zapta/daq/README.md

# Data Acquisition

| :warning: WARNING|
|:---|
| This design is an unverified work in progress (as of May 2023).|

* [Backplane](./backplane/README.md)
* [Proto board](./proto_board/README.md)
* [Controller board](./controller/README.md)
* [Power supply board](./power_supply/README.md)
