zapta/daq/controller/docs/packet_formats.odt

Controller Log Packet Format

June 2023

## Background

The controller logs the data it acquires on the SD card in a file that is made of a sequence of packets whose envelope conforms to the Serial Packet protocol. This document outlines the format of the payload data within those log packets.

Design decision #1: Time resolution of log events is 1ms.

Design decision #2: The data points are grouped by channels and the timestamp of data points of each channels are monotonic within the packet and across packets.

## Overall packet structure

The log packets are encoded as Serial Packets protocol packets of type LOG (packet type 3) which contain the following parts.

Packet Data:

- Packet Header
- Value Sequence 1
- …
- Value Sequence n

Each value sequence contains 1 or more values of a single channel, with fixed time interval between them. A packet can contain multiple value sequences of the same channel but they must be monotonic time-wise such as all values in a value sequence have later time that all values in all previous value sequences of same channel. There is not requirements for time monotonically for values of different channels.

Packet Header:

- UINT8: Packet format version. As of June 2023, the only valid version is 1.
- UINT32: Device session ID. A random 32 bits value is that generated each time the device reboots.
- UINT32 : Packet base time in milliseconds. This is a device time in milliseconds that is the base timestamp of this packet. These values wrap around after 50 days of device operations, and it’s responsibility of the reader to handle this wraparound gracefully. Typically is typically the time of the earliest event in the packet (time-wise, not by order within the packet), it’s not guaranteed.

Value Sequence

Each value sequence has the following format.

- STRING: Channel id. A short string that identify the channel. See below for the channel id string for each channel type.
- UINT16: First value offset in milliseconds. The time interval, in milliseconds, from the base time of the packet to the time of the first value in this sequence.
- UINT16: Number of values in this sequence. N >= 1.
- UINT16: (optional) Values interval. This is the time in milliseconds between two consecutive values in this sequence. This field should be included only iff number of values > 1.
- [Any]…: The values in this sequence. The format of the values depends on the channel and is specified below.

## Marker Channel Data

- Channel id “mrk”
- Item count: marker channel sequence contains exactly 1 value and thus doesn’t have the interval value.
- Sequence values: String values. Each string is represented by a UINT8 value representing the number of characters (not including null termination) followed by UINT8 with the individual ASCII character in their order in the string. As of July 2023, the marker strings are subject to these constrains:
  - Length 1 to 30 ASCII characters.
  - Valid characters are alphanumeric (lower and upper case) as well as ‘-’, ‘_’, ‘.’, or ‘:’. Other characters can be supported if needed.

## Load Cell Channels

- Channel ids: “lc1” to “lc9”
- Sequence values: big endian int24 values representing the raw ADC reading.

## Temperature Channel Data

- Channel ids: “tm1” to “tm9”
- Sequence values: big endian int24 values representing the raw ADC reading.

## Power Channel Data

- Channel ids: “pw1” to “pw9”
- Sequence values:
  - Big endian int16. Raw ADC reading of RMS voltage.
  - Big endian int16. Raw ADC reading of RMS current.
