zapta/daq/adc/docs/ADS1261-60 Design Calculator.xlsx

Sheet: Table of Contents
Worksheets | Description
Common-Mode Range | Calculates if a given set of input voltages are within the PGA's input range limitations
Code Conversions | Converts ADC codes to their corresponding voltages
Digital Filter | Calculates the digital filter's frequency response
CRC | Calculates the CRC byte
About | Information about this tool
Help | Documentation and supporting links

Sheet: Common-Mode Range
 |  |  |  |  |  |  |  |  |  |  |  |  | Table of Contents
 | 1) Configure ADC parameters
 | PGA Gain |  |  |  |  |  |  |  |  |  |  |  |  | Legend
 | PGA Gain | 2 | V/V |  |  | PGA INPUT |  |  | PGA OUTPUT |  |  |  | Input = | #
 | Supply Voltage(s) |  |  |  |  |  |  |  |  |  |  |  | Result = | #
4.75 V ≤ | AVDD | 5 | V | ≤ 5.25 V |  |  |  |  |  |  |  |  | Invalid Parameter = | #
-2.6 V ≤ | AVSS | 0 | V | ≤ 0 V
 | Reference Voltage(s)
0.9 V ≤ | VREFP | 2.5 | V | ≤ 5 V
-0.05 V ≤ | VREFN | 0 | V | ≤ 1.6 V
 | 2) Define input voltages
 | Input Voltage
 | Input Mode | Differential/CM Voltages
-1.25 V ≤ | VIN_DIFF | 1 | V | ≤ 1.25 V
1.3 V ≤ | VIN_CM | 2.5 | V | ≤ 3.7 V
 | 3) Check for errors
 | Error messages |  |  |  |  | PGA Input |  |  |  | PGA Output
 | V(AVDD-AVSS) | ← Supply voltage(s) is out-of-range! |  |  | 0.8667 V ≤ | VINP | 3 | ≤ 3.25 V | 0.3 V ≤ | VOUTP | 3.5 | ≤ 4.7 V
 | V(REFP-REFN) | ← Reference voltage(s) is out-of-range! |  |  |  | VINN | 2 |  |  | VOUTN | 1.5
 | VIN_DIFF | ← Input exceeds the maximum differential voltage (±1.25 V)! |  |  | -1.25 V ≤ | VIN_DIFF | 1 | ≤ 1.25 V | -2.5 V ≤ | VOUT_DIFF | 2 | ≤ 2.5 V
 | VINP | ← Positive input voltage is out-of-range! |  |  | 1.3 V ≤ | VIN_CM | 2.5 | ≤ 3.7 V |  | VOUT_CM | 2.5
 | VINN | ← Negative input voltage is out-of-range!

Sheet: Code Conversions
 |  |  |  |  |  |  | Table of Contents
 |  |  |  |  |  |  |  | Legend
ADC Parameters |  |  |  | ADC Input Range & Least Significant Bit (LSB) Size |  |  | Input = | #
PGA Gain | 1 | [V/V] | → | Differential Input Range | +/-2.50 | [V] | Result = | #
Reference Voltage | 2.50 | [V] |  | LSB size | 298.023 | [nV]
ADC Output Code (2's Compliment) |  |  |  | Input Voltage RTI (1)
7F0000 |  | [Hex] | → | 2.480468750 |  | [V]
Input a hex value between 800000 and 7FFFFF
Differential Input Voltage RTI (1) |  |  |  | Ideal Output Code (2)
1.000000000 |  | [V] | → | 333333 |  | [Hex]
 |  |  |  | Output Code Clipped!
Notes:
(1) "RTI" means "referred to input" (i.e. the voltage applied to the input pins, prior to the PGA gain)
(2) Ideal output code (i.e. ignoring the effects of noise, INL, calibration, etc.)

Sheet: Digital Filter
 |  |  |  |  |  |  |  |  | Table of Contents
 |  |  |  |  |  | NOTE: The effect of averaging from chopping or ac-excitation modes is not shown in the filter response.
MODE0 Settings |  |  |  |  |  |  |  |  | Legend
DR[4:0] - nominal data rate (SPS) |  |  | 20 |  |  |  |  | Input = | #
FILTER[2:0] - filter type |  |  | FIR |  |  |  |  | Result = | #
 |  |  |  |  |  |  |  | Frequency Resolution
MODE1 Settings |  |  |  |  |  |  |  | Range | Step size
CHOP[1:0] - chop mode |  |  | Normal mode (default) |  |  |  |  | 0-100 Hz | 0.1 Hz
CONVRT - conversion mode |  |  | Continuous mode (default) |  |  |  |  | 100-1000 Hz | 1 Hz
DELAY[3:0] - conversion start delay |  |  | 50 μs (default) |  |  |  |  | 1000-50,000 Hz | 10 Hz
 |  |  |  |  |  |  |  | 50k - 100 kHz | 100 Hz
 |  |  |  |  |  |  |  | 100k - 1.4 MHz | 1000 Hz
Clock |  |  |  |  |  |  |  | > 1.4 MHz | no data
Clock Frequency, fCLK (MHz) |  |  | 7.3728 MHz |  |  |  |  | Note: Due to larger step sizes, the "Digital Filter Frequency Response" plot may appear distorted or lack detail at higher frequencies.
Notes:
- The actual data rate and /DRDY period will scale with the clock frequency.
- The internal oscillator automatically increases to 10.24 MHz @ 40 kSPS.
- The "Clock Frequency" field only needs to be changed if you are using an external clock source with a different frequency, or if you are evaluating the effects of the clock frequency tolerance on the digital filter response.
 |  |  |  |  |  |  | Right click on the x-axis to adjust the displayed frequency range…
Bandwidth |  |  |  |  |  | Digital Filter Block Diagram
-3 dB Cutoff Frequency (Hz) |  |  | 13.20
Effective Noise Bandwidth (Hz) |  |  | 13.94
Normal Mode Rejection
Frequency (Hz) |  |  | 60
Tolerance (± Δ Hz) |  |  | 1
Minimum Attenuation |  |  | -95.15 dB
(59 - 61 Hz)
Conversion Time & Period |  |  | (ms) |  | (SPS)
Time to 1st Conversion (1)(4) |  |  | 52.23 | = | 19.15
On-going Conversion Period (2)(4) |  |  | 50.00 | = | 20.00
Time to conversion graph data
X
0.00 | 52.23 | 102.23 | 152.23 | 202.23 | 252.23
0 | 52.23 | 102.23 | 152.23 | 202.23 | 252.23
Y
0.00 | 0 | 0 | 0 | 0 | 0
1 | 1 | 1 | 1 | 1 | 1
(1) This is the latency of the first conversion result. When multiplexing between channels, this latency limits the overall data throughput and effective data rate.
(2) Time between conversion results. This is the data rate for single channel, continuous conversions.
(3) For continous conversion mode, only the first 5 conversions are shown.
(4) Calculated results are within about +/- 30 us of actual device behavior, not accounting for clock errors.

Sheet: CRC
 |  |  |  |  |  |  |  |  |  |  |  |  |  |  |  |  |  |  |  |  |  |  |  |  |  |  |  |  |  |  |  |  |  |  |  |  | Table of Contents
 | Legend |  | Input hex data (without the prefix or postfix)
 | # | = Input | Hex Data (1 to 4 bytes) |  |  |  |  |  | 3300
 | # | = Result | NOTE: If needed, add an apostrophy (') before the number to avoid Excel's type conversion.
 |  |  | Calculated Results
 |  |  | # Bytes / CRC-n |  |  |  |  |  | 2
 |  |  | CRC Result (Hex) |  |  |  |  |  | 0x11
↓ Calculations ↓
 |  |  |  |  |  |  |  |  |  |  |  |  |  | Polynomial = |  |  |  | x8 + x2 + x1 + 1
 |  |  |  |  | Each column represents a bit shift in the CRC shift register →
 |  |  |  |  | CRC-1 |  |  |  |  |  |  |  | CRC-2 |  |  |  |  |  |  |  | CRC-3 |  |  |  |  |  |  |  | CRC-4
 |  |  | Data IN: |  | 0 | 0 | 1 | 1 | 0 | 0 | 1 | 1 | 0 | 0 | 0 | 0 | 0 | 0 | 0 | 0 | - | - | - | - | - | - | - | - | - | - | - | - | - | - | - | -
 |  |  | MSB | 1 | 1 | 1 | 1 | 1 | 1 | 0 | 1 | 0 | 1 | 1 | 0 | 1 | 0 | 1 | 1 | 0 | - | - | - | - | - | - | - | - | - | - | - | - | - | - | - | -
 |  |  | Initial Data | 1 | 1 | 1 | 1 | 1 | 0 | 1 | 0 | 1 | 1 | 0 | 1 | 0 | 1 | 1 | 0 | 0 | - | - | - | - | - | - | - | - | - | - | - | - | - | - | - | -
 |  |  |  | 1 | 1 | 1 | 1 | 0 | 1 | 0 | 1 | 1 | 0 | 1 | 0 | 1 | 1 | 0 | 0 | 0 | - | - | - | - | - | - | - | - | - | - | - | - | - | - | - | -
 |  |  |  | 1 | 1 | 1 | 0 | 1 | 0 | 1 | 1 | 0 | 1 | 0 | 1 | 1 | 0 | 0 | 0 | 1 | - | - | - | - | - | - | - | - | - | - | - | - | - | - | - | -
 |  |  |  | 1 | 1 | 0 | 1 | 0 | 1 | 1 | 0 | 1 | 0 | 1 | 1 | 0 | 0 | 0 | 1 | 0 | - | - | - | - | - | - | - | - | - | - | - | - | - | - | - | -
 |  |  |  | 1 | 0 | 1 | 0 | 1 | 1 | 0 | 1 | 0 | 1 | 1 | 0 | 0 | 0 | 1 | 0 | 0 | - | - | - | - | - | - | - | - | - | - | - | - | - | - | - | -
 |  |  |  | 1 | 0 | 0 | 1 | 0 | 1 | 0 | 0 | 1 | 0 | 1 | 0 | 1 | 1 | 1 | 1 | 0 | - | - | - | - | - | - | - | - | - | - | - | - | - | - | - | -
 |  |  | LSB | 1 | 1 | 1 | 0 | 0 | 1 | 1 | 1 | 0 | 0 | 1 | 1 | 0 | 1 | 0 | 1 | 1 | - | - | - | - | - | - | - | - | - | - | - | - | - | - | - | -
 |  |  | Result: |  | - |  |  |  |  |  |  |  | 0x11 |  |  |  |  |  |  |  | - |  |  |  |  |  |  |  | -
 |  |  |  |  | Each column represents a bit shift in the CRC shift register. The last column in each byte is the result of the CRC-n calculation.

Sheet: About
Version Number | 1.0.2 | Table of Contents
Created by | Chris Hall
Version History
Version | Change List Description
1.0.0 | Initial Release
1.0.1 | Fixed error in data rate calculation when chop/ac excitation mode enabled
1.0.2 | Fixed error in input signal limits in the Common-Mode Range calculator.

Sheet: Help
For any futher assistance on this tool, please post your question in the following forum - E2E Precision Data Converters Forum (http://e2e.ti.com/support/data_converters/precision_data_converters/) |  |  |  | Table of Contents
Getting Started with this tool ?
 | 1. Reference the product datasheet, found at the URLs below, for information about the particular device.
 |  | ADS1261: | http://www.ti.com/lit/gpn/ads1261
 |  | ADS1260 | http://www.ti.com/lit/gpn/ads1260
 | 2. Go to the Table of Contents for tool descriptions and links to specific worksheets.
 |  | Link: | Table of Contents
 | 3.Use the "Legend" on each worksheet for guidance. The required inputs and calculated results typically follow the convention below:
 |  | # | = Input
 |  | # | = Result
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
