zapta/daq/controller/docs/sdcard_spi_ioc.png

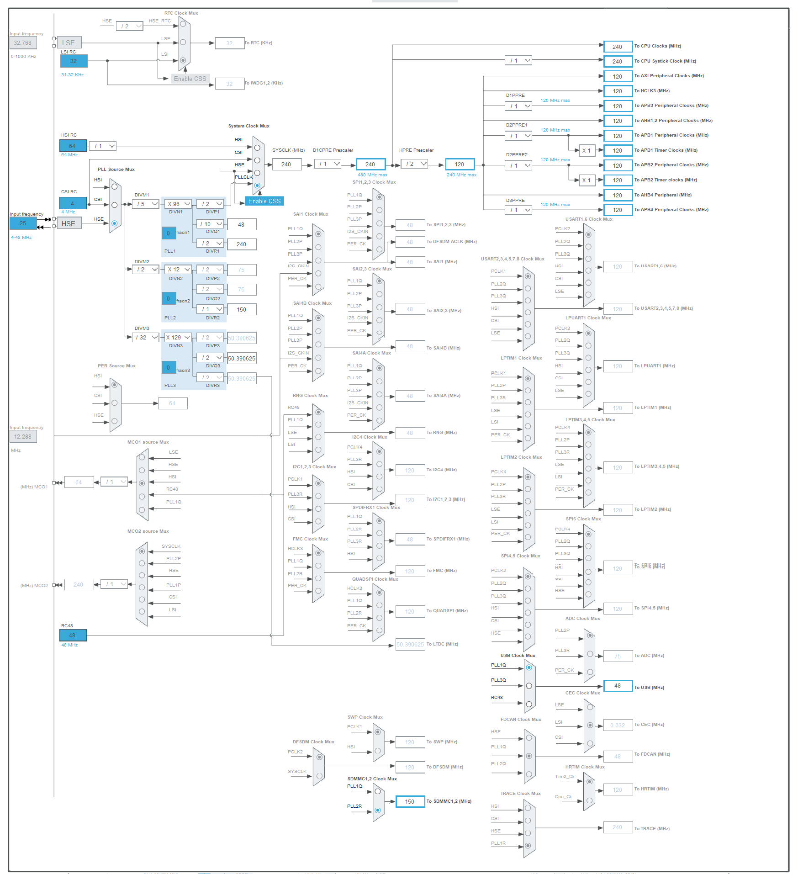
controller/docs/sdcard_spi_ioc.png
