zapta/daq/hookup_board/kicad/hookup_board.png

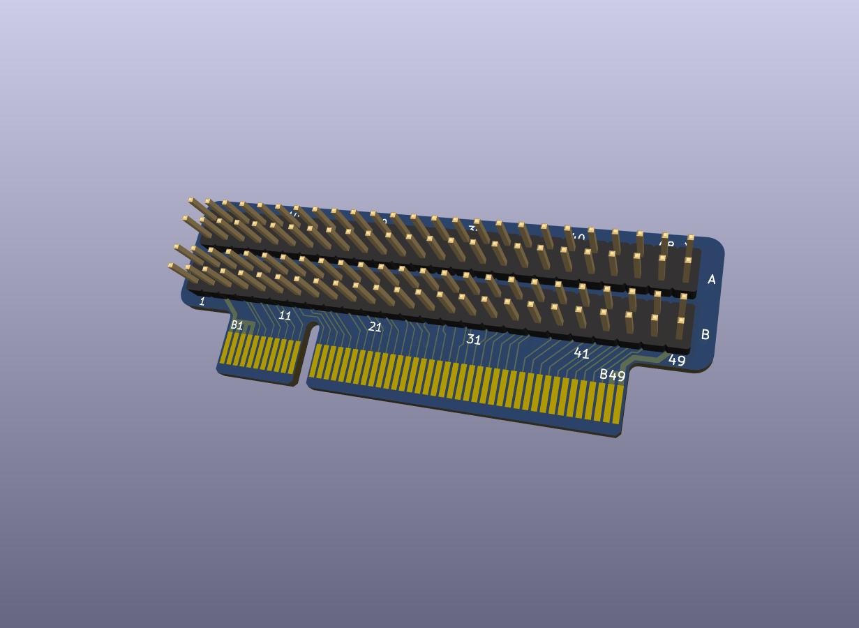
hookup_board/kicad/hookup_board.png
