zapta/daq/proto_board/kicad/JLCPCB/version_0_2/bom.csv

Designator | Footprint | Quantity | Value | LCSC Part #
J1 | PCIE_98_CARD | 1 | pcie_98
J2, J3 | PinHeader_2x25_P2.00mm_Vertical_SMD | 2 | Conn_02x25_Odd_Even
