zapta/daq/power_supply/kicad/3d_models/DC_DC_MODEL.step

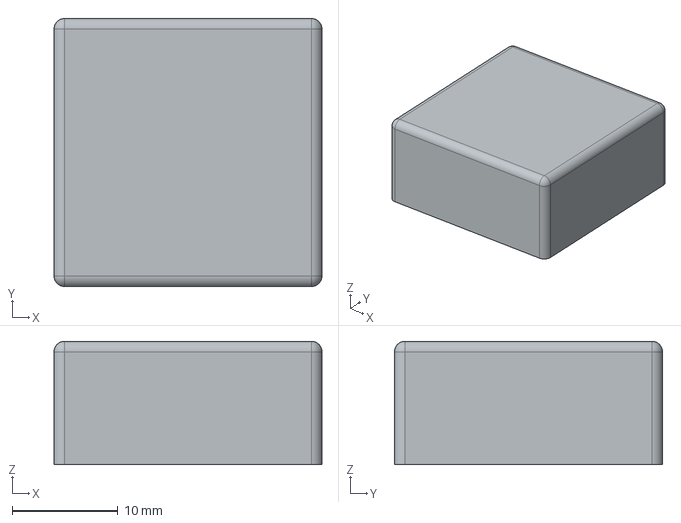
[picture p15: CAD file, 2023-05-20]
power_supply/kicad/3d_models/DC_DC_MODEL.step
25.4 x 25.4 x 11.7 mm
