zapta/daq/common/kicad/3d_models/biode_bridge_MBS10.step

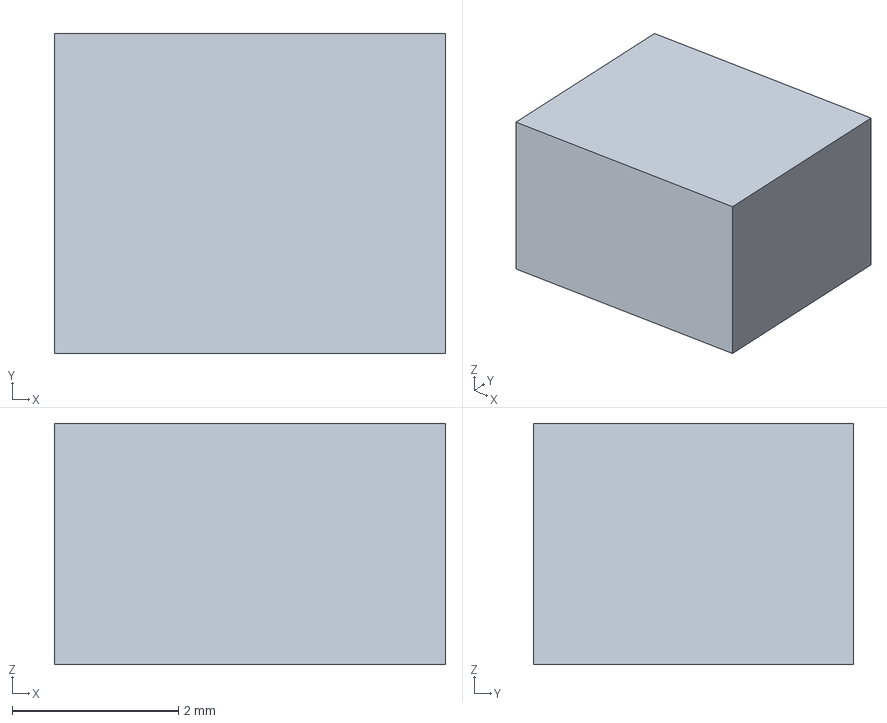
[picture p16: CAD file, 2023-11-16]
common/kicad/3d_models/biode_bridge_MBS10.step
4.70 x 3.85 x 2.90 mm
