zapta/daq/common/kicad/3d_models/B0505MT-1WR4.step

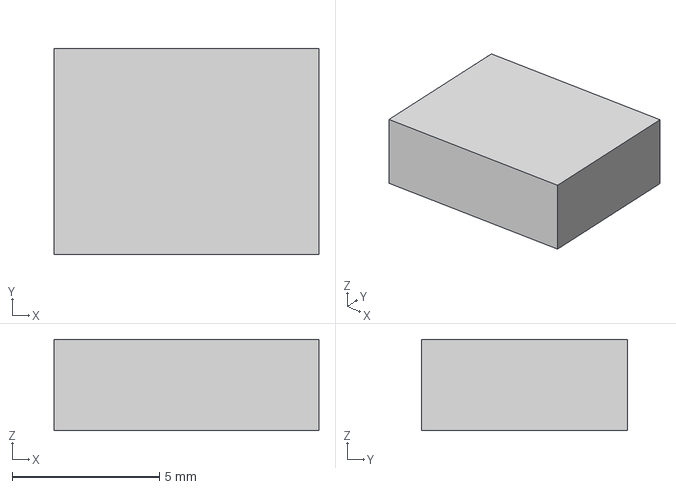
[picture p17: CAD file, 2023-07-28]
common/kicad/3d_models/B0505MT-1WR4.step
9.00 x 7.00 x 3.10 mm
