zapta/daq/common/kicad/3d_models/esd_diode_x4.step

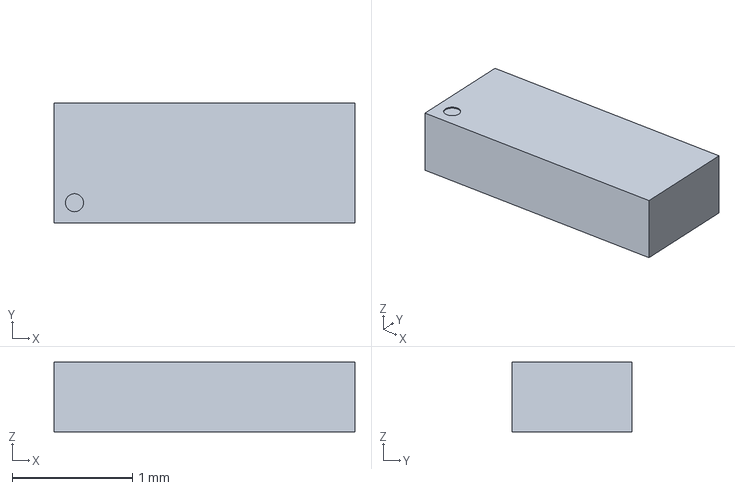
[picture p18: CAD file, 2023-05-19]
common/kicad/3d_models/esd_diode_x4.step
2.50 x 1.00 x 0.58 mm
