zapta/daq/backplane/kicad/3d_models/screw_terminal.step

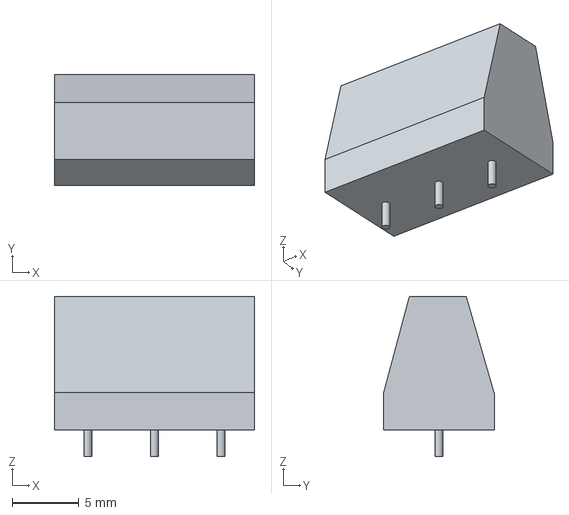
[picture p19: CAD file, 2023-07-19]
backplane/kicad/3d_models/screw_terminal.step
15.0 x 8.30 x 12.0 mm
