zapta/daq/common/kicad/3d_models/D050505T-1WR4.step

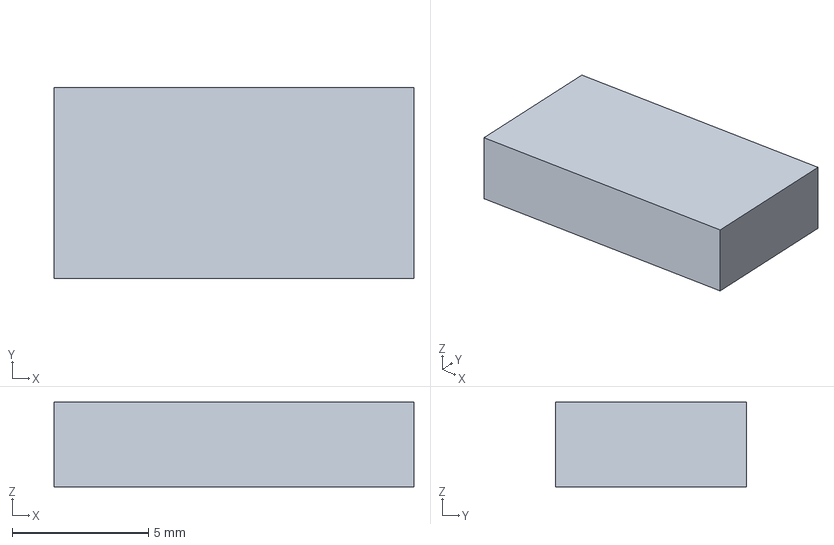
[picture p20: CAD file, 2023-11-16]
common/kicad/3d_models/D050505T-1WR4.step
13.2 x 7.00 x 3.10 mm
