zapta/daq/controller/TODO.txt

* Add EEPROM board for test id allocation.

* Verify with logic analyzer that the data link is not saturated.

* Support commands such as start/stop recording from the duet controller link.

------

* Use  MUST_USE_VALUE where applicable.
