zapta/daq/heater/kicad/heater.pdf

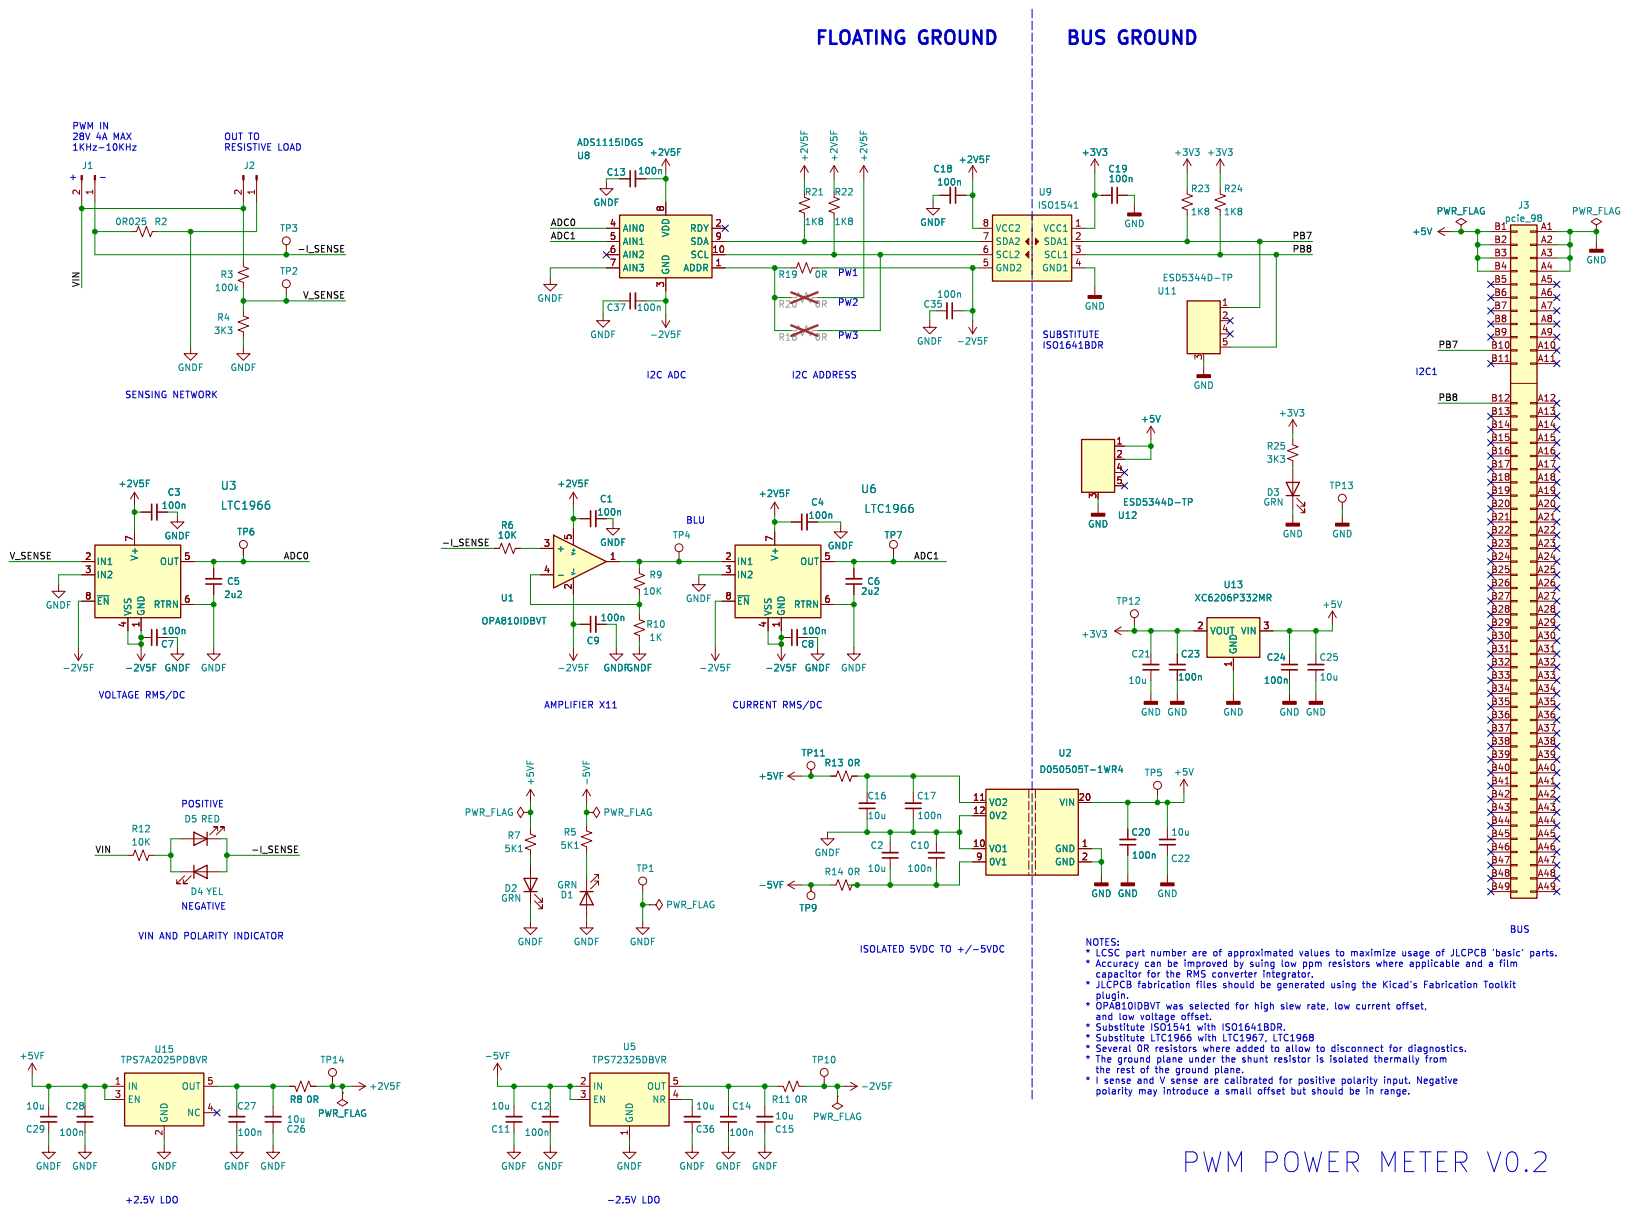
[picture p21: page 1]

2 EN 3 NC 4 OUT 5 U15 TPS7A2025PDBVR GNDF C28
