zapta/daq/controller/kicad/controller.pdf

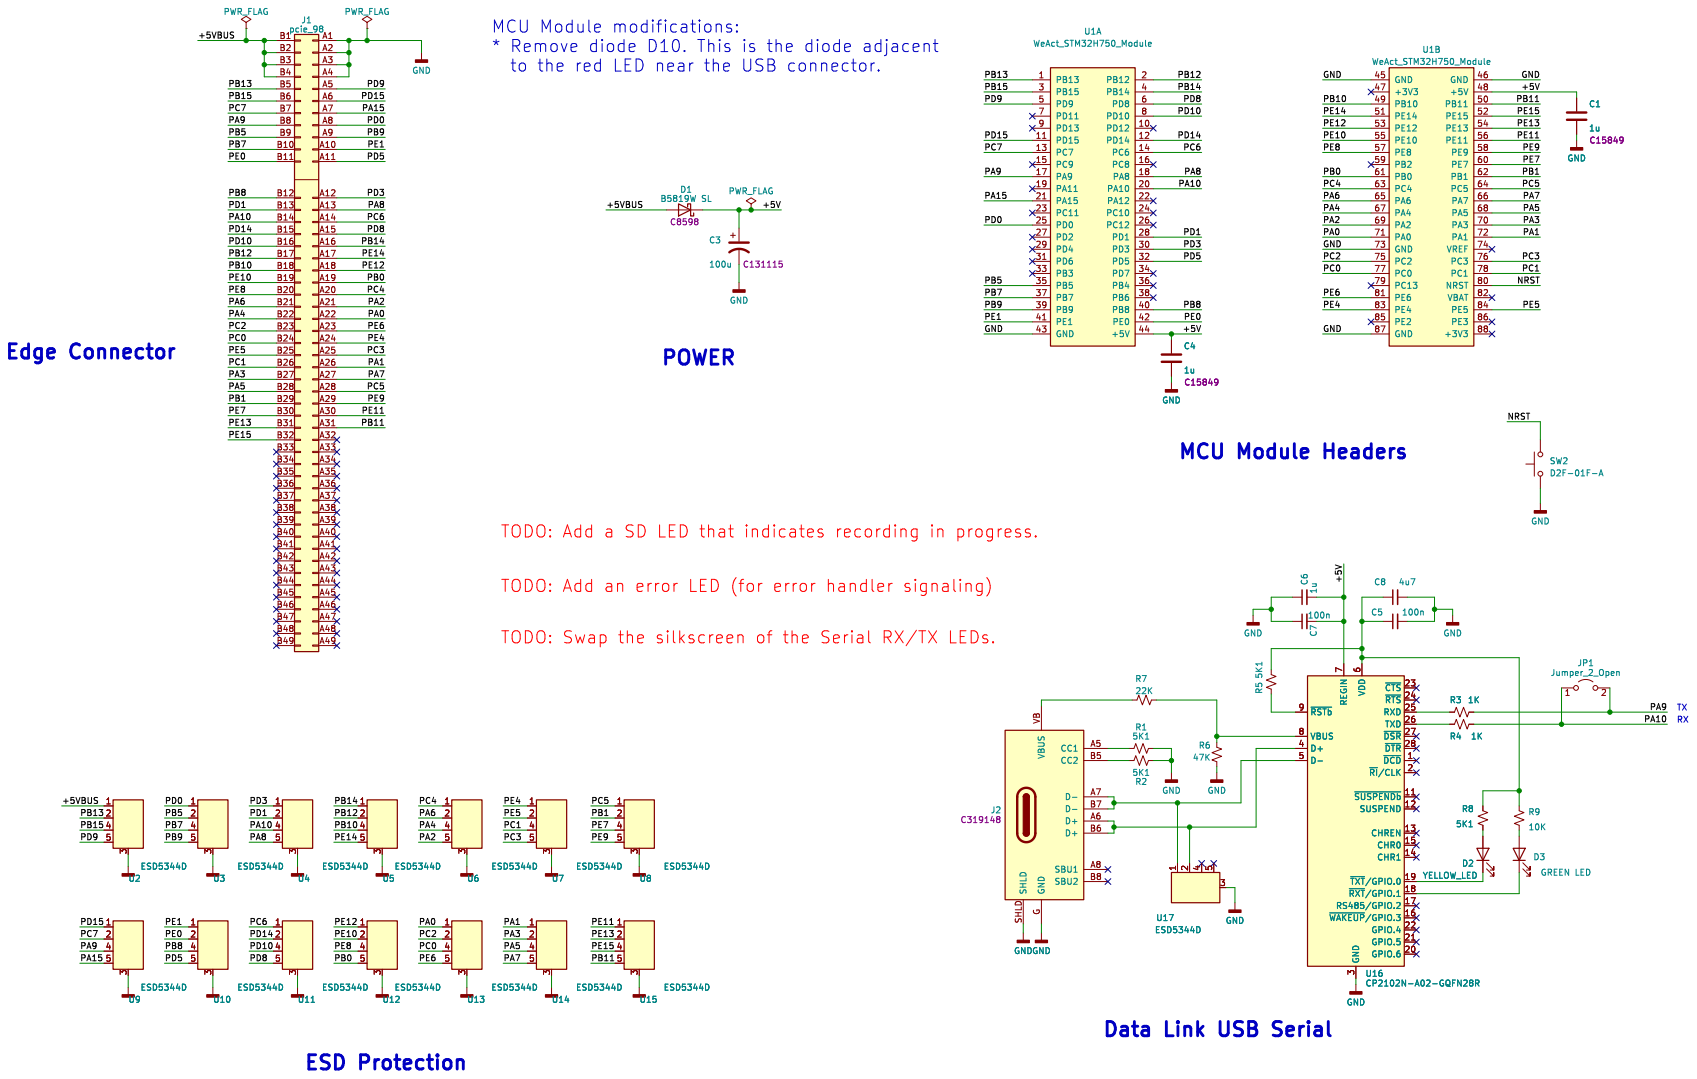
[picture p22: page 1]

MCU Module modifications: * Remove diode D10. This is the diode adjacent

to the red LED near the USB connector.

GND
TX MCU Module Headers

TODO: Add an error LED (for error handler signaling)

Data Link USB Serial
