zapta/daq/adc/kicad/adc.pdf

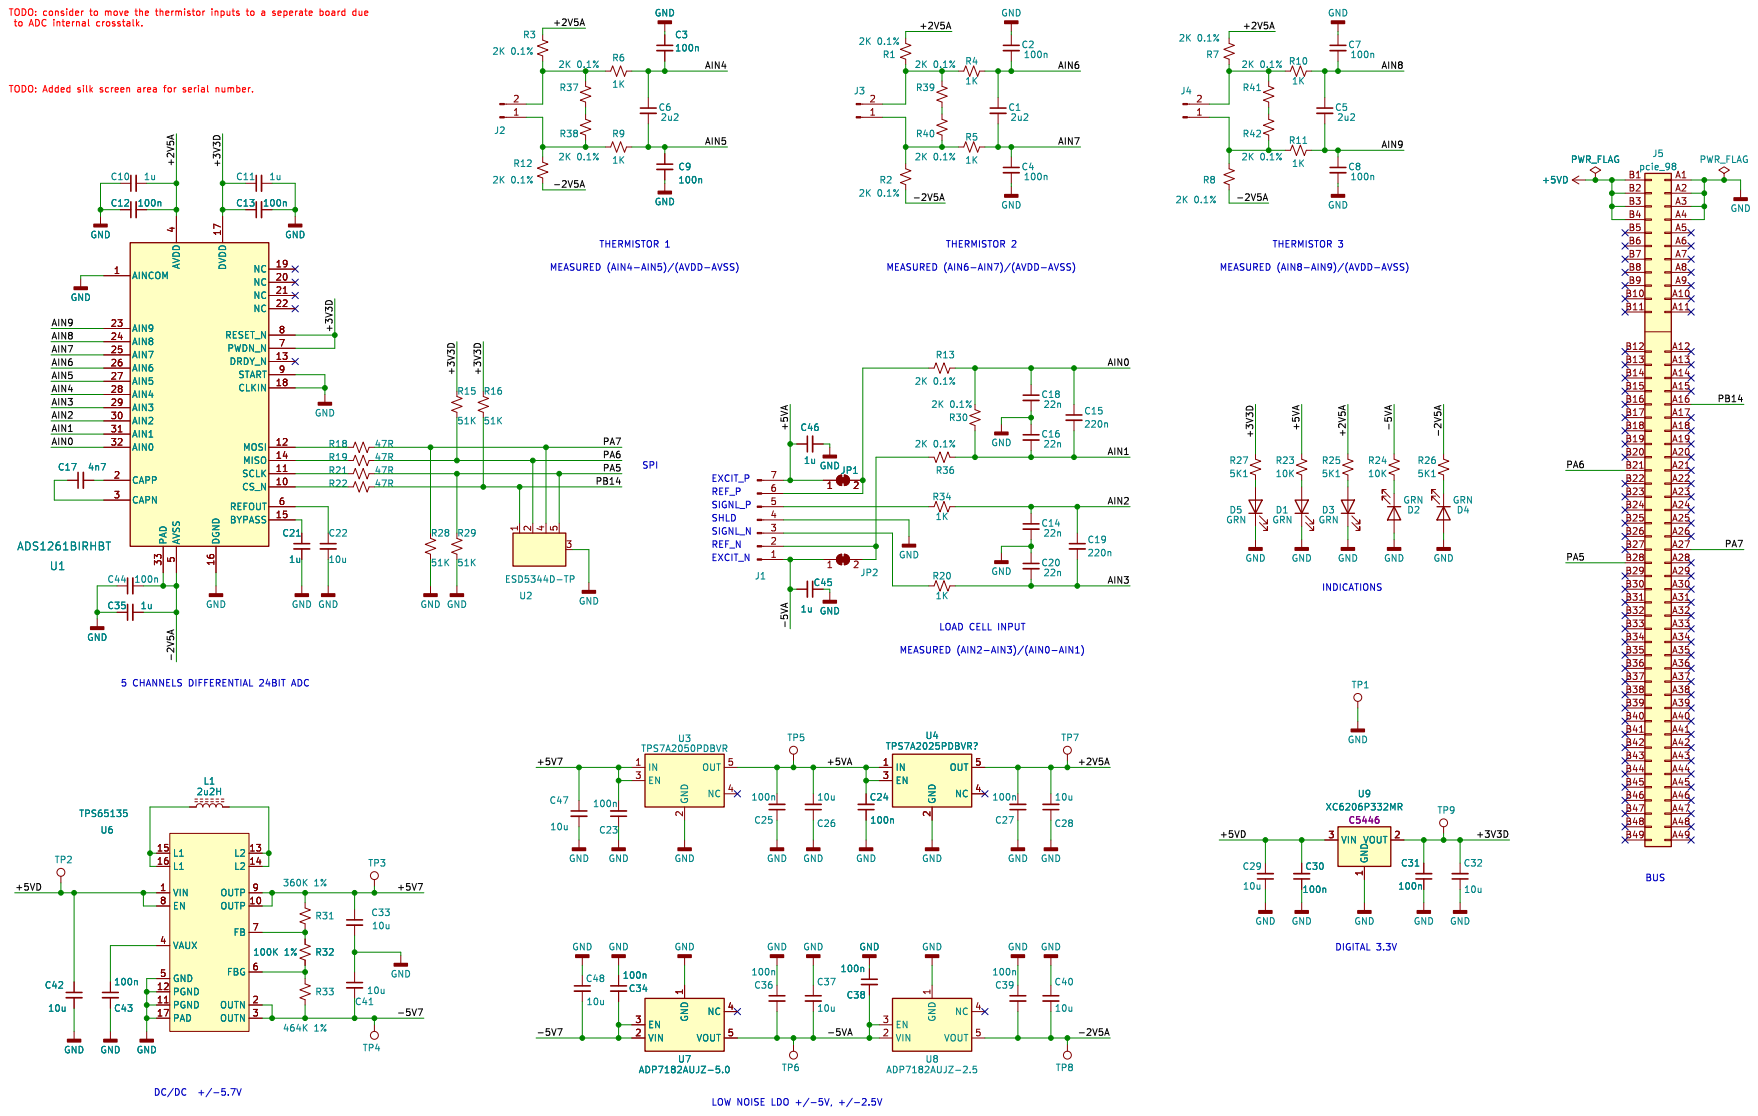
[picture p23: page 1]

-2V5A MEASURED (AIN8-AIN9)/(AVDD-AVSS) LOAD CELL INPUT SIGNL_N

4 REFOUT 6 PWDN_N 7 RESET_N 8 START 9 MOSI 12 MISO 14 BYPASS 15 CAPP 2 CAPN 3 PAD 33 AVSS

2 EN 3 NC 4 OUT 5 U3 TPS7A2050PDBVR GND GND GND

1 VIN 2 EN 3 NC 4 VOUT 5 U8 ADP7182AUJZ-2.5 C47

1 VIN 2 EN 3 NC 4 VOUT 5 U7 ADP7182AUJZ-5.0 C48

1 VIN 2 EN 3 NC 4 VOUT 5 C34
