zapta/daq/backplane/kicad/backplane.pdf

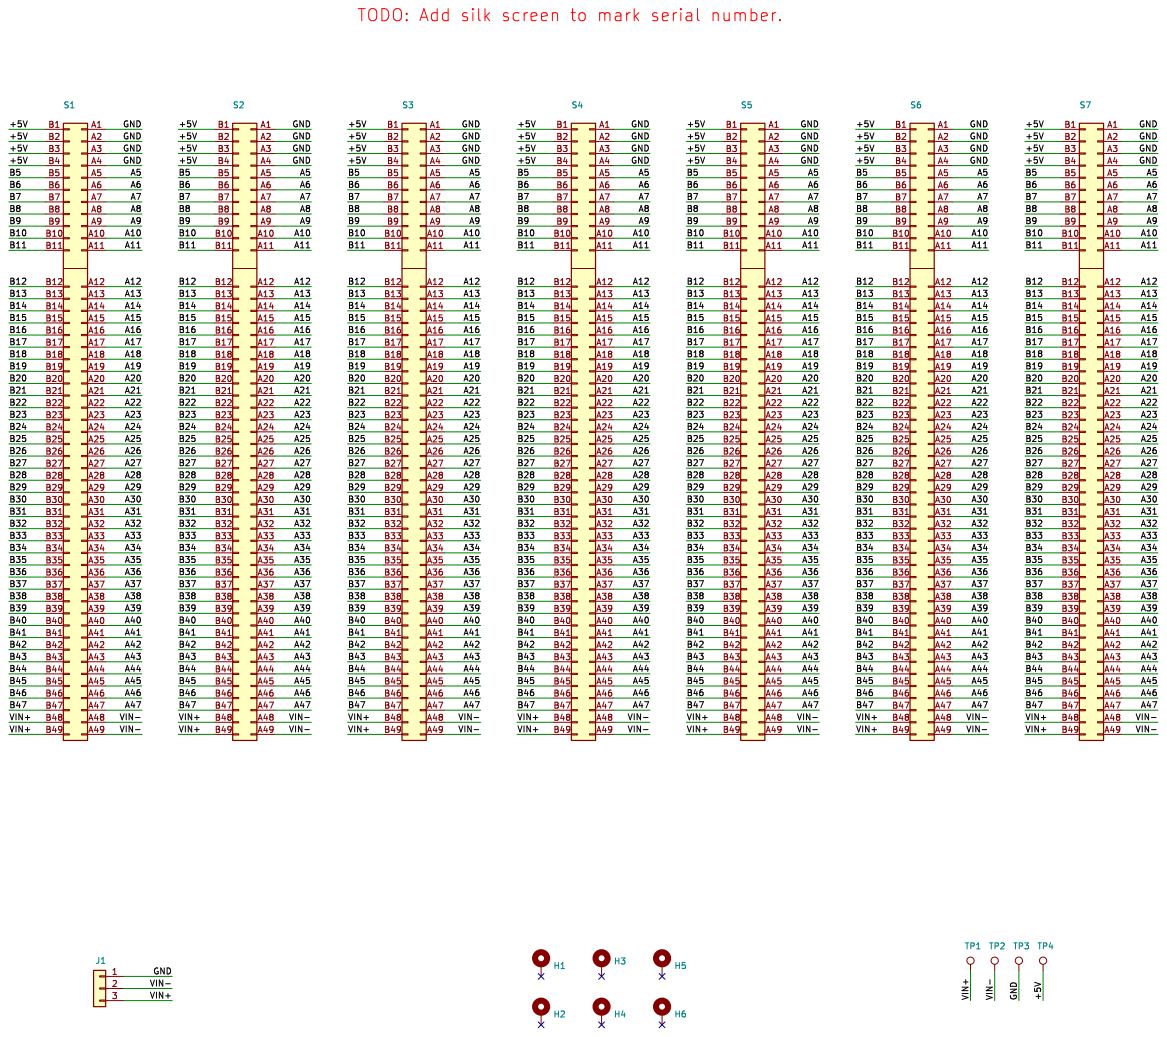
[picture p24: page 1]

+5V TODO: Add silk screen to mark serial number.
