zapta/daq/power_supply/kicad/power_supply.pdf

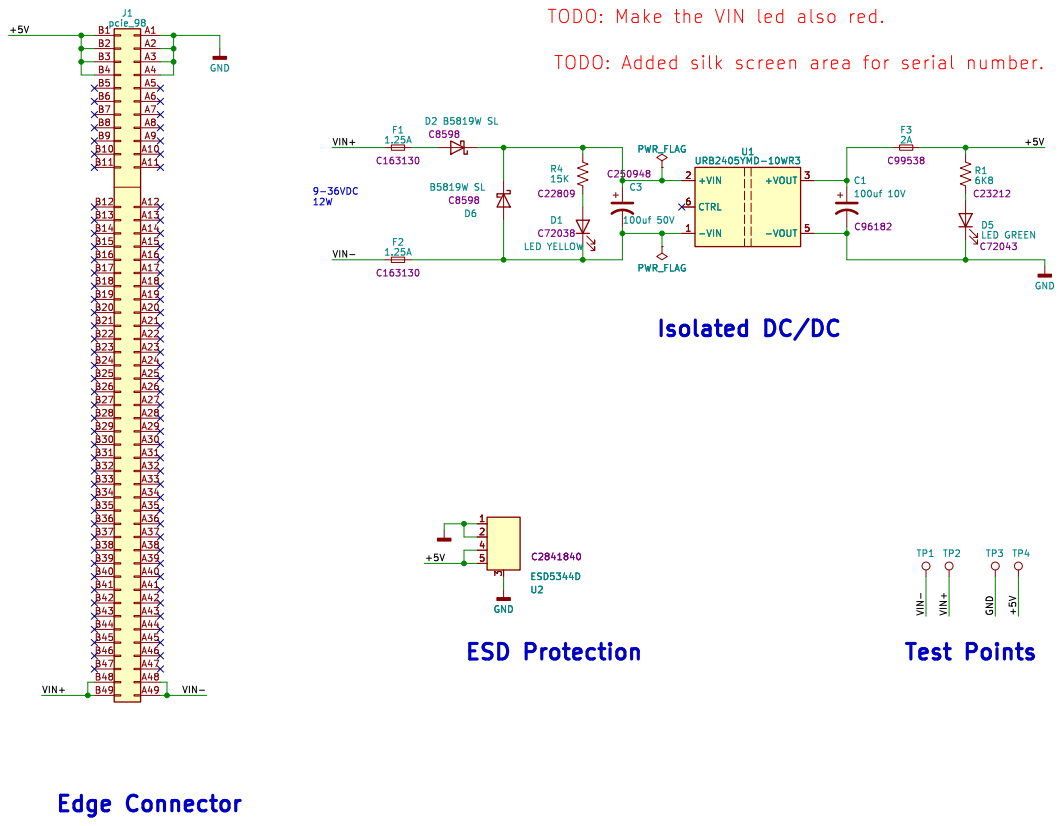
[picture p25: page 1]

TODO: Make the VIN led also red.

TODO: Added silk screen area for serial number.
