zapta/daq/hookup_board/kicad/hookup_board.pdf

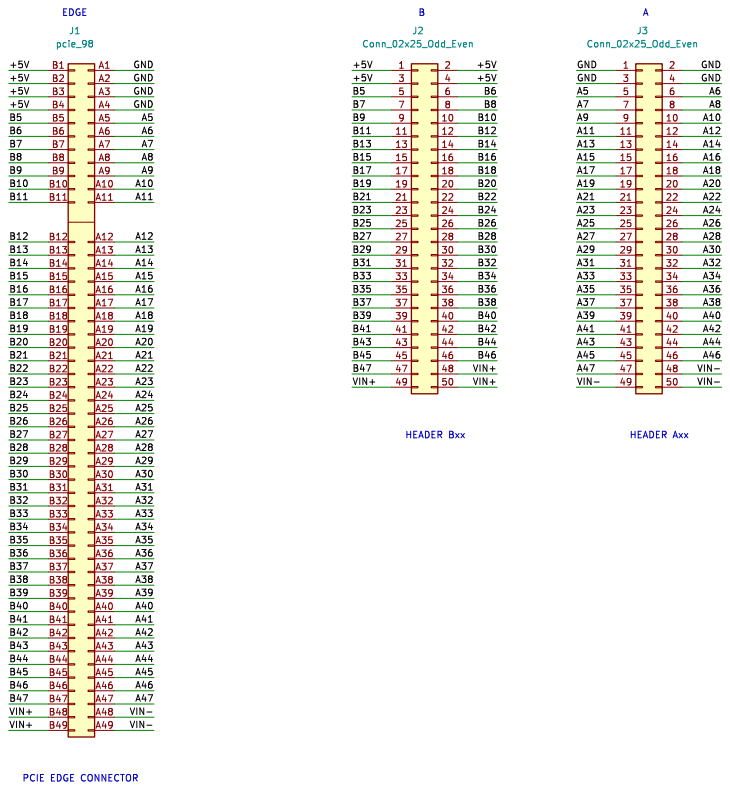
[picture p26: page 1]
