zapta/daq/proto_board/kicad/proto_board.pdf

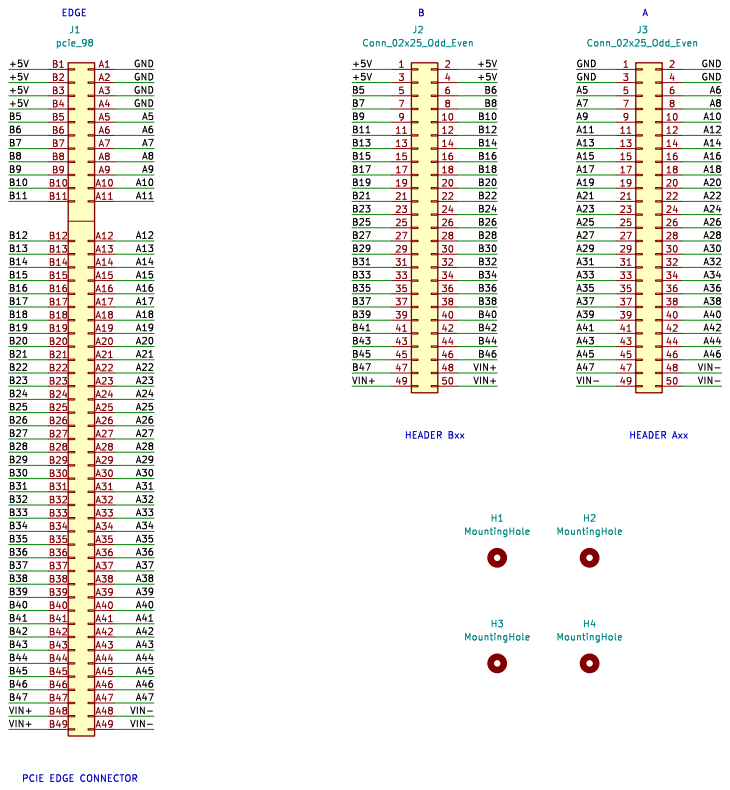
[picture p27: page 1]
