zapta/daq/hookup_board/kicad/hookup_board_pcb.pdf

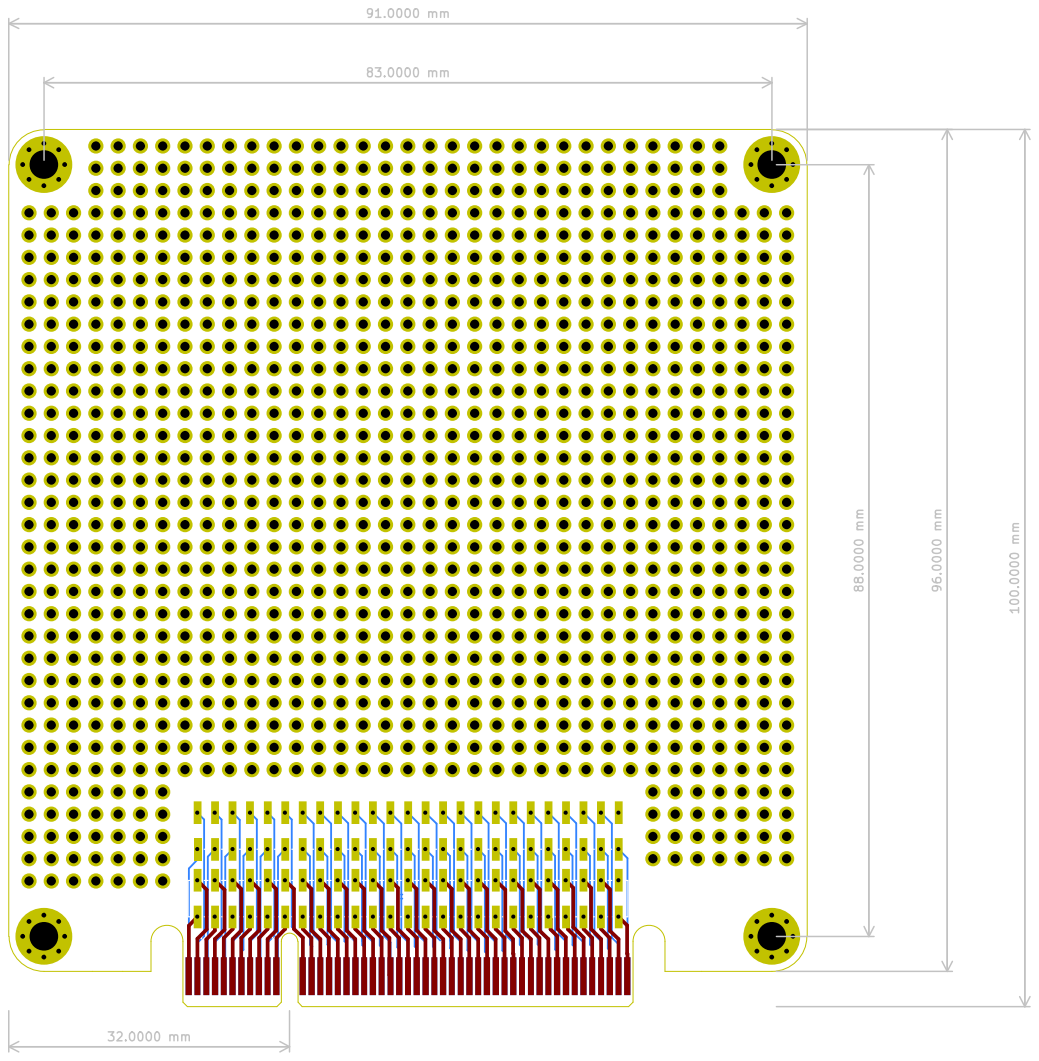
[picture p28: page 1]
