zapta/daq/heater/kicad/heater.kicad_pcb

## KiCad design heater/kicad/heater.kicad_pcb (2023-12-14)

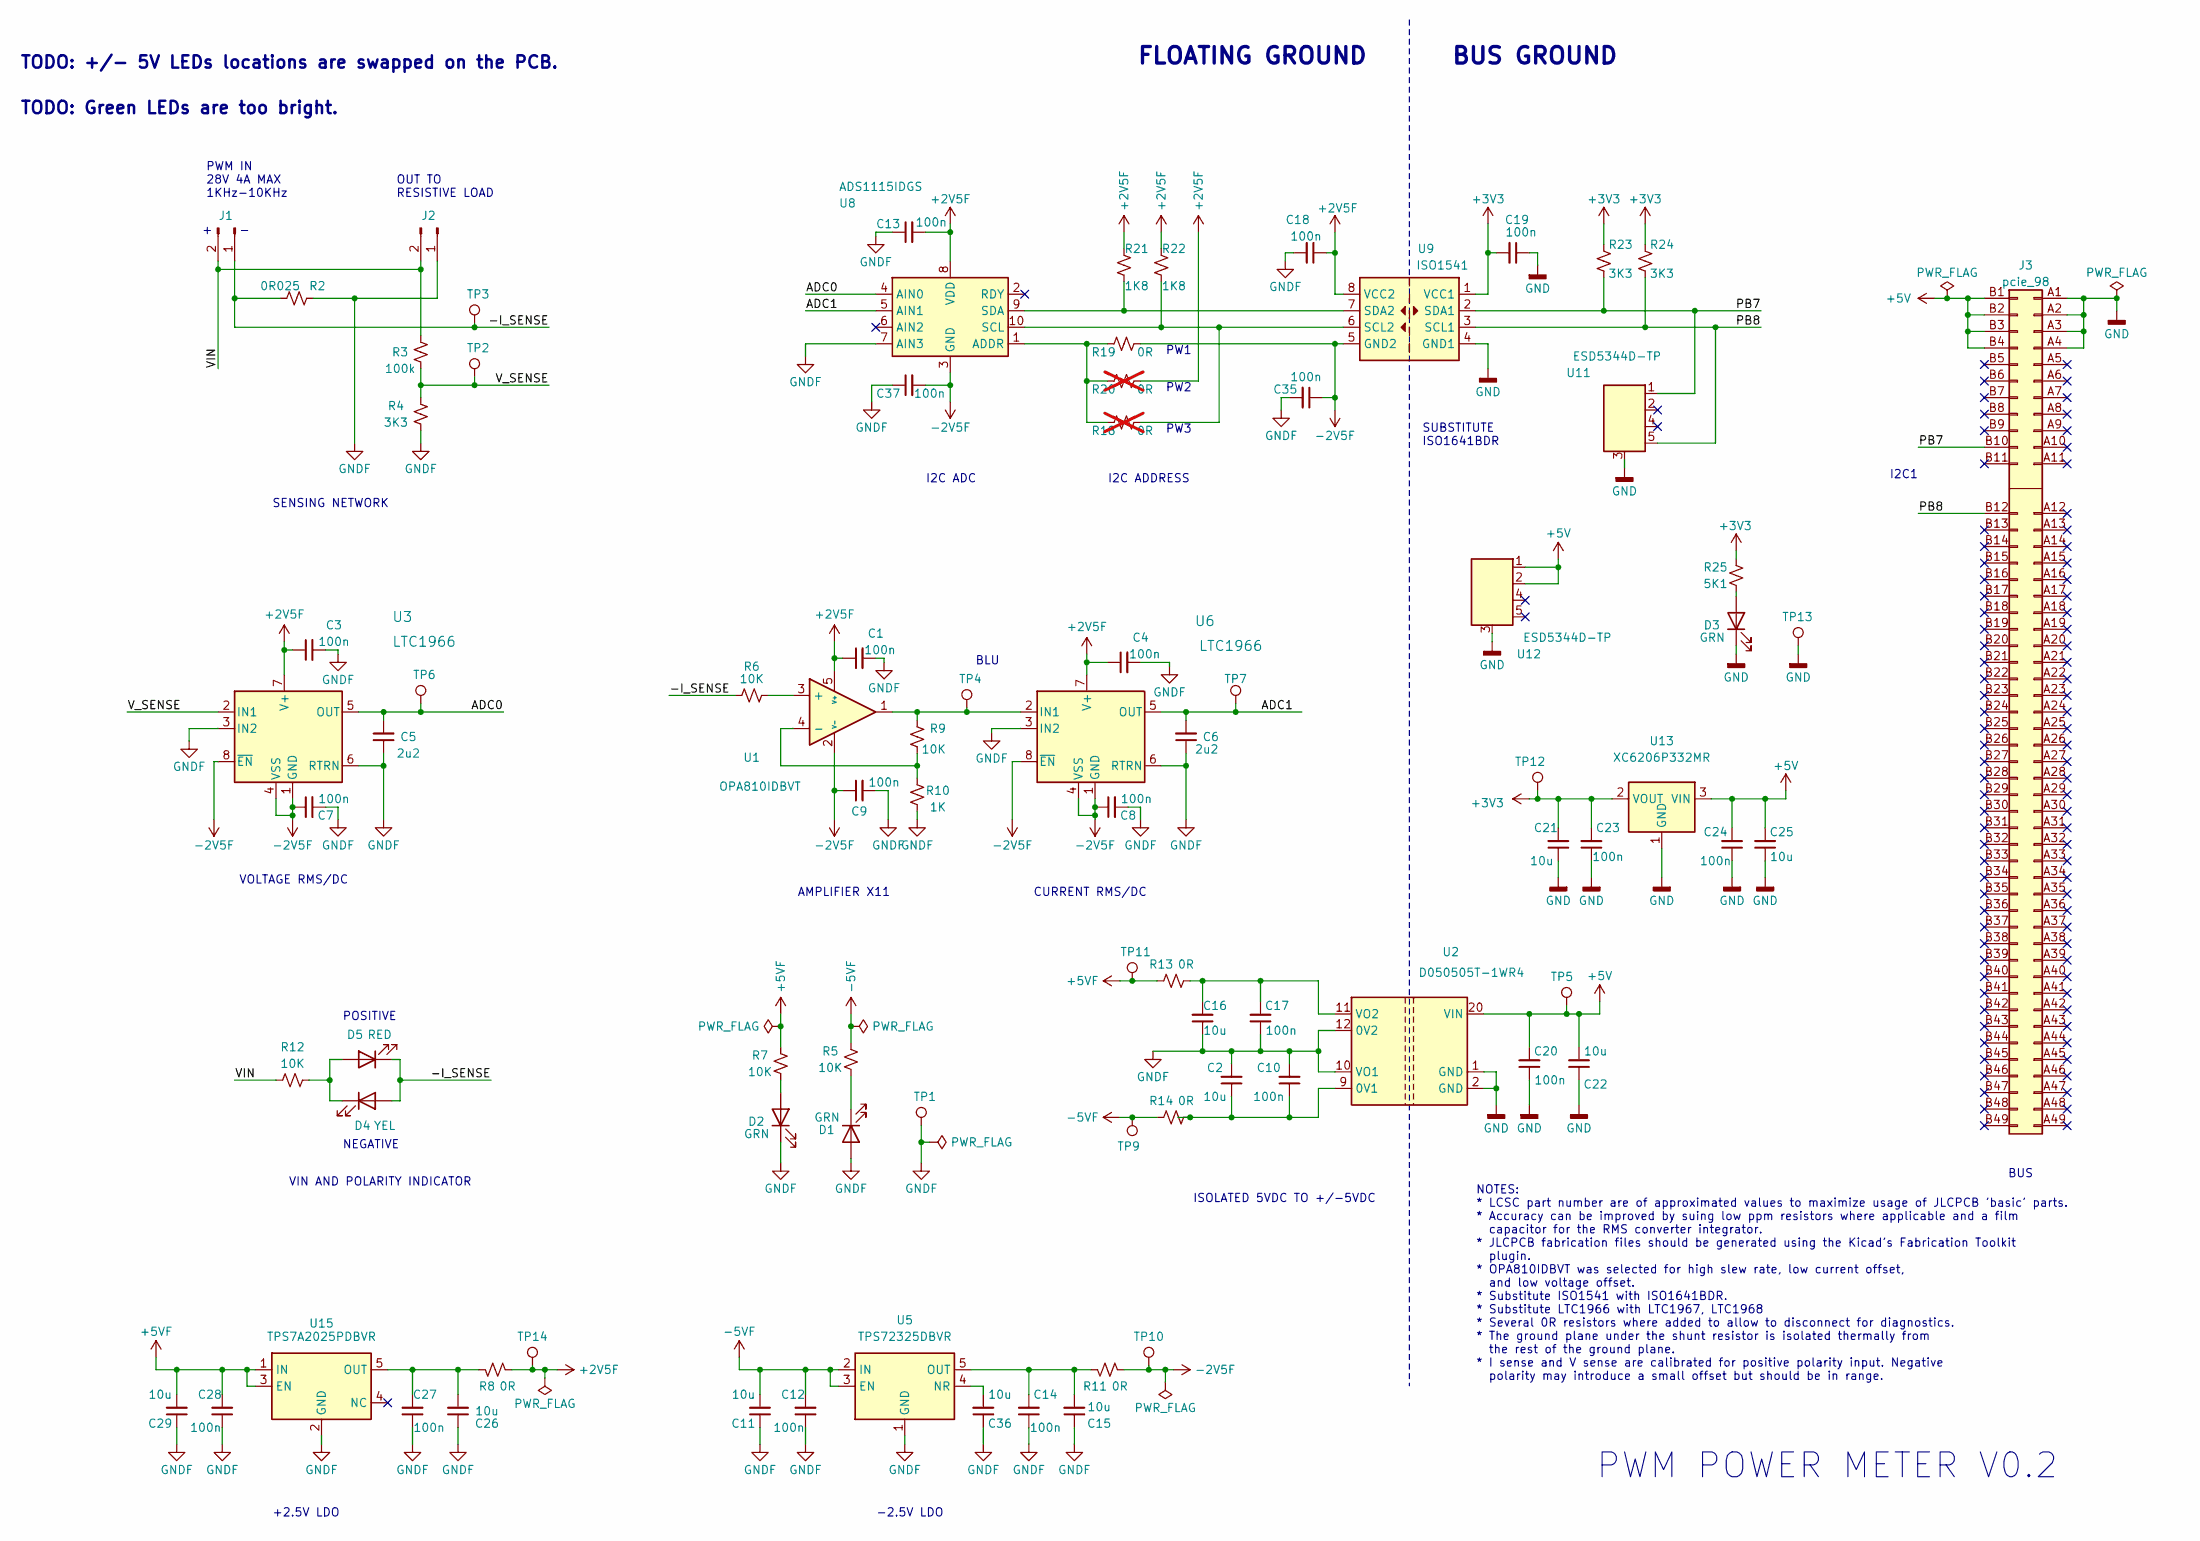
[picture p29: schematic heater.kicad_sch, PWM Power Measurement Card.]

Parts:
C1, C3, C4, C7, C8, C9, C10, C12, C13, C14, C17, C18, C19, C20, C23, C24, C27, C28, C35, C37: 100n; C_0402_1005Metric; LCSC C1525
C2, C11, C15, C16, C21, C22, C25, C26, C29, C36: 10u; C_0603_1608Metric; LCSC C19702
C5, C6: 2u2; C_0805_2012Metric; LCSC C377773
D1, D2, D3: GRN; LED_0603_1608Metric; LCSC C72043
D4: YEL; LED_0603_1608Metric; LCSC C72038
D5: RED; LED_0603_1608Metric; LCSC C2286
J1, J2: Conn_01x02_Pin; JST_VH_2_CHINESE; LCSC C2845758
J3: pcie_98; PCIE_98_CARD; LCSC DNP
R2: 0R025; R_2512_6332Metric; LCSC C252687
R3: 100k; R_0402_1005Metric; LCSC C25741
R4: 3K3; R_0402_1005Metric; LCSC C25890
R5, R7: 10K; R_0402_1005Metric
R6, R9, R12: 10K; R_0402_1005Metric; LCSC C25744
R8, R11, R13, R14, R19: 0R; R_0402_1005Metric; LCSC C17168
R10: 1K; R_0402_1005Metric; LCSC C11702
R18, R20: 0R; R_0402_1005Metric; LCSC C17168; not fitted
R21, R22: 1K8; R_0402_1005Metric; LCSC C4109
R23, R24: 3K3; R_0402_1005Metric
R25: 5K1; R_0402_1005Metric
TP1, TP2, TP3, TP4, TP5, TP6, TP7, TP9, TP10, TP11, TP12, TP13, TP14: TestPoint; Test_Pad; LCSC DNP
U1: OPA810IDBVT; TSOT-23-5; LCSC C4154868
U2: D050505T-1WR4; LCSC C2692185
U3, U6: LTC1966; MSOP-8_3x3mm_P0.65mm; LCSC C462623
U5: TPS72325DBVR; SOT-23-5; LCSC C69932
U8: ADS1115IDGS; VSSOP-10_3x3mm_P0.5mm; LCSC C37593
U9: ISO1541; SOIC-8_3.9x4.9mm_P1.27mm; JLCRotOffset 270
U11, U12: ESD5344D-TP; Diodes_UDFN-10_1.0x2.5mm_P0.5mm; LCSC C2841840
U13: XC6206P332MR; SOT-23-3; LCSC C5446
U15: TPS7A2025PDBVR; SOT-23-5; LCSC C2869949

Connections:
+2V5F: C1.1, C3.1, C4.1, C13.2, C18.1, R8.1, R20.2, R21.2, R22.2, TP14.1, U1.5 (V+), U3.7 (V+), U6.7 (V+), U8.8 (VDD), U9.8 (VCC2)
+3V3: C19.2, C21.2, C23.2, R23.2, R24.2, R25.1, TP12.1, U9.1 (VCC1), U13.2 (VOUT)
+5V: C20.2, C22.2, C24.2, C25.2, J3.B1 (Pin_b1), J3.B2 (Pin_b2), J3.B3 (Pin_b3), J3.B4 (Pin_b4), TP5.1, U2.20 (VIN), U12.1 (D1), U12.2 (D2), U13.3 (VIN)
+5VF: C28.2, C29.2, R7.1, R13.2, TP11.1, U15.1 (IN), U15.3 (EN)
-2V5F: C7.1, C8.1, C9.1, C35.1, C37.2, R11.1, R19.2, TP10.1, U1.2 (V-), U3.1 (GND), U3.4 (VSS), U3.8 (~EN), U6.1 (GND), U6.4 (VSS), U6.8 (~EN), U8.3 (GND), U9.5 (GND2)
-5VF: C11.2, C12.2, R5.1, R14.2, TP9.1, U5.2 (IN), U5.3 (EN)
/-I_SENSE: D4.2 (A), D5.1 (K), J1.1, R2.1, R6.1, TP3.1
/ADC0: C5.2, TP6.1, U3.5 (OUT), U8.4 (AIN0)
/ADC1: C6.2, TP7.1, U6.5 (OUT), U8.5 (AIN1)
/PB7: J3.B10 (Pin_b10), R23.1, U9.2 (SDA1), U11.1 (D1)
/PB8: J3.B12 (Pin_b12), R24.1, U9.3 (SCL1), U11.5 (D4)
/VIN: J1.2, J2.2, R3.2, R12.1
/V_SENSE: R3.1, R4.1, TP2.1, U3.2 (IN1)
GND: C19.1, C20.1, C21.1, C22.1, C23.1, C24.1, C25.1, D3.1 (K), J3.A1 (Pin_a1), J3.A2 (Pin_a2), J3.A3 (Pin_a3), J3.A4 (Pin_a4), TP13.1, U2.1 (GND), U2.2 (GND), U9.4 (GND1), U11.3 (GND), U12.3 (GND), U13.1 (GND)
GNDF: C1.2, C2.2, C3.2, C4.2, C5.1, C6.1, C7.2, C8.2, C9.2, C10.2, C11.1, C12.1, C13.1, C14.1, C15.1, C16.1, C17.1, C18.2, C26.1, C27.1, C28.1, C29.1, C35.2, C36.1, C37.1, D1.2 (A), D2.1 (K), J2.1, R2.2, R4.2, R10.1, TP1.1, U2.10 (VO1), U2.12 (0V2), U3.3 (IN2), U3.6 (RTRN), U5.1 (GND), U6.3 (IN2), U6.6 (RTRN), U8.7 (AIN3), U15.2 (GND)
unnamed: D1.1 (K), R5.2
unnamed: D2.2 (A), R7.2
unnamed: D3.2 (A), R25.2
unnamed: D4.1 (K), D5.2 (A), R12.2
unnamed: R6.2, U1.3 (+)
unnamed: R9.2, R10.2, U1.4 (-)
unnamed: C2.1, C10.1, R14.1, U2.9 (0V1)
unnamed: C16.2, C17.2, R13.1, U2.11 (VO2)
unnamed: C36.2, U5.4 (NR)
unnamed: C14.2, C15.2, R11.2, U5.5 (OUT)
unnamed: R9.1, TP4.1, U1.1, U6.2 (IN1)
unnamed: R18.1, R19.1, R20.1, U8.1 (ADDR)
unnamed: R18.2, R22.1, U8.10 (SCL), U9.6 (SCL2)
unnamed: R21.1, U8.9 (SDA), U9.7 (SDA2)
unnamed: C26.2, C27.2, R8.2, U15.5 (OUT)

Notes on the sheet:
PW2
FLOATING GROUND
SENSING NETWORK
OUT TO RESISTIVE LOAD
BUS
TODO: Green LEDs are too bright.
I2C ADDRESS
PWM IN 28V 4A MAX 1KHz-10KHz
NEGATIVE
PW1
-2.5V LDO
AMPLIFIER X11
BLU
POSITIVE
I2C1
+2.5V LDO
PW3
PWM POWER METER V0.2
VIN AND POLARITY INDICATOR
NOTES: * LCSC part number are of approximated values to maximize usage of JLCPCB 'basic' parts. * Accuracy can be improved by suing low ppm resistors where applicable and a film capacitor for the RMS converter integrator. * JLCPCB fabrication files should be generated using the Kicad's Fabrication 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
I2C ADC
SUBSTITUTE ISO1641BDR
VOLTAGE RMS/DC
TODO: +/- 5V LEDs locations are swapped on the PCB.
ISOLATED 5VDC TO +/-5VDC
BUS GROUND
CURRENT RMS/DC

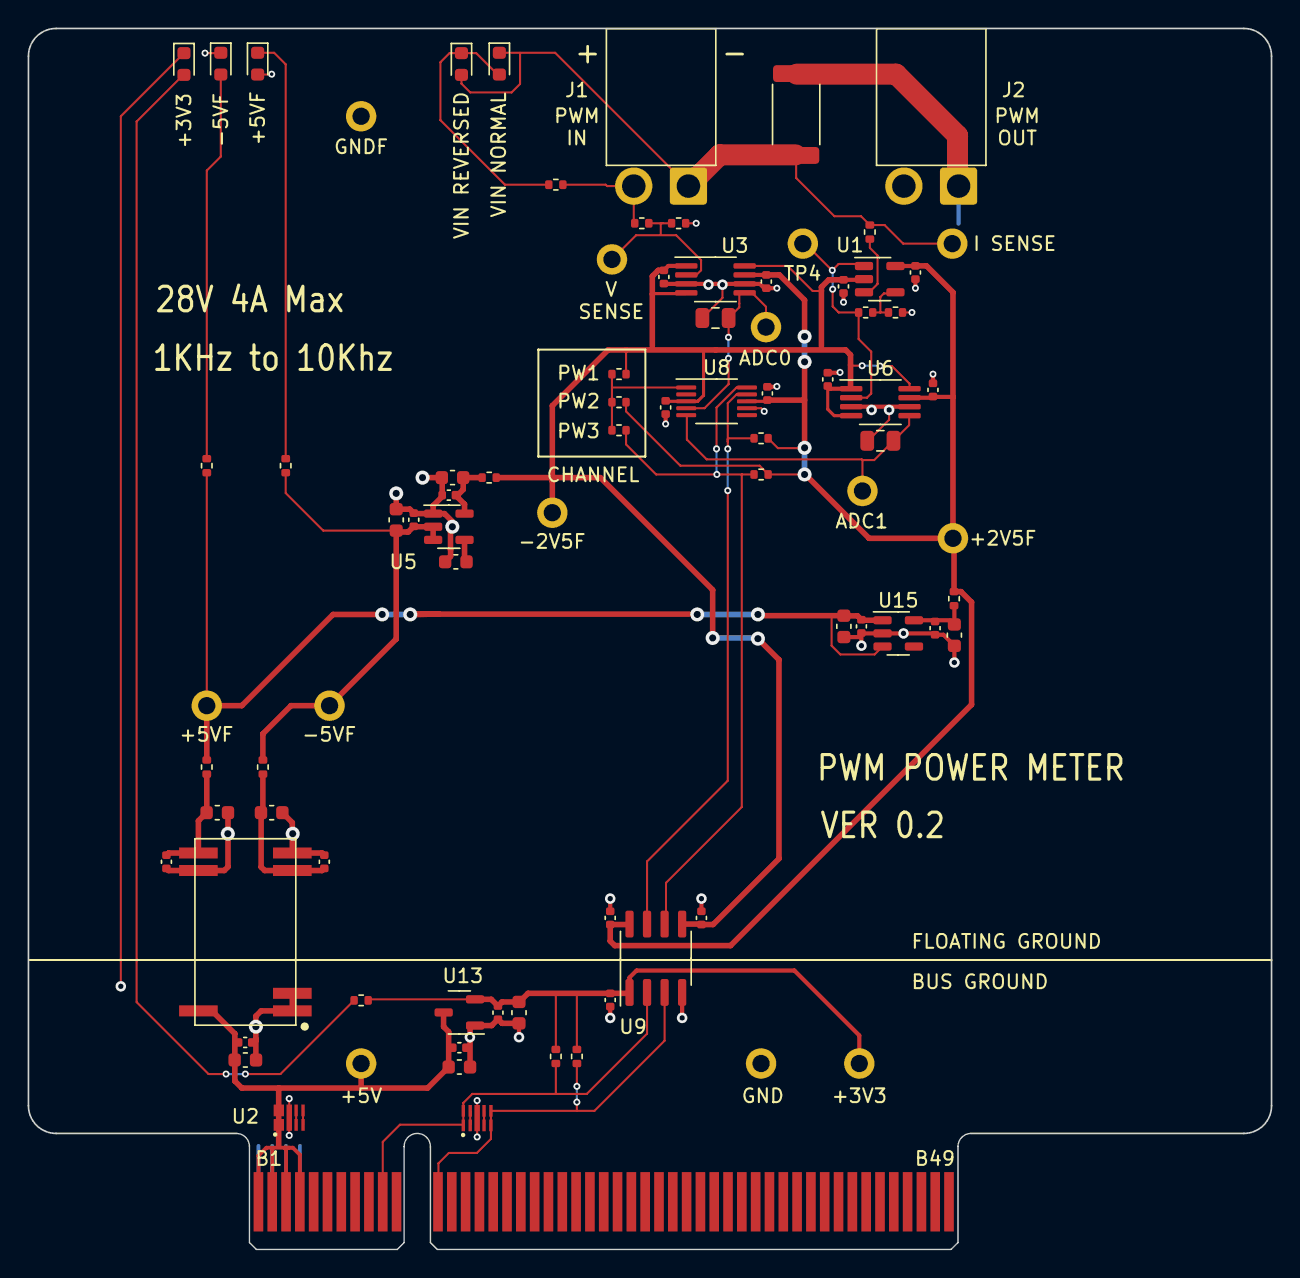
[picture p30: board heater.kicad_pcb from above]

Board: 2 copper layers, 90.0 x 88.4 mm, 85 parts (0 on the bottom side), 30 nets.
