zapta/daq/heater/kicad/io.kicad_pcb

## KiCad design heater/kicad/io.kicad_pcb (2023-07-28)

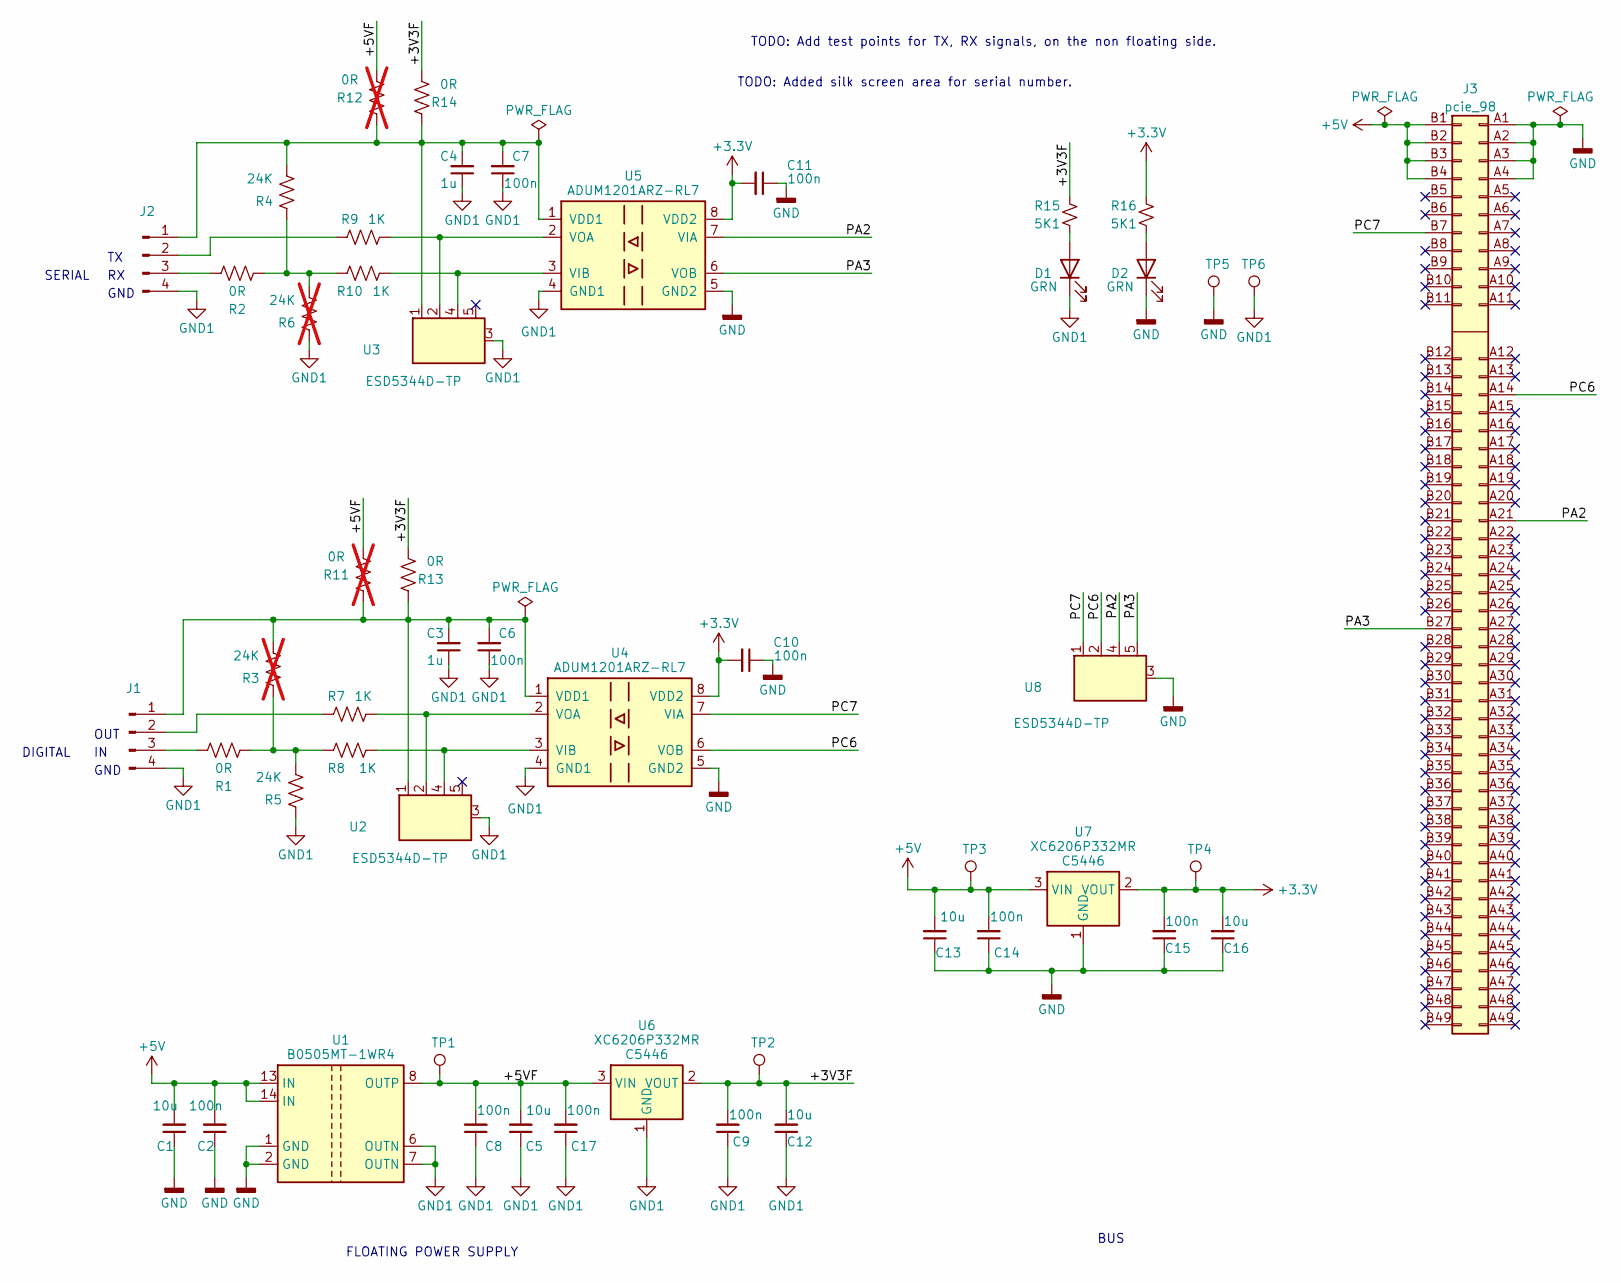
[picture p31: schematic io.kicad_sch, IO BOARD]

Parts:
C1, C5, C12, C13, C16: 10u; C_0603_1608Metric_Pad1.08x0.95mm_HandSolder; LCSC C96446
C2, C6, C7, C8, C9, C10, C11, C14, C15, C17: 100n; C_0603_1608Metric_Pad1.08x0.95mm_HandSolder; LCSC C14663
C3, C4: 1u; C_0603_1608Metric_Pad1.08x0.95mm_HandSolder; LCSC C15849
D1, D2: GRN; LED_0603_1608Metric; LCSC C72043
J1, J2: Conn_01x04_Pin; connector_4pins_horizontal; LCSC C31753
J3: pcie_98; PCIE_98_CARD; LCSC DNP
R1, R2, R13, R14: 0R; R_0603_1608Metric_Pad0.98x0.95mm_HandSolder; LCSC C21189
R3, R6: 24K; R_0603_1608Metric_Pad0.98x0.95mm_HandSolder; LCSC C23352; not fitted
R4, R5: 24K; R_0603_1608Metric_Pad0.98x0.95mm_HandSolder; LCSC C23352
R7, R8, R9, R10: 1K; R_0603_1608Metric_Pad0.98x0.95mm_HandSolder; LCSC C21190
R11, R12: 0R; R_0603_1608Metric_Pad0.98x0.95mm_HandSolder; LCSC C21189; not fitted
R15, R16: 5K1; R_0603_1608Metric_Pad0.98x0.95mm_HandSolder; LCSC C23186
TP1, TP2, TP3, TP4, TP5, TP6: TestPoint; Test_Pad; LCSC DNP
U1: B0505MT-1WR4; Converter_DCDC; LCSC C919693
U2, U3, U8: ESD5344D-TP; Diodes_UDFN-10_1.0x2.5mm_P0.5mm; LCSC C2841840
U4, U5: ADUM1201ARZ-RL7; SOIC-8_3.9x4.9mm_P1.27mm; LCSC C9669
U6, U7: XC6206P332MR; SOT-23-3; LCSC C5446

Connections:
+3.3V: C10.2, C11.2, C15.2, C16.2, R16.1, TP4.1, U4.8 (VDD2), U5.8 (VDD2), U7.2 (VOUT)
+5V: C1.2, C2.2, C13.2, C14.2, J3.B1 (Pin_b1), J3.B2 (Pin_b2), J3.B3 (Pin_b3), J3.B4 (Pin_b4), TP3.1, U1.13 (IN), U1.14 (IN), U7.3 (VIN)
/+3V3F: C9.2, C12.2, R13.2, R14.2, R15.1, TP2.1, U6.2 (VOUT)
/+5VF: C5.2, C8.2, C17.2, R11.2, R12.2, TP1.1, U1.8 (OUTP), U6.3 (VIN)
/PA2: J3.A21 (Pin_a21), U5.7 (VIA), U8.4 (D3)
/PA3: J3.B27 (Pin_b27), U5.6 (VOB), U8.5 (D4)
/PC6: J3.A14 (Pin_a14), U4.6 (VOB), U8.2 (D2)
/PC7: J3.B7 (Pin_b7), U4.7 (VIA), U8.1 (D1)
GND: C1.1, C2.1, C10.1, C11.1, C13.1, C14.1, C15.1, C16.1, D2.1 (K), J3.A1 (Pin_a1), J3.A2 (Pin_a2), J3.A3 (Pin_a3), J3.A4 (Pin_a4), TP5.1, U1.1 (GND), U1.2 (GND), U4.5 (GND2), U5.5 (GND2), U7.1 (GND), U8.3 (GND)
GND1: C3.1, C4.1, C5.1, C6.1, C7.1, C8.1, C9.1, C12.1, C17.1, D1.1 (K), J1.4, J2.4, R5.1, R6.1, TP6.1, U1.6 (OUTN), U1.7 (OUTN), U2.3 (GND), U3.3 (GND), U4.4 (GND1), U5.4 (GND1), U6.1 (GND)
unnamed: D1.2 (A), R15.2
unnamed: D2.2 (A), R16.2
unnamed: C3.2, C6.2, J1.1, R3.2, R11.1, R13.1, U2.1 (D1), U4.1 (VDD1)
unnamed: J1.2, R7.1
unnamed: J1.3, R1.2
unnamed: C4.2, C7.2, J2.1, R4.2, R12.1, R14.1, U3.1 (D1), U5.1 (VDD1)
unnamed: J2.2, R9.1
unnamed: J2.3, R2.2
unnamed: R1.1, R3.1, R5.2, R8.1
unnamed: R2.1, R4.1, R6.2, R10.1
unnamed: R7.2, U2.2 (D2), U4.2 (VOA)
unnamed: R8.2, U2.4 (D3), U4.3 (VIB)
unnamed: R9.2, U3.2 (D2), U5.2 (VOA)
unnamed: R10.2, U3.4 (D3), U5.3 (VIB)

Notes on the sheet:
OUT
BUS
FLOATING POWER SUPPLY
TODO: Added silk screen area for serial number.
DIGITAL
TODO: Add test points for TX, RX signals, on the non floating side.
GND
SERIAL

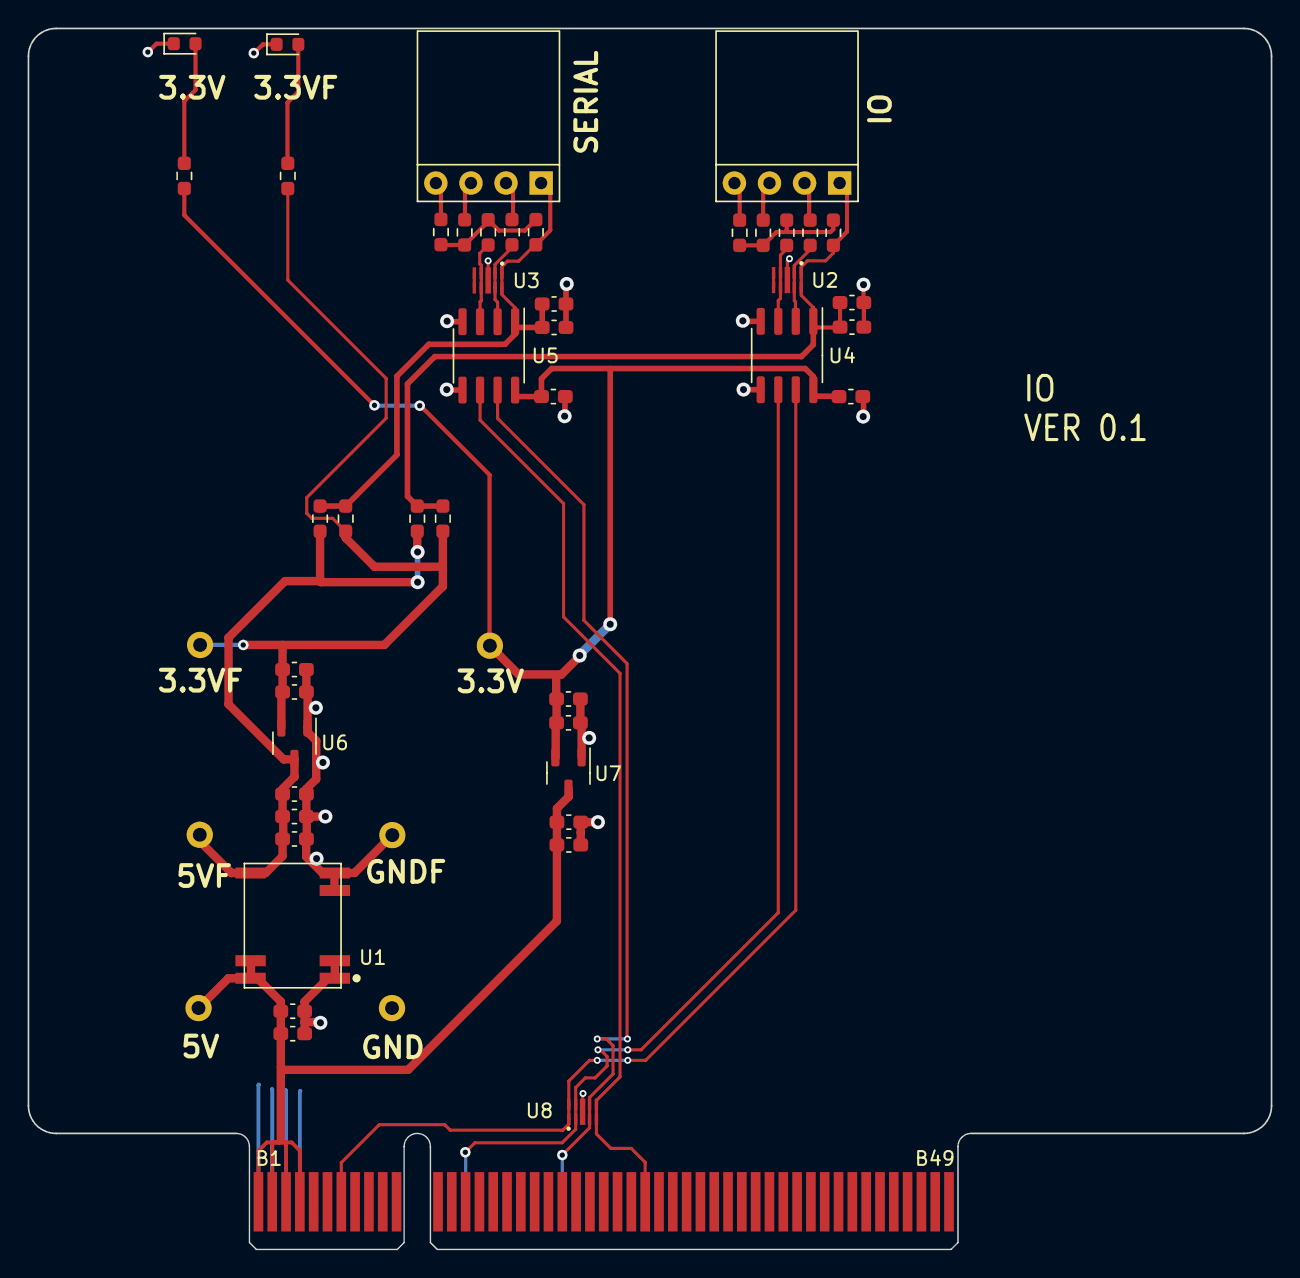
[picture p32: board io.kicad_pcb from above]

Board: 2 copper layers, 90.0 x 88.4 mm, 52 parts (0 on the bottom side), 24 nets.
