zapta/daq/adc/kicad/adc.kicad_pcb

## KiCad design adc/kicad/adc.kicad_pcb (2023-07-28)

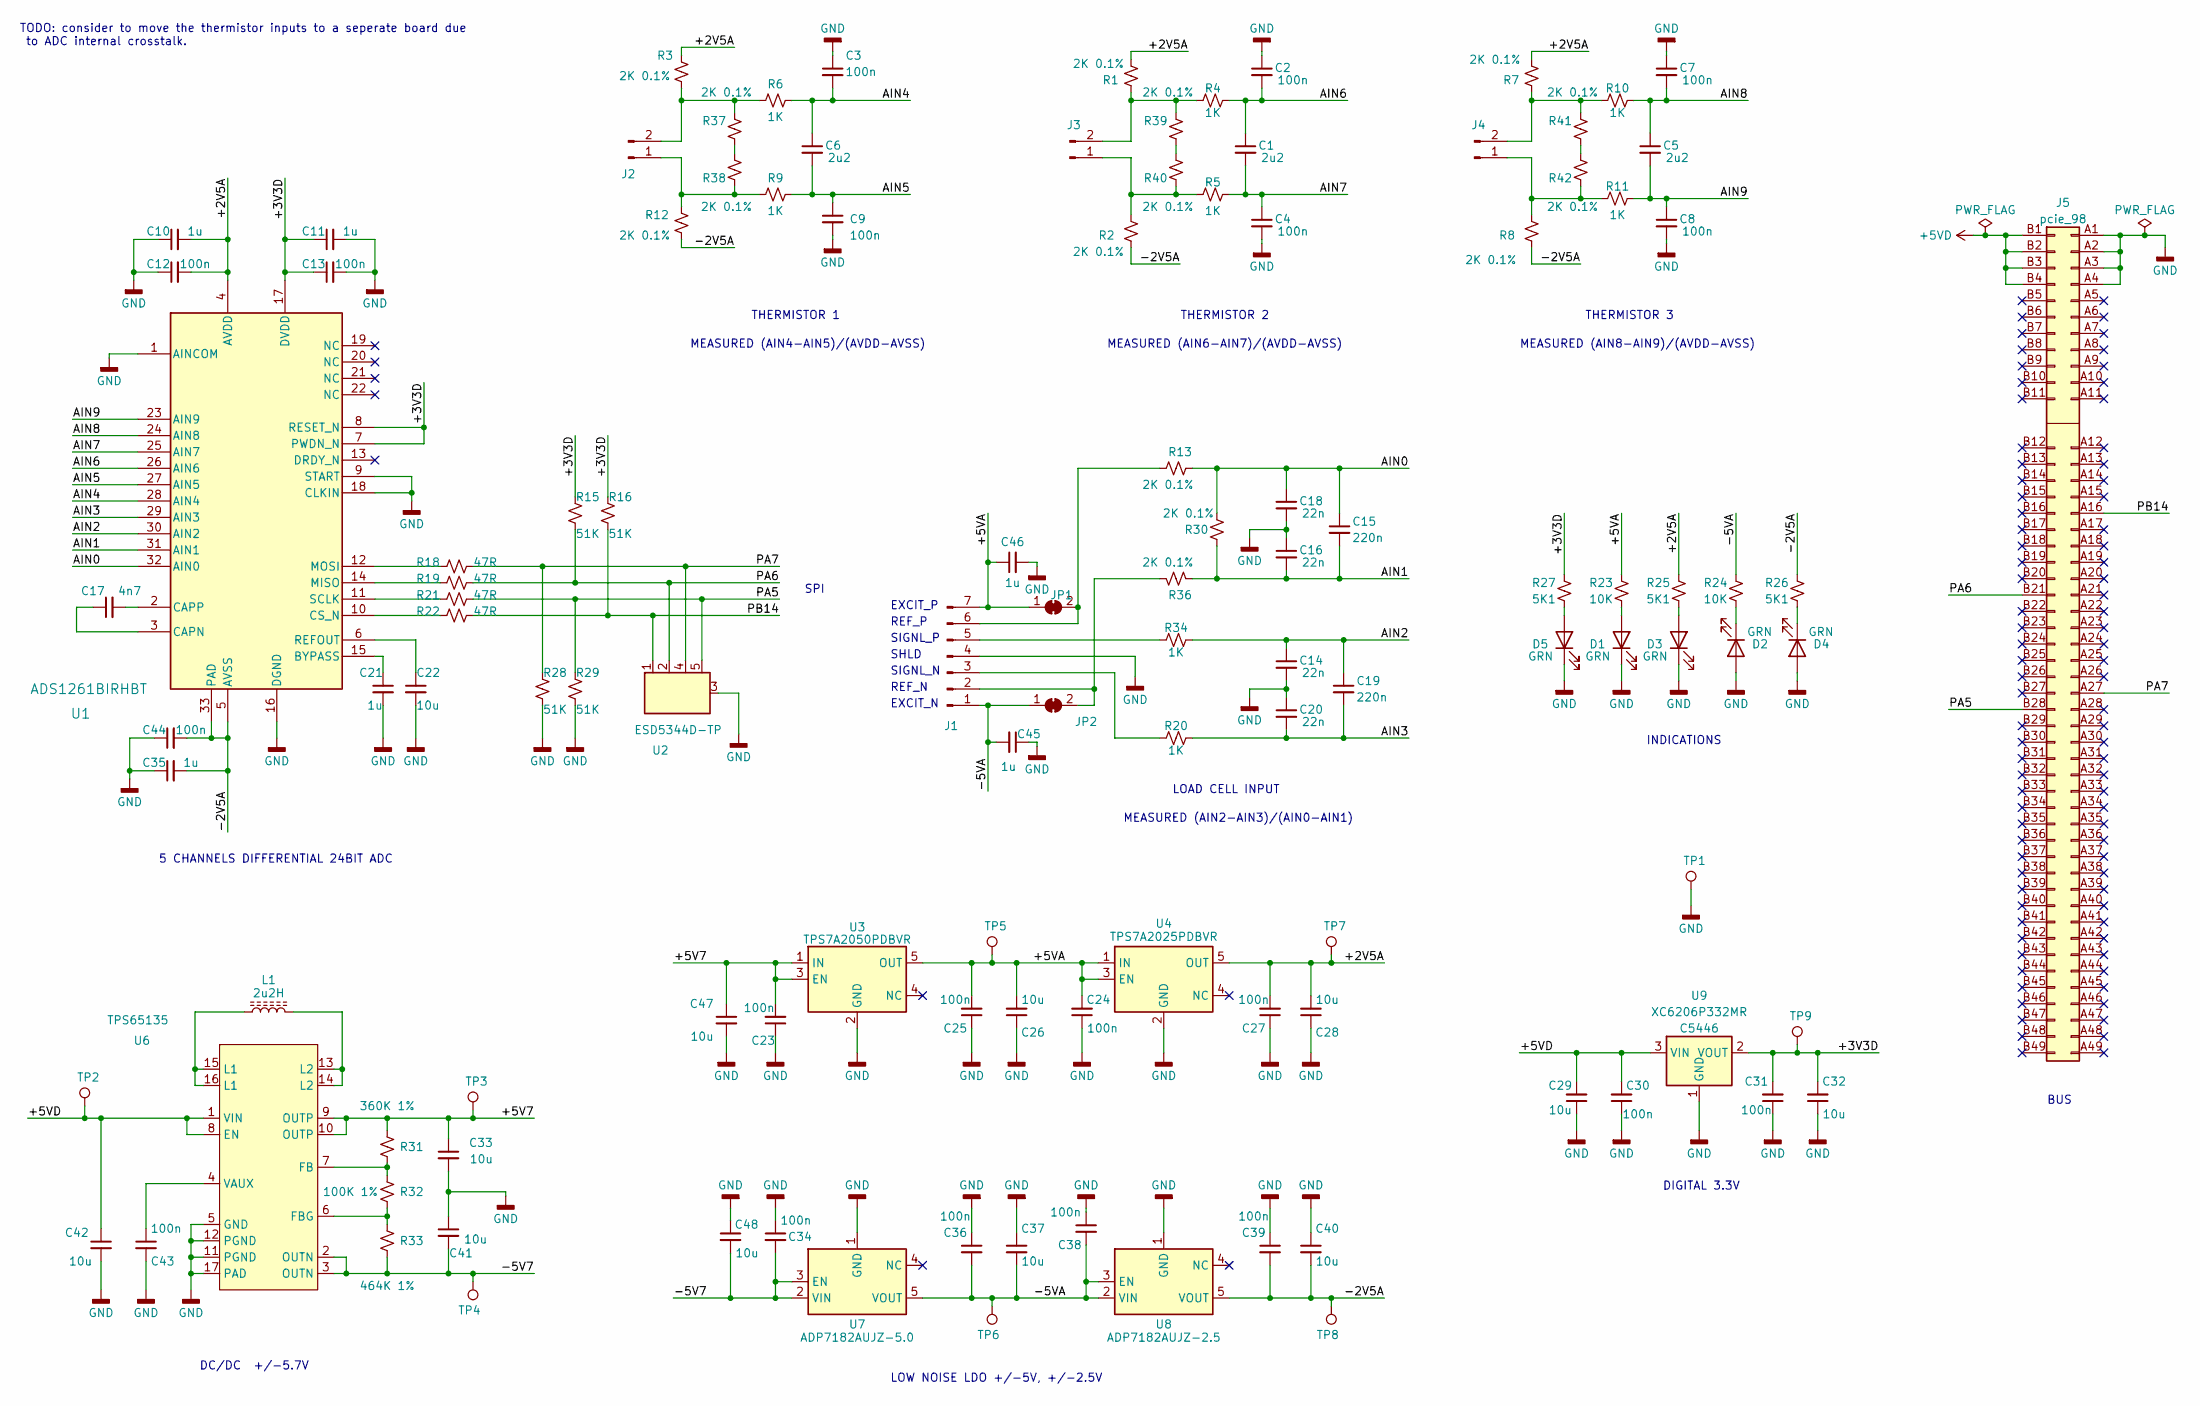
[picture p33: schematic adc.kicad_sch, ADS1261B ADC BOARD]

Parts:
C1, C5, C6: 2u2; C_0402_1005Metric; LCSC C12530
C2, C3, C4, C7, C8, C9, C12, C13, C23, C24, C25, C27, C30, C31, C34, C36, C38, C39, C43, C44: 100n; C_0402_1005Metric; LCSC C1525
C10, C11, C21, C35, C45, C46: 1u; C_0402_1005Metric; LCSC C52923
C14, C16, C18, C20: 22n; C_0402_1005Metric; LCSC C1532
C15, C19: 220n; C_0402_1005Metric; LCSC C16772
C17: 4n7; C_0402_1005Metric; LCSC C1538
C22, C26, C28, C29, C32, C33, C37, C40, C41, C42, C47, C48: 10u; C_0603_1608Metric; LCSC C19702
D1, D2, D3, D4, D5: GRN; LED_0603_1608Metric; LCSC C72043
J1: Conn_01x07_Pin; connector_7pins_horizontal; LCSC C70896
J2, J3, J4: Conn_01x02_Pin; connector_2pins_horizontal; LCSC C30436
J5: pcie_98; PCIE_98_CARD; LCSC DNP
JP1, JP2: SolderJumper_2_Bridged; SolderJumper-2_P1.3mm_Bridged_Pad1.0x1.5mm; LCSC DNP
L1: 2u2H; Inductor_C329578; LCSC C329578
R1, R2, R3, R7, R8, R12, R13, R30, R36, R37, R38, R39, R40, R41, R42: 2K 0.1%; R_0402_1005Metric; LCSC C852711
R4, R5, R6, R9, R10, R11, R20, R34: 1K; R_0402_1005Metric; LCSC C11702
R15, R16, R28, R29: 51K; R_0402_1005Metric; LCSC C25794
R18, R19, R21, R22: 47R; R_0402_1005Metric; LCSC C25118
R23, R24: 10K; R_0402_1005Metric; LCSC C25744
R25, R26, R27: 5K1; R_0402_1005Metric; LCSC C25905
R31: 360K 1%; R_0402_1005Metric; LCSC C308007
R32: 100K 1%; R_0402_1005Metric; LCSC C25741
R33: 464K 1%; R_0402_1005Metric; LCSC C477740
TP1, TP2, TP3, TP4, TP5, TP6, TP7, TP8, TP9: TestPoint; Test_Pad
U1: ADS1261BIRHBT; RHB0032E; LCSC C2669964
U2: ESD5344D-TP; Diodes_UDFN-10_1.0x2.5mm_P0.5mm; LCSC C2841840
U3: TPS7A2050PDBVR; SOT-23-5; LCSC C2864504
U4: TPS7A2025PDBVR; SOT-23-5; LCSC C2869949
U6: TPS65135; WQFN-16-1EP_3x3mm_P0.5mm_EP1.68x1.68mm_ThermalVias; LCSC C57950
U7: ADP7182AUJZ-5.0; TSOT-23-5; LCSC C514357
U8: ADP7182AUJZ-2.5; TSOT-23-5; LCSC C462196
U9: XC6206P332MR; SOT-23-3; LCSC C5446

Connections:
+5VD: C29.2, C30.2, C42.1, J5.B1 (Pin_b1), J5.B2 (Pin_b2), J5.B3 (Pin_b3), J5.B4 (Pin_b4), TP2.1, U6.1 (VIN), U6.8 (EN), U9.3 (VIN)
/+2V5A: C10.2, C12.2, C27.2, C28.2, R1.2, R3.2, R7.2, R25.1, TP7.1, U1.4 (AVDD), U4.5 (OUT)
/+3V3D: C11.1, C13.1, C31.2, C32.2, R15.2, R16.2, R27.1, TP9.1, U1.7 (PWDN_N), U1.8 (RESET_N), U1.17 (DVDD), U9.2 (VOUT)
/+5V7: C23.2, C33.1, C47.1, R31.1, TP3.1, U3.1 (IN), U3.3 (EN), U6.9 (OUTP), U6.10 (OUTP)
/+5VA: C24.2, C25.2, C26.2, C46.1, J1.7, JP1.1 (A), R23.1, TP5.1, U3.5 (OUT), U4.1 (IN), U4.3 (EN)
/-2V5A: C35.2, C39.2, C40.2, C44.2, R2.1, R8.1, R12.1, R26.1, TP8.1, U1.5 (AVSS), U1.33 (PAD), U8.5 (VOUT)
/-5V7: C34.2, C41.2, C48.2, R33.2, TP4.1, U6.2 (OUTN), U6.3 (OUTN), U7.2 (VIN), U7.3 (EN)
/-5VA: C36.2, C37.2, C38.2, C45.2, J1.1, JP2.1 (A), R24.1, TP6.1, U7.5 (VOUT), U8.2 (VIN), U8.3 (EN)
/AIN0: C15.1, C18.1, R13.1, R30.2, U1.32 (AIN0)
/AIN1: C15.2, C16.2, R30.1, R36.1, U1.31 (AIN1)
/AIN2: C14.1, C19.1, R34.2, U1.30 (AIN2)
/AIN3: C19.2, C20.2, R20.2, U1.29 (AIN3)
/AIN4: C3.2, C6.1, R6.2, U1.28 (AIN4)
/AIN5: C6.2, C9.1, R9.2, U1.27 (AIN5)
/AIN6: C1.1, C2.2, R4.2, U1.26 (AIN6)
/AIN7: C1.2, C4.1, R5.2, U1.25 (AIN7)
/AIN8: C5.1, C7.2, R10.2, U1.24 (AIN8)
/AIN9: C5.2, C8.1, R11.2, U1.23 (AIN9)
/PA5: J5.B28 (Pin_b28), R21.1, R29.2, U2.5 (D4)
/PA6: J5.B21 (Pin_b21), R15.1, R19.1, U2.2 (D2)
/PA7: J5.A27 (Pin_a27), R18.1, R28.2, U2.4 (D3)
/PB14: J5.A16 (Pin_a16), R16.1, R22.1, U2.1 (D1)
GND: C2.1, C3.1, C4.2, C7.1, C8.2, C9.2, C10.1, C11.2, C12.1, C13.2, C14.2, C16.1, C18.2, C20.1, C21.2, C22.2, C23.1, C24.1, C25.1, C26.1, C27.1, C28.1, C29.1, C30.1, C31.1, C32.1, C33.2, C34.1, C35.1, C36.1, C37.1, C38.1, C39.1, C40.1, C41.1, C42.2, C43.2, C44.1, C45.1, C46.2, C47.2, C48.1, D1.1 (K), D2.2 (A), D3.1 (K), D4.2 (A), D5.1 (K), J1.4, J5.A1 (Pin_a1), J5.A2 (Pin_a2), J5.A3 (Pin_a3), J5.A4 (Pin_a4), R28.1, R29.1, TP1.1, U1.1 (AINCOM), U1.9 (START), U1.16 (DGND), U1.18 (CLKIN), U2.3 (GND), U3.2 (GND), U4.2 (GND), U6.5 (GND), U6.11 (PGND), U6.12 (PGND), U6.17 (PAD), U7.1 (GND), U8.1 (GND), U9.1 (GND)
unnamed: D1.2 (A), R23.2
unnamed: D2.1 (K), R24.2
unnamed: D3.2 (A), R25.2
unnamed: D4.1 (K), R26.2
unnamed: D5.2 (A), R27.2
unnamed: J1.2, JP2.2 (B), R36.2
unnamed: J1.3, R20.1
unnamed: J1.5, R34.1
unnamed: J1.6, JP1.2 (B), R13.2
unnamed: J2.1, R9.1, R12.2, R38.1
unnamed: J2.2, R3.1, R6.1, R37.2
unnamed: J3.1, R2.2, R5.1, R40.1
unnamed: J3.2, R1.1, R4.1, R39.2
unnamed: J4.1, R8.2, R11.1, R42.1
unnamed: J4.2, R7.1, R10.1, R41.2
unnamed: L1.1, U6.15 (L1), U6.16 (L1)
unnamed: L1.2, U6.13 (L2), U6.14 (L2)
unnamed: R37.1, R38.2
unnamed: R39.1, R40.2
unnamed: R41.1, R42.2
unnamed: C21.1, U1.15 (BYPASS)
unnamed: C17.1, U1.3 (CAPN)
unnamed: C17.2, U1.2 (CAPP)
unnamed: R22.2, U1.10 (CS_N)
unnamed: R19.2, U1.14 (MISO)
unnamed: R18.2, U1.12 (MOSI)
unnamed: C22.1, U1.6 (REFOUT)
unnamed: R21.2, U1.11 (SCLK)
unnamed: R31.2, R32.1, U6.7 (FB)
unnamed: R32.2, R33.1, U6.6 (FBG)
unnamed: C43.1, U6.4 (VAUX)

Notes on the sheet:
TODO: consider to move the thermistor inputs to a seperate board due to ADC internal crosstalk.
SIGNL_N
REF_N
BUS
THERMISTOR 3
SHLD
EXCIT_N
MEASURED (AIN4-AIN5)/(AVDD-AVSS)
SPI
MEASURED (AIN2-AIN3)/(AIN0-AIN1)
INDICATIONS
THERMISTOR 1
MEASURED (AIN6-AIN7)/(AVDD-AVSS)
THERMISTOR 2
MEASURED (AIN8-AIN9)/(AVDD-AVSS)
5 CHANNELS DIFFERENTIAL 24BIT ADC
SIGNL_P
DIGITAL 3.3V
LOAD CELL INPUT
REF_P
EXCIT_P
DC/DC +/-5.7V
LOW NOISE LDO +/-5V, +/-2.5V

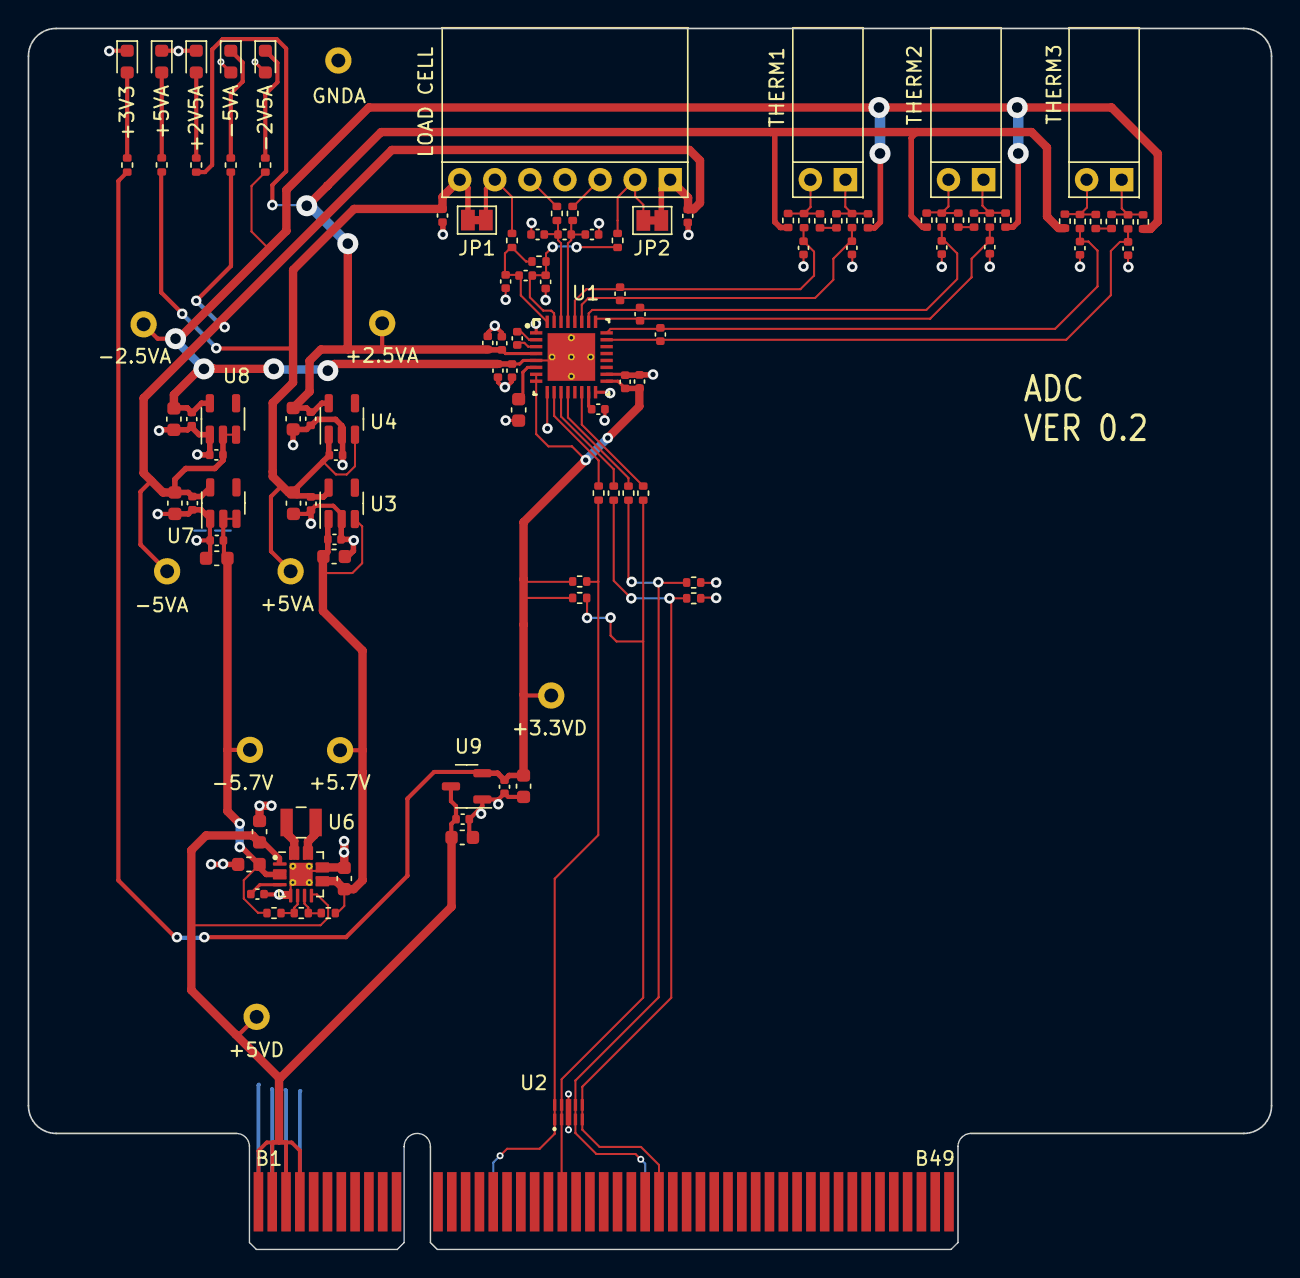
[picture p34: board adc.kicad_pcb from above]

Board: 2 copper layers, 90.0 x 88.4 mm, 117 parts (0 on the bottom side), 54 nets.
