zapta/daq/controller/kicad/controller.kicad_pcb

## KiCad design controller/kicad/controller.kicad_pcb (2023-07-26)

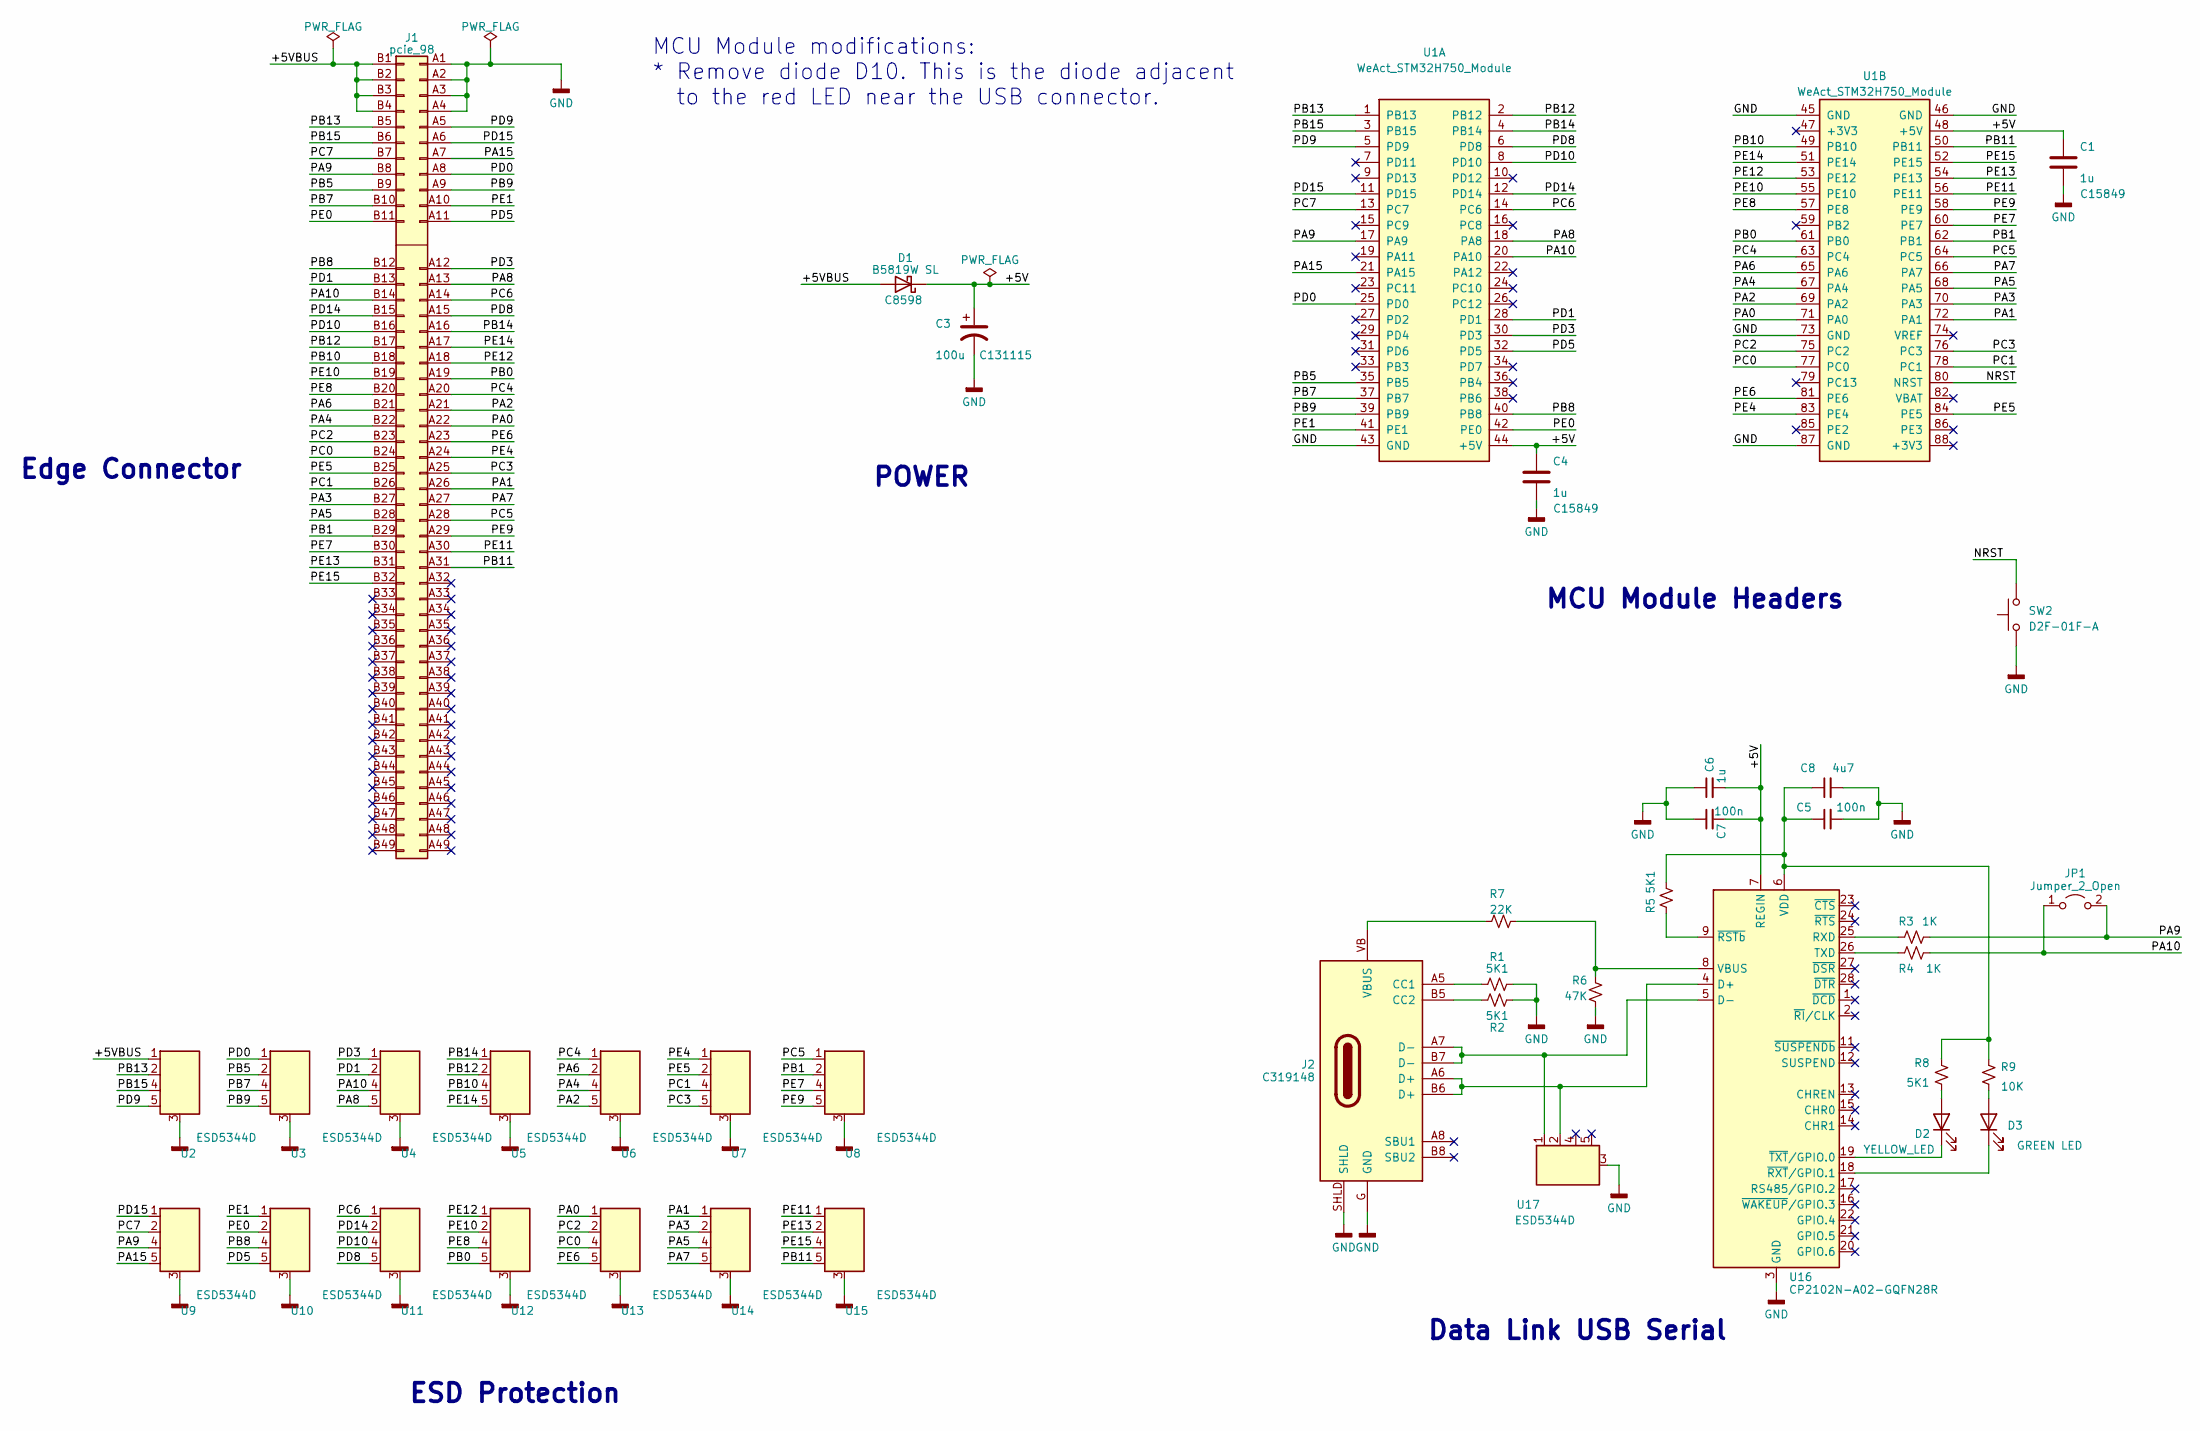
[picture p35: schematic controller.kicad_sch]

Parts:
C1, C4, C6: 1u; C_0603_1608Metric; LCSC C15849
C3: 100u; CP_Elec_5x5.4_JLCPCB; LCSC C131115
C5, C7: 100n; C_0603_1608Metric; LCSC C14663
C8: 4u7; C_0603_1608Metric; LCSC C19666
D1: B5819W SL; D_SOD-123; LCSC C8598
D2: YELLOW_LED; LED_0603_1608Metric; LCSC C72038
D3: GREEN LED; LED_0603_1608Metric; LCSC C72043
J1: pcie_98; PCIE_98_CARD; LCSC DNP
J2: USB_C_Receptacle_USB2.0; USB_C_Receptacle_XKB_U262-16XN-4BVC11; LCSC C319148
JP1: Jumper_2_Open; PinHeader_1x02_P2.54mm_Vertical; LCSC DNP
R1, R2, R5, R8: 5K1; R_0603_1608Metric; LCSC C23186
R3, R4: 1K; R_0603_1608Metric; LCSC C21190
R6: 47K; R_0603_1608Metric; LCSC C25819
R7: 22K; R_0603_1608Metric; LCSC C31850
R9: 10K; R_0603_1608Metric; LCSC C25804
SW2: D2F-01F-A; microswitch; LCSC C726013
U1: WeAct_STM32H750_Module; weact_stm32fh750; LCSC DNP
U2, U3, U4, U5, U6, U7, U8, U9, U10, U11, U12, U13, U14, U15, U17: ESD5344D; Diodes_UDFN-10_1.0x2.5mm_P0.5mm; LCSC C2841840
U16: CP2102N-A02-GQFN28R; QFN-28-1EP_5x5mm_P0.5mm_EP3.35x3.35mm; LCSC C964632

Connections:
/+5V: C1.1, C3.1, C4.1, C6.2, C7.2, D1.1 (K), U1.44 (+5V), U1.48 (+5V), U16.7 (REGIN)
/+5VBUS: D1.2 (A), J1.B1 (Pin_b1), J1.B2 (Pin_b2), J1.B3 (Pin_b3), J1.B4 (Pin_b4), U2.1 (D1)
/NRST: SW2.2, U1.80 (NRST)
/PA0: J1.A22 (Pin_a22), U1.71 (PA0), U13.1 (D1)
/PA1: J1.A26 (Pin_a26), U1.72 (PA1), U14.1 (D1)
/PA2: J1.A21 (Pin_a21), U1.69 (PA2), U6.5 (D4)
/PA3: J1.B27 (Pin_b27), U1.70 (PA3), U14.2 (D2)
/PA4: J1.B22 (Pin_b22), U1.67 (PA4), U6.4 (D3)
/PA5: J1.B28 (Pin_b28), U1.68 (PA5), U14.4 (D3)
/PA6: J1.B21 (Pin_b21), U1.65 (PA6), U6.2 (D2)
/PA7: J1.A27 (Pin_a27), U1.66 (PA7), U14.5 (D4)
/PA8: J1.A13 (Pin_a13), U1.18 (PA8), U4.5 (D4)
/PA9: J1.B8 (Pin_b8), JP1.2 (B), R3.2, U1.17 (PA9), U9.4 (D3)
/PA10: J1.B14 (Pin_b14), JP1.1 (A), R4.2, U1.20 (PA10), U4.4 (D3)
/PA15: J1.A7 (Pin_a7), U1.21 (PA15), U9.5 (D4)
/PB0: J1.A19 (Pin_a19), U1.61 (PB0), U12.5 (D4)
/PB1: J1.B29 (Pin_b29), U1.62 (PB1), U8.2 (D2)
/PB5: J1.B9 (Pin_b9), U1.35 (PB5), U3.2 (D2)
/PB7: J1.B10 (Pin_b10), U1.37 (PB7), U3.4 (D3)
/PB8: J1.B12 (Pin_b12), U1.40 (PB8), U10.4 (D3)
/PB9: J1.A9 (Pin_a9), U1.39 (PB9), U3.5 (D4)
/PB10: J1.B18 (Pin_b18), U1.49 (PB10), U5.4 (D3)
/PB11: J1.A31 (Pin_a31), U1.50 (PB11), U15.5 (D4)
/PB12: J1.B17 (Pin_b17), U1.2 (PB12), U5.2 (D2)
/PB13: J1.B5 (Pin_b5), U1.1 (PB13), U2.2 (D2)
/PB14: J1.A16 (Pin_a16), U1.4 (PB14), U5.1 (D1)
/PB15: J1.B6 (Pin_b6), U1.3 (PB15), U2.4 (D3)
/PC0: J1.B24 (Pin_b24), U1.77 (PC0), U13.4 (D3)
/PC1: J1.B26 (Pin_b26), U1.78 (PC1), U7.4 (D3)
/PC2: J1.B23 (Pin_b23), U1.75 (PC2), U13.2 (D2)
/PC3: J1.A25 (Pin_a25), U1.76 (PC3), U7.5 (D4)
/PC4: J1.A20 (Pin_a20), U1.63 (PC4), U6.1 (D1)
/PC5: J1.A28 (Pin_a28), U1.64 (PC5), U8.1 (D1)
/PC6: J1.A14 (Pin_a14), U1.14 (PC6), U11.1 (D1)
/PC7: J1.B7 (Pin_b7), U1.13 (PC7), U9.2 (D2)
/PD0: J1.A8 (Pin_a8), U1.25 (PD0), U3.1 (D1)
/PD1: J1.B13 (Pin_b13), U1.28 (PD1), U4.2 (D2)
/PD3: J1.A12 (Pin_a12), U1.30 (PD3), U4.1 (D1)
/PD5: J1.A11, U1.32 (PD5), U10.5 (D4)
/PD8: J1.A15 (Pin_a15), U1.6 (PD8), U11.5 (D4)
/PD9: J1.A5 (Pin_a5), U1.5 (PD9), U2.5 (D4)
/PD10: J1.B16 (Pin_b16), U1.8 (PD10), U11.4 (D3)
/PD14: J1.B15 (Pin_b15), U1.12 (PD14), U11.2 (D2)
/PD15: J1.A6 (Pin_a6), U1.11 (PD15), U9.1 (D1)
/PE0: J1.B11 (Pin_b11), U1.42 (PE0), U10.2 (D2)
/PE1: J1.A10 (Pin_a10), U1.41 (PE1), U10.1 (D1)
/PE4: J1.A24 (Pin_a24), U1.83 (PE4), U7.1 (D1)
/PE5: J1.B25 (Pin_b25), U1.84 (PE5), U7.2 (D2)
/PE6: J1.A23 (Pin_a23), U1.81 (PE6), U13.5 (D4)
/PE7: J1.B30 (Pin_b30), U1.60 (PE7), U8.4 (D3)
/PE8: J1.B20 (Pin_b20), U1.57 (PE8), U12.4 (D3)
/PE9: J1.A29 (Pin_a29), U1.58 (PE9), U8.5 (D4)
/PE10: J1.B19 (Pin_b19), U1.55 (PE10), U12.2 (D2)
/PE11: J1.A30 (Pin_a30), U1.56 (PE11), U15.1 (D1)
/PE12: J1.A18 (Pin_a18), U1.53 (PE12), U12.1 (D1)
/PE13: J1.B31 (Pin_b31), U1.54 (PE13), U15.2 (D2)
/PE14: J1.A17 (Pin_a17), U1.51 (PE14), U5.5 (D4)
/PE15: J1.B32 (Pin_b32), U1.52 (PE15), U15.4 (D3)
GND: C1.2, C3.2, C4.2, C5.2, C6.1, C7.1, C8.2, J1.A1 (Pin_a1), J1.A2 (Pin_a2), J1.A3 (Pin_a3), J1.A4 (Pin_a4), J2.G (GND), J2.SHLD, R1.2, R2.2, R6.1, SW2.1, U1.43 (GND), U1.45 (GND), U1.46 (GND), U1.73 (GND), U1.87 (GND), U2.3 (GND), U3.3 (GND), U4.3 (GND), U5.3 (GND), U6.3 (GND), U7.3 (GND), U8.3 (GND), U9.3 (GND), U10.3 (GND), U11.3 (GND), U12.3 (GND), U13.3 (GND), U14.3 (GND), U15.3 (GND), U16.3 (GND), U16.29 (GND), U17.3 (GND)
unnamed: D2.2 (A), R8.1
unnamed: D2.1 (K), U16.19 (~TXT/GPIO.0)
unnamed: D3.2 (A), R9.1
unnamed: D3.1 (K), U16.18 (~RXT/GPIO.1)
unnamed: J2.A5 (CC1), R1.1
unnamed: J2.B5 (CC2), R2.1
unnamed: J2.VB (VBUS), R7.2
unnamed: J2.A6 (D+), J2.B6 (D+), U16.4 (D+), U17.2 (D2)
unnamed: J2.A7 (D-), J2.B7 (D-), U16.5 (D-), U17.1 (D1)
unnamed: R3.1, U16.25 (RXD)
unnamed: R4.1, U16.26 (TXD)
unnamed: R6.2, R7.1, U16.8 (VBUS)
unnamed: C5.1, C8.1, R5.2, R8.2, R9.2, U16.6 (VDD)
unnamed: R5.1, U16.9 (~RSTb)

Notes on the sheet:
ESD Protection
MCU Module Headers
Data Link USB Serial
Edge Connector
POWER
MCU Module modifications: * Remove diode D10. This is the diode adjacent to the red LED near the USB connector.

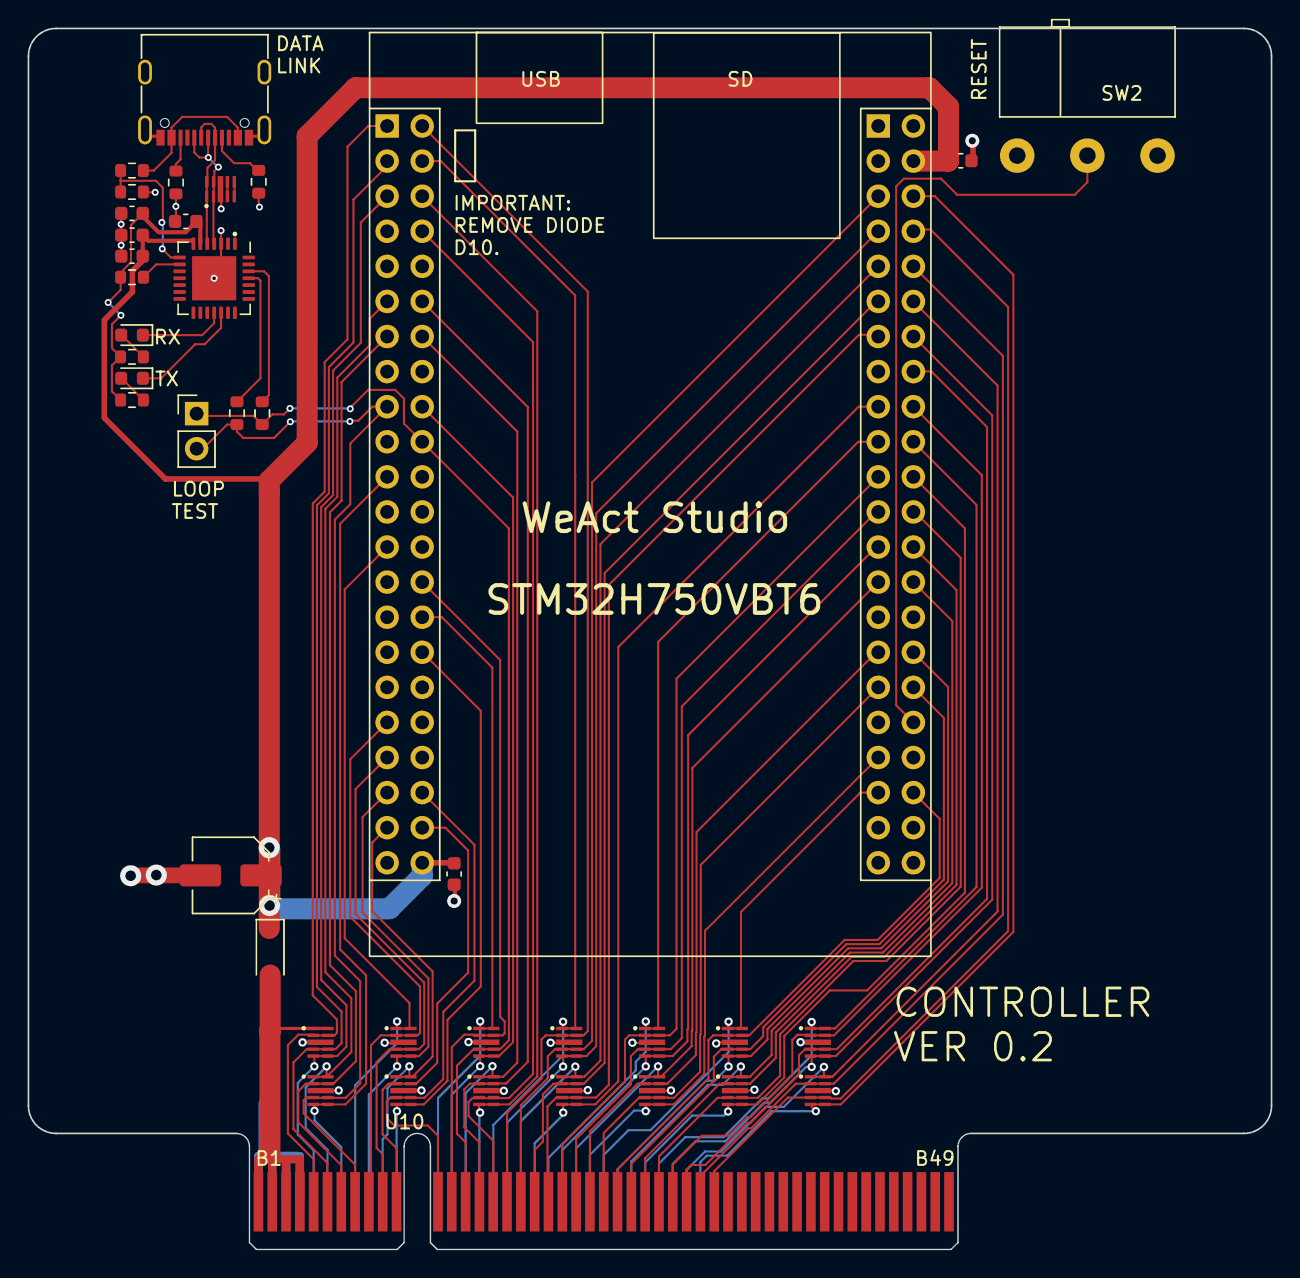
[picture p36: board controller.kicad_pcb from above]

Board: 2 copper layers, 90.0 x 88.4 mm, 40 parts (0 on the bottom side), 73 nets.
