zapta/daq/power_supply/kicad/power_supply.kicad_pcb

## KiCad design power_supply/kicad/power_supply.kicad_pcb (2023-07-20)

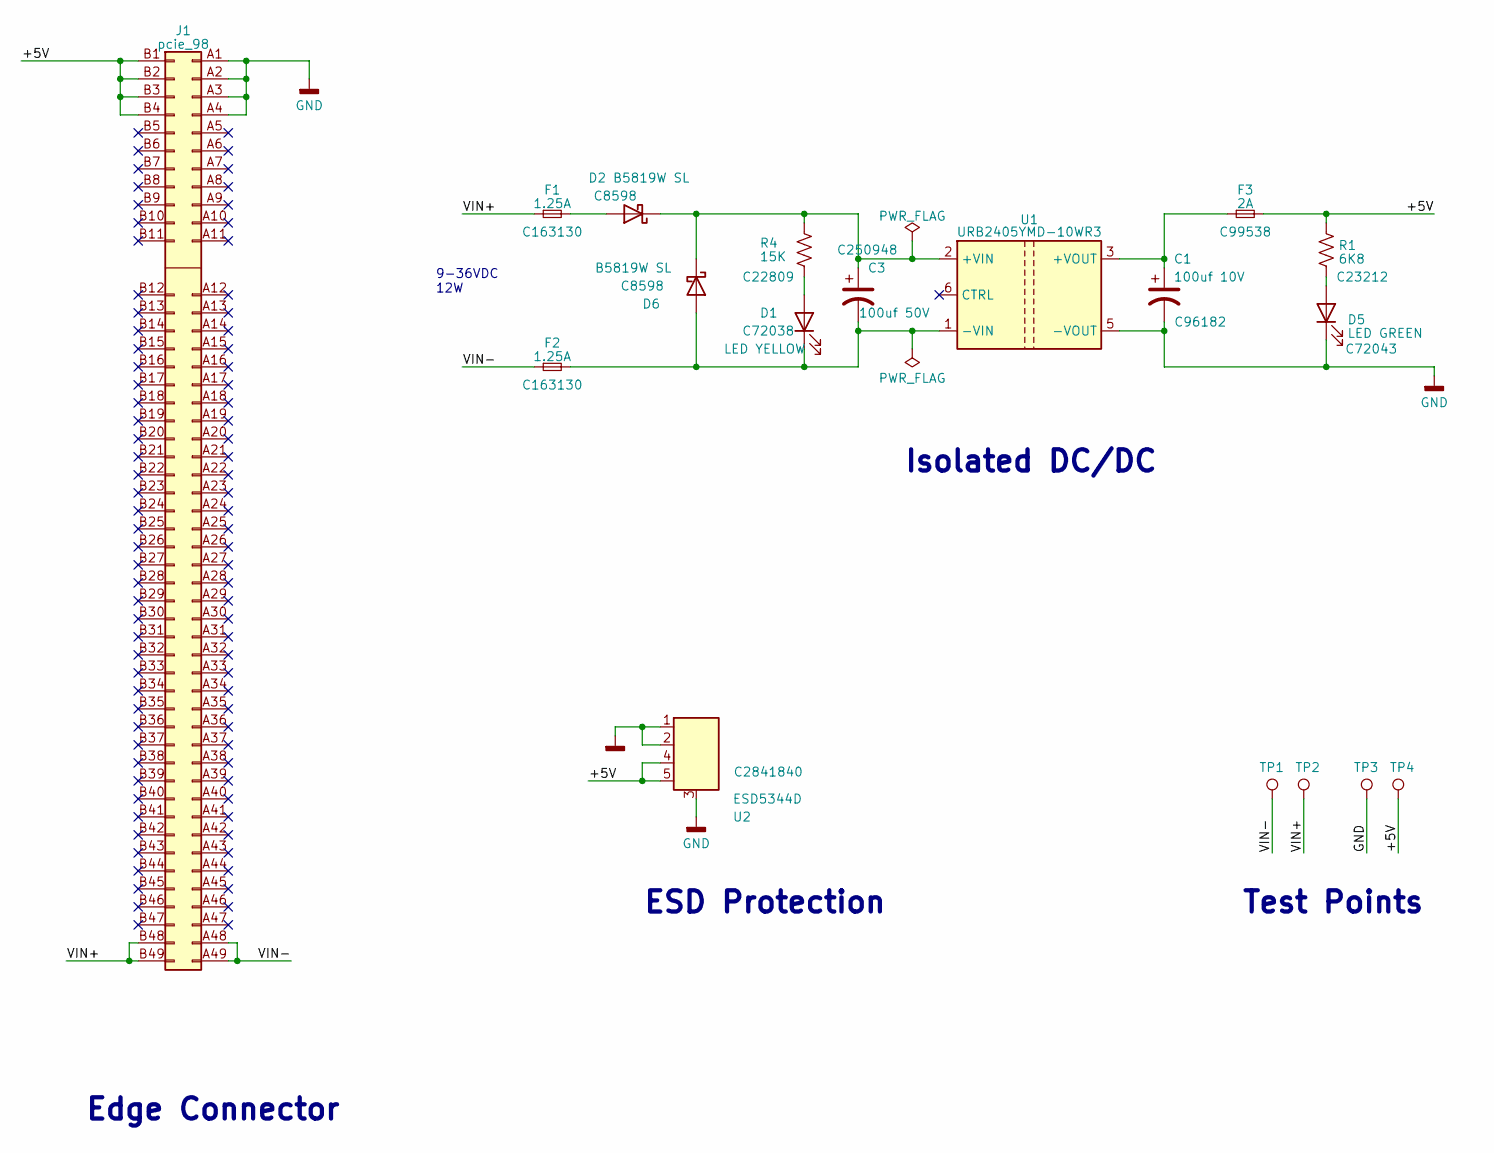
[picture p37: schematic power_supply.kicad_sch]

Parts:
C1: 100uf 10V; CP_Elec_5x5.4; LCSC C96182
C3: 100uf 50V; C_Elec_8x10.2; LCSC C250948
D1: LED YELLOW; LED_0603_1608Metric; LCSC C72038
D2, D6: B5819W SL; D_SOD-123; LCSC C8598
D5: LED GREEN; LED_0603_1608Metric; LCSC C72043
F1, F2: 1.25A; Fuse_1206_3216Metric_Pad1.42x1.75mm_HandSolder; LCSC C163130
F3: 2A; Fuse_1206_3216Metric_Pad1.42x1.75mm_HandSolder; LCSC C99538
J1: pcie_98; PCIE_98_CARD; LCSC DNP
R1: 6K8; R_0603_1608Metric; LCSC C23212
R4: 15K; R_0603_1608Metric; LCSC C22809
TP1, TP2, TP3, TP4: TestPoint; Test_Pad; LCSC DNP
U1: URB2405YMD-10WR3; DCDC; LCSC C91825
U2: ESD5344D; Diodes_UDFN-10_1.0x2.5mm_P0.5mm; LCSC C2841840

Connections:
/+5V: F3.2, J1.B1 (Pin_b1), J1.B2 (Pin_b2), J1.B3 (Pin_b3), J1.B4 (Pin_b4), R1.1, TP4.1, U2.4 (D3), U2.5 (D4)
/VIN+: F1.1, J1.B48 (Pin_b48), J1.B49 (Pin_b49), TP2.1
/VIN-: F2.1, J1.A48 (Pin_a48), J1.A49 (Pin_a49), TP1.1
GND: C1.2, D5.1 (K), J1.A1 (Pin_a1), J1.A2 (Pin_a2), J1.A3 (Pin_a3), J1.A4 (Pin_a4), TP3.1, U1.5 (-VOUT), U2.1 (D1), U2.2 (D2), U2.3 (GND)
unnamed: D1.2 (A), R4.2
unnamed: C3.2, D1.1 (K), D6.2 (A), F2.2, U1.1 (-VIN)
unnamed: D2.2 (A), F1.2
unnamed: C3.1, D2.1 (K), D6.1 (K), R4.1, U1.2 (+VIN)
unnamed: D5.2 (A), R1.2
unnamed: C1.1, F3.1, U1.3 (+VOUT)

Notes on the sheet:
ESD Protection
9-36VDC 12W
Edge Connector
Isolated DC/DC
Test Points

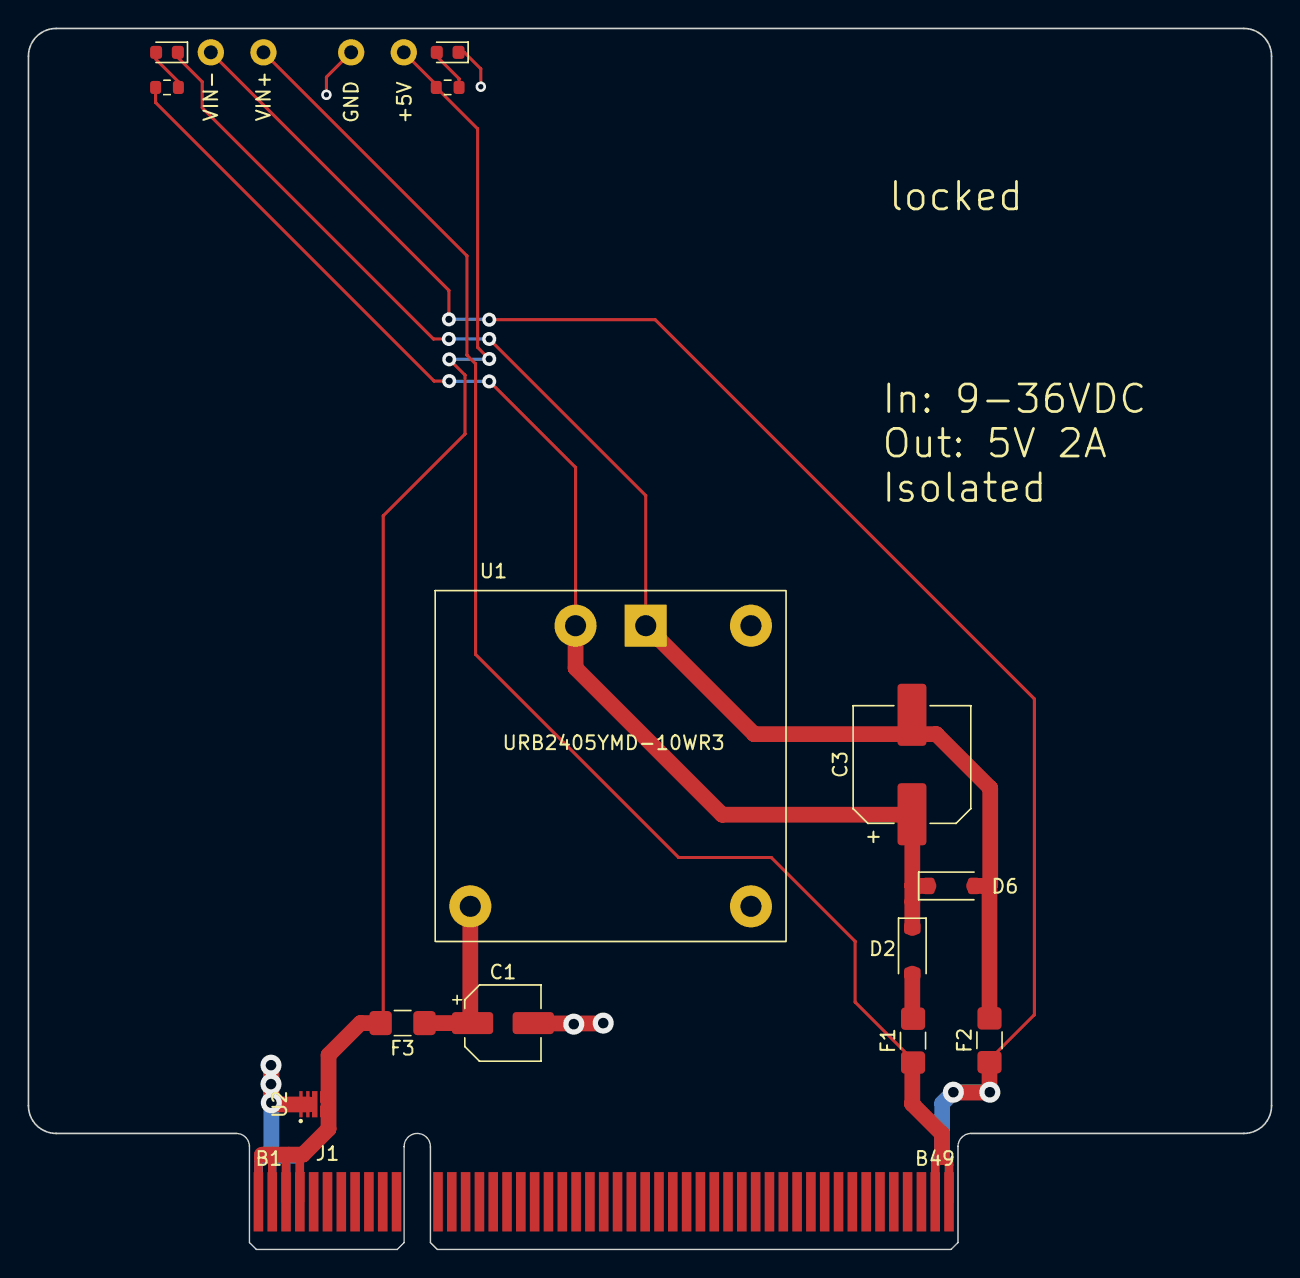
[picture p38: board power_supply.kicad_pcb from above]

Board: 2 copper layers, 90.0 x 88.4 mm, 18 parts (0 on the bottom side), 10 nets.
