zapta/daq/backplane/kicad/backplane.kicad_pcb

## KiCad design backplane/kicad/backplane.kicad_pcb (2023-07-19)

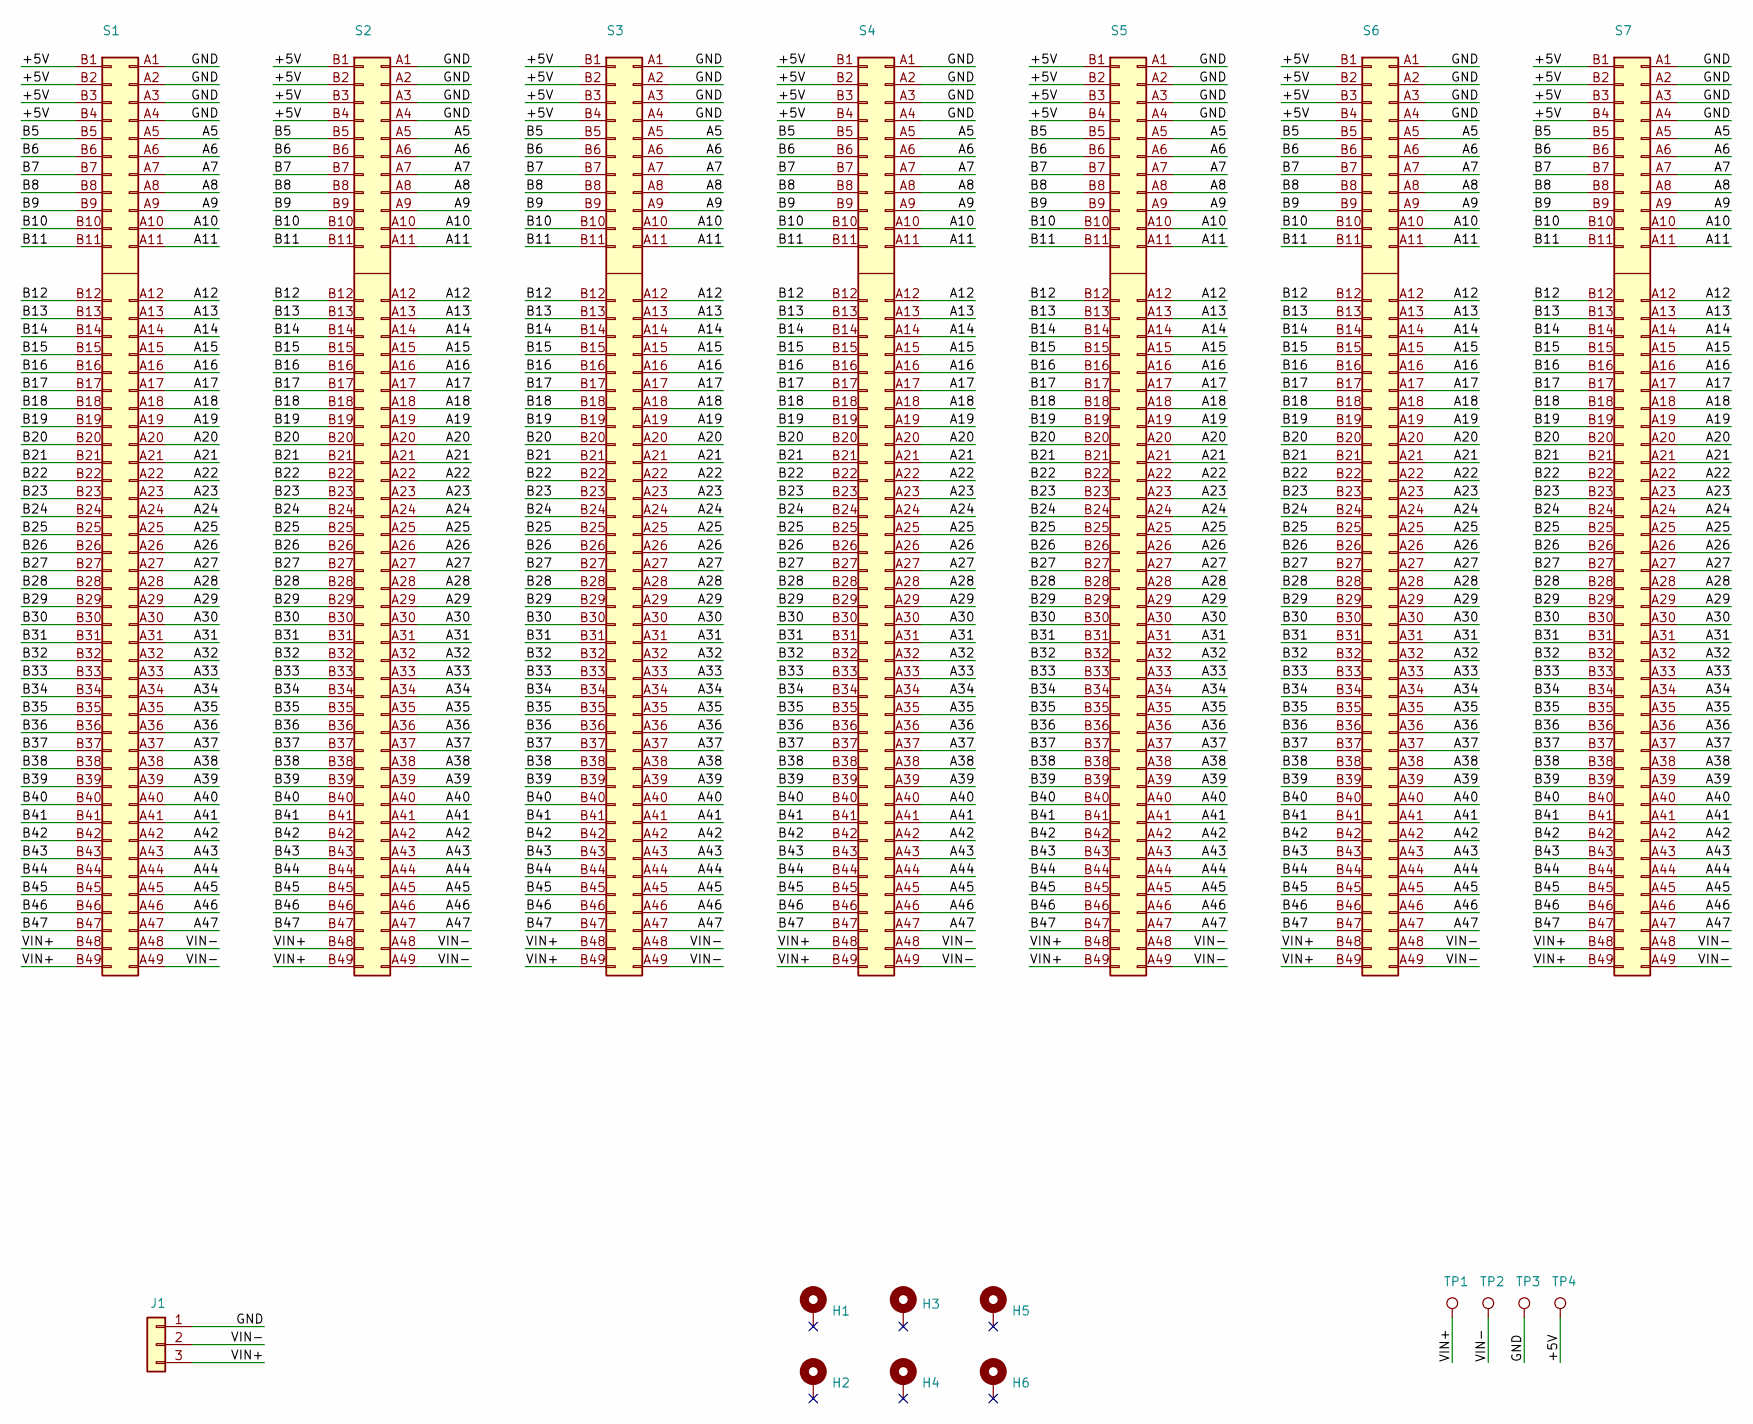
[picture p39: schematic backplane.kicad_sch, Backplane board]

Parts:
H1, H2, H3, H4, H5, H6: MountingHole; MountingHole_3.2mm_M3_Pad_Via
J1: Conn_01x02_Pin; TerminalBlock_3P_7.62mm; LCSC C557662
S1, S2, S3, S4, S5, S6, S7: pcie_98; pcie_98_socket
TP1, TP2, TP3, TP4: TestPoint; Test_Pad

Connections:
/+5V: S1.B1 (Pin_b1), S1.B2 (Pin_b2), S1.B3 (Pin_b3), S1.B4 (Pin_b4), S2.B1 (Pin_b1), S2.B2 (Pin_b2), S2.B3 (Pin_b3), S2.B4 (Pin_b4), S3.B1 (Pin_b1), S3.B2 (Pin_b2), S3.B3 (Pin_b3), S3.B4 (Pin_b4), S4.B1 (Pin_b1), S4.B2 (Pin_b2), S4.B3 (Pin_b3), S4.B4 (Pin_b4), S5.B1 (Pin_b1), S5.B2 (Pin_b2), S5.B3 (Pin_b3), S5.B4 (Pin_b4), S6.B1 (Pin_b1), S6.B2 (Pin_b2), S6.B3 (Pin_b3), S6.B4 (Pin_b4), S7.B1 (Pin_b1), S7.B2 (Pin_b2), S7.B3 (Pin_b3), S7.B4 (Pin_b4), TP4.1
/A5: S1.A5 (Pin_a5), S2.A5 (Pin_a5), S3.A5 (Pin_a5), S4.A5 (Pin_a5), S5.A5 (Pin_a5), S6.A5 (Pin_a5), S7.A5 (Pin_a5)
/A6: S1.A6 (Pin_a6), S2.A6 (Pin_a6), S3.A6 (Pin_a6), S4.A6 (Pin_a6), S5.A6 (Pin_a6), S6.A6 (Pin_a6), S7.A6 (Pin_a6)
/A7: S1.A7 (Pin_a7), S2.A7 (Pin_a7), S3.A7 (Pin_a7), S4.A7 (Pin_a7), S5.A7 (Pin_a7), S6.A7 (Pin_a7), S7.A7 (Pin_a7)
/A8: S1.A8 (Pin_a8), S2.A8 (Pin_a8), S3.A8 (Pin_a8), S4.A8 (Pin_a8), S5.A8 (Pin_a8), S6.A8 (Pin_a8), S7.A8 (Pin_a8)
/A9: S1.A9 (Pin_a9), S2.A9 (Pin_a9), S3.A9 (Pin_a9), S4.A9 (Pin_a9), S5.A9 (Pin_a9), S6.A9 (Pin_a9), S7.A9 (Pin_a9)
/A10: S1.A10 (Pin_a10), S2.A10 (Pin_a10), S3.A10 (Pin_a10), S4.A10 (Pin_a10), S5.A10 (Pin_a10), S6.A10 (Pin_a10), S7.A10 (Pin_a10)
/A11: S1.A11, S2.A11, S3.A11, S4.A11, S5.A11, S6.A11, S7.A11
/A12: S1.A12 (Pin_a12), S2.A12 (Pin_a12), S3.A12 (Pin_a12), S4.A12 (Pin_a12), S5.A12 (Pin_a12), S6.A12 (Pin_a12), S7.A12 (Pin_a12)
/A13: S1.A13 (Pin_a13), S2.A13 (Pin_a13), S3.A13 (Pin_a13), S4.A13 (Pin_a13), S5.A13 (Pin_a13), S6.A13 (Pin_a13), S7.A13 (Pin_a13)
/A14: S1.A14 (Pin_a14), S2.A14 (Pin_a14), S3.A14 (Pin_a14), S4.A14 (Pin_a14), S5.A14 (Pin_a14), S6.A14 (Pin_a14), S7.A14 (Pin_a14)
/A15: S1.A15 (Pin_a15), S2.A15 (Pin_a15), S3.A15 (Pin_a15), S4.A15 (Pin_a15), S5.A15 (Pin_a15), S6.A15 (Pin_a15), S7.A15 (Pin_a15)
/A16: S1.A16 (Pin_a16), S2.A16 (Pin_a16), S3.A16 (Pin_a16), S4.A16 (Pin_a16), S5.A16 (Pin_a16), S6.A16 (Pin_a16), S7.A16 (Pin_a16)
/A17: S1.A17 (Pin_a17), S2.A17 (Pin_a17), S3.A17 (Pin_a17), S4.A17 (Pin_a17), S5.A17 (Pin_a17), S6.A17 (Pin_a17), S7.A17 (Pin_a17)
/A18: S1.A18 (Pin_a18), S2.A18 (Pin_a18), S3.A18 (Pin_a18), S4.A18 (Pin_a18), S5.A18 (Pin_a18), S6.A18 (Pin_a18), S7.A18 (Pin_a18)
/A19: S1.A19 (Pin_a19), S2.A19 (Pin_a19), S3.A19 (Pin_a19), S4.A19 (Pin_a19), S5.A19 (Pin_a19), S6.A19 (Pin_a19), S7.A19 (Pin_a19)
/A20: S1.A20 (Pin_a20), S2.A20 (Pin_a20), S3.A20 (Pin_a20), S4.A20 (Pin_a20), S5.A20 (Pin_a20), S6.A20 (Pin_a20), S7.A20 (Pin_a20)
/A21: S1.A21 (Pin_a21), S2.A21 (Pin_a21), S3.A21 (Pin_a21), S4.A21 (Pin_a21), S5.A21 (Pin_a21), S6.A21 (Pin_a21), S7.A21 (Pin_a21)
/A22: S1.A22 (Pin_a22), S2.A22 (Pin_a22), S3.A22 (Pin_a22), S4.A22 (Pin_a22), S5.A22 (Pin_a22), S6.A22 (Pin_a22), S7.A22 (Pin_a22)
/A23: S1.A23 (Pin_a23), S2.A23 (Pin_a23), S3.A23 (Pin_a23), S4.A23 (Pin_a23), S5.A23 (Pin_a23), S6.A23 (Pin_a23), S7.A23 (Pin_a23)
/A24: S1.A24 (Pin_a24), S2.A24 (Pin_a24), S3.A24 (Pin_a24), S4.A24 (Pin_a24), S5.A24 (Pin_a24), S6.A24 (Pin_a24), S7.A24 (Pin_a24)
/A25: S1.A25 (Pin_a25), S2.A25 (Pin_a25), S3.A25 (Pin_a25), S4.A25 (Pin_a25), S5.A25 (Pin_a25), S6.A25 (Pin_a25), S7.A25 (Pin_a25)
/A26: S1.A26 (Pin_a26), S2.A26 (Pin_a26), S3.A26 (Pin_a26), S4.A26 (Pin_a26), S5.A26 (Pin_a26), S6.A26 (Pin_a26), S7.A26 (Pin_a26)
/A27: S1.A27 (Pin_a27), S2.A27 (Pin_a27), S3.A27 (Pin_a27), S4.A27 (Pin_a27), S5.A27 (Pin_a27), S6.A27 (Pin_a27), S7.A27 (Pin_a27)
/A28: S1.A28 (Pin_a28), S2.A28 (Pin_a28), S3.A28 (Pin_a28), S4.A28 (Pin_a28), S5.A28 (Pin_a28), S6.A28 (Pin_a28), S7.A28 (Pin_a28)
/A29: S1.A29 (Pin_a29), S2.A29 (Pin_a29), S3.A29 (Pin_a29), S4.A29 (Pin_a29), S5.A29 (Pin_a29), S6.A29 (Pin_a29), S7.A29 (Pin_a29)
/A30: S1.A30 (Pin_a30), S2.A30 (Pin_a30), S3.A30 (Pin_a30), S4.A30 (Pin_a30), S5.A30 (Pin_a30), S6.A30 (Pin_a30), S7.A30 (Pin_a30)
/A31: S1.A31 (Pin_a31), S2.A31 (Pin_a31), S3.A31 (Pin_a31), S4.A31 (Pin_a31), S5.A31 (Pin_a31), S6.A31 (Pin_a31), S7.A31 (Pin_a31)
/A32: S1.A32 (Pin_a32), S2.A32 (Pin_a32), S3.A32 (Pin_a32), S4.A32 (Pin_a32), S5.A32 (Pin_a32), S6.A32 (Pin_a32), S7.A32 (Pin_a32)
/A33: S1.A33 (Pin_a33), S2.A33 (Pin_a33), S3.A33 (Pin_a33), S4.A33 (Pin_a33), S5.A33 (Pin_a33), S6.A33 (Pin_a33), S7.A33 (Pin_a33)
/A34: S1.A34 (Pin_a34), S2.A34 (Pin_a34), S3.A34 (Pin_a34), S4.A34 (Pin_a34), S5.A34 (Pin_a34), S6.A34 (Pin_a34), S7.A34 (Pin_a34)
/A35: S1.A35 (Pin_a35), S2.A35 (Pin_a35), S3.A35 (Pin_a35), S4.A35 (Pin_a35), S5.A35 (Pin_a35), S6.A35 (Pin_a35), S7.A35 (Pin_a35)
/A36: S1.A36 (Pin_a36), S2.A36 (Pin_a36), S3.A36 (Pin_a36), S4.A36 (Pin_a36), S5.A36 (Pin_a36), S6.A36 (Pin_a36), S7.A36 (Pin_a36)
/A37: S1.A37 (Pin_a37), S2.A37 (Pin_a37), S3.A37 (Pin_a37), S4.A37 (Pin_a37), S5.A37 (Pin_a37), S6.A37 (Pin_a37), S7.A37 (Pin_a37)
/A38: S1.A38 (Pin_a38), S2.A38 (Pin_a38), S3.A38 (Pin_a38), S4.A38 (Pin_a38), S5.A38 (Pin_a38), S6.A38 (Pin_a38), S7.A38 (Pin_a38)
/A39: S1.A39 (Pin_a39), S2.A39 (Pin_a39), S3.A39 (Pin_a39), S4.A39 (Pin_a39), S5.A39 (Pin_a39), S6.A39 (Pin_a39), S7.A39 (Pin_a39)
/A40: S1.A40 (Pin_a40), S2.A40 (Pin_a40), S3.A40 (Pin_a40), S4.A40 (Pin_a40), S5.A40 (Pin_a40), S6.A40 (Pin_a40), S7.A40 (Pin_a40)
/A41: S1.A41 (Pin_a41), S2.A41 (Pin_a41), S3.A41 (Pin_a41), S4.A41 (Pin_a41), S5.A41 (Pin_a41), S6.A41 (Pin_a41), S7.A41 (Pin_a41)
/A42: S1.A42 (Pin_a42), S2.A42 (Pin_a42), S3.A42 (Pin_a42), S4.A42 (Pin_a42), S5.A42 (Pin_a42), S6.A42 (Pin_a42), S7.A42 (Pin_a42)
/A43: S1.A43 (Pin_a43), S2.A43 (Pin_a43), S3.A43 (Pin_a43), S4.A43 (Pin_a43), S5.A43 (Pin_a43), S6.A43 (Pin_a43), S7.A43 (Pin_a43)
/A44: S1.A44 (Pin_a44), S2.A44 (Pin_a44), S3.A44 (Pin_a44), S4.A44 (Pin_a44), S5.A44 (Pin_a44), S6.A44 (Pin_a44), S7.A44 (Pin_a44)
/A45: S1.A45 (Pin_a45), S2.A45 (Pin_a45), S3.A45 (Pin_a45), S4.A45 (Pin_a45), S5.A45 (Pin_a45), S6.A45 (Pin_a45), S7.A45 (Pin_a45)
/A46: S1.A46 (Pin_a46), S2.A46 (Pin_a46), S3.A46 (Pin_a46), S4.A46 (Pin_a46), S5.A46 (Pin_a46), S6.A46 (Pin_a46), S7.A46 (Pin_a46)
/A47: S1.A47 (Pin_a47), S2.A47 (Pin_a47), S3.A47 (Pin_a47), S4.A47 (Pin_a47), S5.A47 (Pin_a47), S6.A47 (Pin_a47), S7.A47 (Pin_a47)
/B5: S1.B5 (Pin_b5), S2.B5 (Pin_b5), S3.B5 (Pin_b5), S4.B5 (Pin_b5), S5.B5 (Pin_b5), S6.B5 (Pin_b5), S7.B5 (Pin_b5)
/B6: S1.B6 (Pin_b6), S2.B6 (Pin_b6), S3.B6 (Pin_b6), S4.B6 (Pin_b6), S5.B6 (Pin_b6), S6.B6 (Pin_b6), S7.B6 (Pin_b6)
/B7: S1.B7 (Pin_b7), S2.B7 (Pin_b7), S3.B7 (Pin_b7), S4.B7 (Pin_b7), S5.B7 (Pin_b7), S6.B7 (Pin_b7), S7.B7 (Pin_b7)
/B8: S1.B8 (Pin_b8), S2.B8 (Pin_b8), S3.B8 (Pin_b8), S4.B8 (Pin_b8), S5.B8 (Pin_b8), S6.B8 (Pin_b8), S7.B8 (Pin_b8)
/B9: S1.B9 (Pin_b9), S2.B9 (Pin_b9), S3.B9 (Pin_b9), S4.B9 (Pin_b9), S5.B9 (Pin_b9), S6.B9 (Pin_b9), S7.B9 (Pin_b9)
/B10: S1.B10 (Pin_b10), S2.B10 (Pin_b10), S3.B10 (Pin_b10), S4.B10 (Pin_b10), S5.B10 (Pin_b10), S6.B10 (Pin_b10), S7.B10 (Pin_b10)
/B11: S1.B11 (Pin_b11), S2.B11 (Pin_b11), S3.B11 (Pin_b11), S4.B11 (Pin_b11), S5.B11 (Pin_b11), S6.B11 (Pin_b11), S7.B11 (Pin_b11)
/B12: S1.B12 (Pin_b12), S2.B12 (Pin_b12), S3.B12 (Pin_b12), S4.B12 (Pin_b12), S5.B12 (Pin_b12), S6.B12 (Pin_b12), S7.B12 (Pin_b12)
/B13: S1.B13 (Pin_b13), S2.B13 (Pin_b13), S3.B13 (Pin_b13), S4.B13 (Pin_b13), S5.B13 (Pin_b13), S6.B13 (Pin_b13), S7.B13 (Pin_b13)
/B14: S1.B14 (Pin_b14), S2.B14 (Pin_b14), S3.B14 (Pin_b14), S4.B14 (Pin_b14), S5.B14 (Pin_b14), S6.B14 (Pin_b14), S7.B14 (Pin_b14)
/B15: S1.B15 (Pin_b15), S2.B15 (Pin_b15), S3.B15 (Pin_b15), S4.B15 (Pin_b15), S5.B15 (Pin_b15), S6.B15 (Pin_b15), S7.B15 (Pin_b15)
/B16: S1.B16 (Pin_b16), S2.B16 (Pin_b16), S3.B16 (Pin_b16), S4.B16 (Pin_b16), S5.B16 (Pin_b16), S6.B16 (Pin_b16), S7.B16 (Pin_b16)
/B17: S1.B17 (Pin_b17), S2.B17 (Pin_b17), S3.B17 (Pin_b17), S4.B17 (Pin_b17), S5.B17 (Pin_b17), S6.B17 (Pin_b17), S7.B17 (Pin_b17)
/B18: S1.B18 (Pin_b18), S2.B18 (Pin_b18), S3.B18 (Pin_b18), S4.B18 (Pin_b18), S5.B18 (Pin_b18), S6.B18 (Pin_b18), S7.B18 (Pin_b18)
/B19: S1.B19 (Pin_b19), S2.B19 (Pin_b19), S3.B19 (Pin_b19), S4.B19 (Pin_b19), S5.B19 (Pin_b19), S6.B19 (Pin_b19), S7.B19 (Pin_b19)
/B20: S1.B20 (Pin_b20), S2.B20 (Pin_b20), S3.B20 (Pin_b20), S4.B20 (Pin_b20), S5.B20 (Pin_b20), S6.B20 (Pin_b20), S7.B20 (Pin_b20)
/B21: S1.B21 (Pin_b21), S2.B21 (Pin_b21), S3.B21 (Pin_b21), S4.B21 (Pin_b21), S5.B21 (Pin_b21), S6.B21 (Pin_b21), S7.B21 (Pin_b21)
/B22: S1.B22 (Pin_b22), S2.B22 (Pin_b22), S3.B22 (Pin_b22), S4.B22 (Pin_b22), S5.B22 (Pin_b22), S6.B22 (Pin_b22), S7.B22 (Pin_b22)
/B23: S1.B23 (Pin_b23), S2.B23 (Pin_b23), S3.B23 (Pin_b23), S4.B23 (Pin_b23), S5.B23 (Pin_b23), S6.B23 (Pin_b23), S7.B23 (Pin_b23)
/B24: S1.B24 (Pin_b24), S2.B24 (Pin_b24), S3.B24 (Pin_b24), S4.B24 (Pin_b24), S5.B24 (Pin_b24), S6.B24 (Pin_b24), S7.B24 (Pin_b24)
/B25: S1.B25 (Pin_b25), S2.B25 (Pin_b25), S3.B25 (Pin_b25), S4.B25 (Pin_b25), S5.B25 (Pin_b25), S6.B25 (Pin_b25), S7.B25 (Pin_b25)
/B26: S1.B26 (Pin_b26), S2.B26 (Pin_b26), S3.B26 (Pin_b26), S4.B26 (Pin_b26), S5.B26 (Pin_b26), S6.B26 (Pin_b26), S7.B26 (Pin_b26)
/B27: S1.B27 (Pin_b27), S2.B27 (Pin_b27), S3.B27 (Pin_b27), S4.B27 (Pin_b27), S5.B27 (Pin_b27), S6.B27 (Pin_b27), S7.B27 (Pin_b27)
/B28: S1.B28 (Pin_b28), S2.B28 (Pin_b28), S3.B28 (Pin_b28), S4.B28 (Pin_b28), S5.B28 (Pin_b28), S6.B28 (Pin_b28), S7.B28 (Pin_b28)
/B29: S1.B29 (Pin_b29), S2.B29 (Pin_b29), S3.B29 (Pin_b29), S4.B29 (Pin_b29), S5.B29 (Pin_b29), S6.B29 (Pin_b29), S7.B29 (Pin_b29)
/B30: S1.B30 (Pin_b30), S2.B30 (Pin_b30), S3.B30 (Pin_b30), S4.B30 (Pin_b30), S5.B30 (Pin_b30), S6.B30 (Pin_b30), S7.B30 (Pin_b30)
/B31: S1.B31 (Pin_b31), S2.B31 (Pin_b31), S3.B31 (Pin_b31), S4.B31 (Pin_b31), S5.B31 (Pin_b31), S6.B31 (Pin_b31), S7.B31 (Pin_b31)
/B32: S1.B32 (Pin_b32), S2.B32 (Pin_b32), S3.B32 (Pin_b32), S4.B32 (Pin_b32), S5.B32 (Pin_b32), S6.B32 (Pin_b32), S7.B32 (Pin_b32)
/B33: S1.B33 (Pin_b33), S2.B33 (Pin_b33), S3.B33 (Pin_b33), S4.B33 (Pin_b33), S5.B33 (Pin_b33), S6.B33 (Pin_b33), S7.B33 (Pin_b33)
/B34: S1.B34 (Pin_b34), S2.B34 (Pin_b34), S3.B34 (Pin_b34), S4.B34 (Pin_b34), S5.B34 (Pin_b34), S6.B34 (Pin_b34), S7.B34 (Pin_b34)
/B35: S1.B35 (Pin_b35), S2.B35 (Pin_b35), S3.B35 (Pin_b35), S4.B35 (Pin_b35), S5.B35 (Pin_b35), S6.B35 (Pin_b35), S7.B35 (Pin_b35)
/B36: S1.B36 (Pin_b36), S2.B36 (Pin_b36), S3.B36 (Pin_b36), S4.B36 (Pin_b36), S5.B36 (Pin_b36), S6.B36 (Pin_b36), S7.B36 (Pin_b36)
/B37: S1.B37 (Pin_b37), S2.B37 (Pin_b37), S3.B37 (Pin_b37), S4.B37 (Pin_b37), S5.B37 (Pin_b37), S6.B37 (Pin_b37), S7.B37 (Pin_b37)
/B38: S1.B38 (Pin_b38), S2.B38 (Pin_b38), S3.B38 (Pin_b38), S4.B38 (Pin_b38), S5.B38 (Pin_b38), S6.B38 (Pin_b38), S7.B38 (Pin_b38)
/B39: S1.B39 (Pin_b39), S2.B39 (Pin_b39), S3.B39 (Pin_b39), S4.B39 (Pin_b39), S5.B39 (Pin_b39), S6.B39 (Pin_b39), S7.B39 (Pin_b39)
/B40: S1.B40 (Pin_b40), S2.B40 (Pin_b40), S3.B40 (Pin_b40), S4.B40 (Pin_b40), S5.B40 (Pin_b40), S6.B40 (Pin_b40), S7.B40 (Pin_b40)
/B41: S1.B41 (Pin_b41), S2.B41 (Pin_b41), S3.B41 (Pin_b41), S4.B41 (Pin_b41), S5.B41 (Pin_b41), S6.B41 (Pin_b41), S7.B41 (Pin_b41)
/B42: S1.B42 (Pin_b42), S2.B42 (Pin_b42), S3.B42 (Pin_b42), S4.B42 (Pin_b42), S5.B42 (Pin_b42), S6.B42 (Pin_b42), S7.B42 (Pin_b42)
/B43: S1.B43 (Pin_b43), S2.B43 (Pin_b43), S3.B43 (Pin_b43), S4.B43 (Pin_b43), S5.B43 (Pin_b43), S6.B43 (Pin_b43), S7.B43 (Pin_b43)
/B44: S1.B44 (Pin_b44), S2.B44 (Pin_b44), S3.B44 (Pin_b44), S4.B44 (Pin_b44), S5.B44 (Pin_b44), S6.B44 (Pin_b44), S7.B44 (Pin_b44)
/B45: S1.B45 (Pin_b45), S2.B45 (Pin_b45), S3.B45 (Pin_b45), S4.B45 (Pin_b45), S5.B45 (Pin_b45), S6.B45 (Pin_b45), S7.B45 (Pin_b45)
/B46: S1.B46 (Pin_46), S2.B46 (Pin_46), S3.B46 (Pin_46), S4.B46 (Pin_46), S5.B46 (Pin_46), S6.B46 (Pin_46), S7.B46 (Pin_46)
/B47: S1.B47 (Pin_b47), S2.B47 (Pin_b47), S3.B47 (Pin_b47), S4.B47 (Pin_b47), S5.B47 (Pin_b47), S6.B47 (Pin_b47), S7.B47 (Pin_b47)
/GND: J1.1, S1.A1 (Pin_a1), S1.A2 (Pin_a2), S1.A3 (Pin_a3), S1.A4 (Pin_a4), S2.A1 (Pin_a1), S2.A2 (Pin_a2), S2.A3 (Pin_a3), S2.A4 (Pin_a4), S3.A1 (Pin_a1), S3.A2 (Pin_a2), S3.A3 (Pin_a3), S3.A4 (Pin_a4), S4.A1 (Pin_a1), S4.A2 (Pin_a2), S4.A3 (Pin_a3), S4.A4 (Pin_a4), S5.A1 (Pin_a1), S5.A2 (Pin_a2), S5.A3 (Pin_a3), S5.A4 (Pin_a4), S6.A1 (Pin_a1), S6.A2 (Pin_a2), S6.A3 (Pin_a3), S6.A4 (Pin_a4), S7.A1 (Pin_a1), S7.A2 (Pin_a2), S7.A3 (Pin_a3), S7.A4 (Pin_a4), TP3.1
/VIN+: J1.3, S1.B48 (Pin_b48), S1.B49 (Pin_b49), S2.B48 (Pin_b48), S2.B49 (Pin_b49), S3.B48 (Pin_b48), S3.B49 (Pin_b49), S4.B48 (Pin_b48), S4.B49 (Pin_b49), S5.B48 (Pin_b48), S5.B49 (Pin_b49), S6.B48 (Pin_b48), S6.B49 (Pin_b49), S7.B48 (Pin_b48), S7.B49 (Pin_b49), TP1.1
/VIN-: J1.2, S1.A48 (Pin_a48), S1.A49 (Pin_a49), S2.A48 (Pin_a48), S2.A49 (Pin_a49), S3.A48 (Pin_a48), S3.A49 (Pin_a49), S4.A48 (Pin_a48), S4.A49 (Pin_a49), S5.A48 (Pin_a48), S5.A49 (Pin_a49), S6.A48 (Pin_a48), S6.A49 (Pin_a49), S7.A48 (Pin_a48), S7.A49 (Pin_a49), TP2.1
