zapta/daq/backplane/kicad/backplane.kicad_pcb

## KiCad design backplane/kicad/backplane.kicad_pcb (continued)

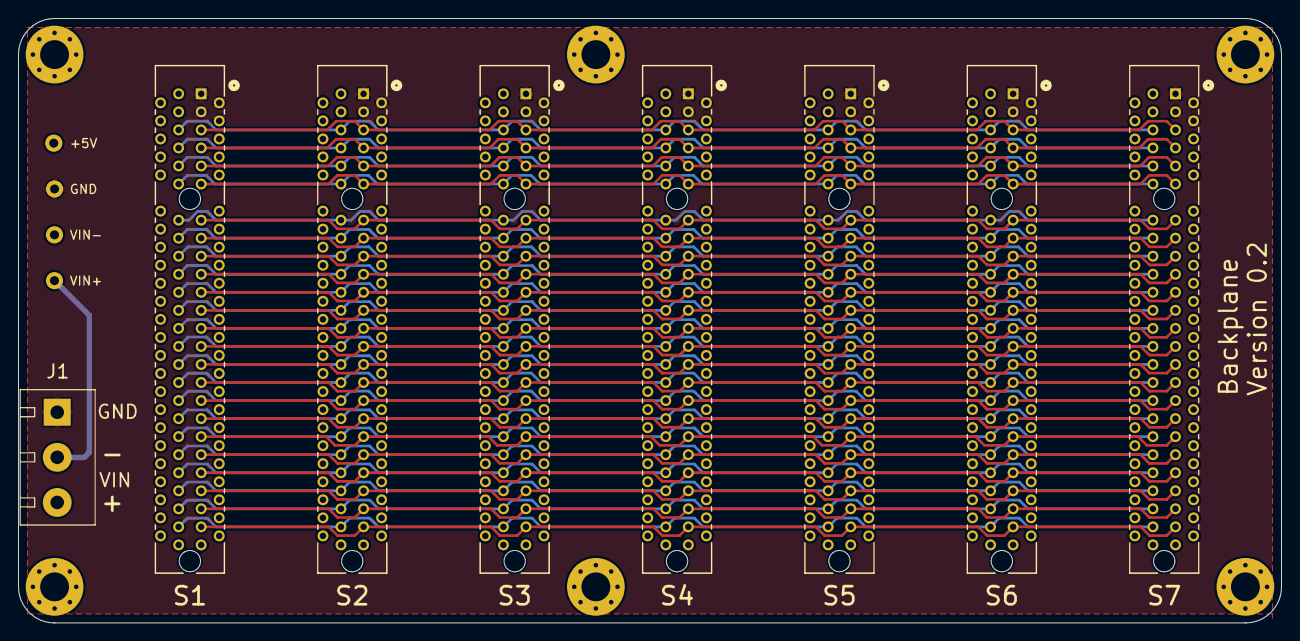
[picture p40: board backplane.kicad_pcb from above]

Board: 4 copper layers, 140.0 x 67.0 mm, 18 parts (0 on the bottom side), 90 nets.
