zapta/daq/controller/cube_ide/cube_ide.ioc

Mcu.UserName=STM32H750VBTx
PA10.Signal=USART1_RX
PA11.Signal=USB_OTG_FS_DM
PA12.Signal=USB_OTG_FS_DP
PA2.Signal=USART2_TX
PA3.Signal=USART2_RX
PA5.GPIO_Label=ADC_SCK
PA5.Signal=SPI1_SCK
PA6.GPIO_Label=ADC_MISO
PA6.Signal=SPI1_MISO
PA7.GPIO_Label=ADC_MOSI
PA7.Signal=SPI1_MOSI
PA9.Signal=USART1_TX
PB14.GPIO_Label=ADC_CS_PWM
PB14.Signal=S_TIM12_CH1
PB7.Signal=I2C1_SDA
PB8.Signal=I2C1_SCL
PC10.Signal=SDMMC1_D2
PC11.Signal=SDMMC1_D3
PC12.Signal=SDMMC1_CK
PC13.GPIO_Label=USER_SWITCH
PC13.Signal=GPIO_Input
PC6.GPIO_Label=IFC_IN1
PC6.Signal=GPIO_Input
PC7.GPIO_Label=IFC_OUT1
PC7.Signal=GPIO_Output
PC8.Signal=SDMMC1_D0
PC9.Signal=SDMMC1_D1
PD1.GPIO_Label=TEST1
PD1.Signal=GPIO_Output
PD2.Signal=SDMMC1_CMD
PD4.GPIO_Label=SD_SWITCH
PD4.Signal=GPIO_Input
PE3.GPIO_Label=LED
PE3.Signal=GPIO_Output
