zapta/daq/controller/platformio-baremetal/src/main.cpp

#include "main.h"

#include <unistd.h>

#include "FreeRTOS.h"
#include "cdc_serial.h"
#include "gpio.h"
#include "io.h"
#include "task.h"
#include "usart.h"
#include "usb_device.h"
#include "usbd_cdc_if.h"
#include "logger.h"

static Logger logger;

// Copied from lib/autogen_core/main.c.ignored.
void SystemClock_Config(void) {
  RCC_OscInitTypeDef RCC_OscInitStruct = {0};
  RCC_ClkInitTypeDef RCC_ClkInitStruct = {0};

  /** Supply configuration update enable
   */
  HAL_PWREx_ConfigSupply(PWR_LDO_SUPPLY);

  /** Configure the main internal regulator output voltage
   */
  __HAL_PWR_VOLTAGESCALING_CONFIG(PWR_REGULATOR_VOLTAGE_SCALE1);

  while (!__HAL_PWR_GET_FLAG(PWR_FLAG_VOSRDY)) {
  }

  __HAL_RCC_SYSCFG_CLK_ENABLE();
  __HAL_PWR_VOLTAGESCALING_CONFIG(PWR_REGULATOR_VOLTAGE_SCALE0);

  while (!__HAL_PWR_GET_FLAG(PWR_FLAG_VOSRDY)) {
  }

  /** Initializes the RCC Oscillators according to the specified parameters
   * in the RCC_OscInitTypeDef structure.
   */
  RCC_OscInitStruct.OscillatorType = RCC_OSCILLATORTYPE_HSE;
  RCC_OscInitStruct.HSEState = RCC_HSE_ON;
  RCC_OscInitStruct.PLL.PLLState = RCC_PLL_ON;
  RCC_OscInitStruct.PLL.PLLSource = RCC_PLLSOURCE_HSE;
  RCC_OscInitStruct.PLL.PLLM = 5;
  RCC_OscInitStruct.PLL.PLLN = 192;
  RCC_OscInitStruct.PLL.PLLP = 2;
  RCC_OscInitStruct.PLL.PLLQ = 2;
  RCC_OscInitStruct.PLL.PLLR = 2;
  RCC_OscInitStruct.PLL.PLLRGE = RCC_PLL1VCIRANGE_2;
  RCC_OscInitStruct.PLL.PLLVCOSEL = RCC_PLL1VCOWIDE;
  RCC_OscInitStruct.PLL.PLLFRACN = 0;
  if (HAL_RCC_OscConfig(&RCC_OscInitStruct) != HAL_OK) {
    Error_Handler();
  }

  /** Initializes the CPU, AHB and APB buses clocks
   */
  RCC_ClkInitStruct.ClockType = RCC_CLOCKTYPE_HCLK | RCC_CLOCKTYPE_SYSCLK |
                                RCC_CLOCKTYPE_PCLK1 | RCC_CLOCKTYPE_PCLK2 |
                                RCC_CLOCKTYPE_D3PCLK1 | RCC_CLOCKTYPE_D1PCLK1;
  RCC_ClkInitStruct.SYSCLKSource = RCC_SYSCLKSOURCE_PLLCLK;
  RCC_ClkInitStruct.SYSCLKDivider = RCC_SYSCLK_DIV1;
  RCC_ClkInitStruct.AHBCLKDivider = RCC_HCLK_DIV4;
  RCC_ClkInitStruct.APB3CLKDivider = RCC_APB3_DIV1;
  RCC_ClkInitStruct.APB1CLKDivider = RCC_APB1_DIV1;
  RCC_ClkInitStruct.APB2CLKDivider = RCC_APB2_DIV1;
  RCC_ClkInitStruct.APB4CLKDivider = RCC_APB4_DIV1;

  if (HAL_RCC_ClockConfig(&RCC_ClkInitStruct, FLASH_LATENCY_1) != HAL_OK) {
    Error_Handler();
  }
}

void main_task(void *argument) {
  // Do not use printf() before calling cdc_serial::setup() here.
  cdc_serial::setup();
  logger.info("Serial USB started");
  // printf("Serial USB initialized\n");

  MX_GPIO_Init();
  MX_USART1_UART_Init();

  int i = 0;
  for (;;) {
    io::LED.toggle();
    logger.info("%04d", i++);
    vTaskDelay(200);
  }
}

// For OpenOCD thread awareness. Per
// https://community.platformio.org/t/freertos-with-stm32cube-framework-on-nucleof767zi/9601
extern "C" {
extern const int uxTopUsedPriority;
__attribute__((section(".rodata"))) const int uxTopUsedPriority =
    configMAX_PRIORITIES - 1;
}

// Based on lib/autogen_core/main.c.ignore
int main(void) {
  // We perform the minimum initialization required to start
  // FreeRTOS and the main task, and then do the rest
  // in the main task..
  HAL_Init();
  SystemClock_Config();
  TaskHandle_t xHandle = NULL;
  xTaskCreate(main_task, "Main", 1000 / sizeof(StackType_t), nullptr, 10,
              &xHandle);
  // Normally, this never returns.
  vTaskStartScheduler();
  Error_Handler();
}

void Error_Handler(void) {
  __disable_irq();
  while (1) {
  }
}
