zapta/daq/controller/cube_ide/Core/Inc/main.h

#define LED_Pin GPIO_PIN_3
#define LED_GPIO_Port GPIOE
#define USER_SWITCH_Pin GPIO_PIN_13
#define USER_SWITCH_GPIO_Port GPIOC
#define ADC_SCK_Pin GPIO_PIN_5
#define ADC_SCK_GPIO_Port GPIOA
#define ADC_MISO_Pin GPIO_PIN_6
#define ADC_MISO_GPIO_Port GPIOA
#define ADC_MOSI_Pin GPIO_PIN_7
#define ADC_MOSI_GPIO_Port GPIOA
#define ADC_CS_PWM_Pin GPIO_PIN_14
#define ADC_CS_PWM_GPIO_Port GPIOB
#define IFC_IN1_Pin GPIO_PIN_6
#define IFC_IN1_GPIO_Port GPIOC
#define IFC_OUT1_Pin GPIO_PIN_7
#define IFC_OUT1_GPIO_Port GPIOC
#define TEST1_Pin GPIO_PIN_1
#define TEST1_GPIO_Port GPIOD
#define SD_SWITCH_Pin GPIO_PIN_4
#define SD_SWITCH_GPIO_Port GPIOD
