zapta/daq/(commit log)

2023-05-10 Work in progress
    [main_board.kicad_pcb, main_board.kicad_sch]
2023-05-11 Added a blank platformio arduino project.
2023-05-11 Added pcie edge footprint.
    [main_board.kicad_pcb, main_board.kicad_sch]
2023-05-11 Added skeleton common kicad.
    [main_board.kicad_pcb, main_board.kicad_sch]
2023-05-11 Added skeleton proto board
    [main_board.kicad_pcb, main_board.kicad_sch]
2023-05-12 Created proto board outline.
    [main_board.kicad_pcb, main_board.kicad_sch, proto_board.kicad_pcb, proto_board.kicad_sch]
2023-05-12 Progress with main board footprints.
    [main_board.kicad_pcb, main_board.kicad_sch, pcie_98_socket.step]
2023-05-13 Created backplane directory.
    [backplane.kicad_pcb, backplane.kicad_sch, pcie_98_socket.step]
2023-05-13 Work in progress. Backlane kicad.
    [backplane.kicad_pcb, backplane.kicad_sch, proto_board.kicad_pcb, proto_board.kicad_sch]
2023-05-13 Proto board work in progress.
    [proto_board.kicad_pcb, proto_board.kicad_sch]
2023-05-14 Performed sample bus routing.
    [backplane.kicad_pcb, backplane.kicad_sch]
2023-05-14 Tweaked backplane dimensions.
    [backplane.kicad_pcb]
2023-05-14 Cleaned up the outline and fanout of the proto board.
    [proto_board.kicad_pcb, proto_board.kicad_sch]
2023-05-14 Resized the proto board and added pads grid.
    [proto_board.kicad_pcb, proto_board.kicad_sch]
2023-05-14 Updated proto board README.md
2023-05-14 More progress on the schematic. Yet to complete the connectivity.
    [proto_board.kicad_pcb, proto_board.kicad_sch]
2023-05-15 outed all the network of the backplan.
    [backplane.kicad_pcb, backplane.kicad_sch]
2023-05-15 Proto board completed.
    [proto_board.kicad_pcb, proto_board.kicad_sch]
2023-05-15 Generated proto board gerbers.
2023-05-15 Completed the routing of the backplane.
    [backplane.kicad_pcb, backplane.kicad_sch]
2023-05-15 Updated the proto board with the assigned power pins.
    [proto_board.kicad_pcb, proto_board.kicad_sch]
2023-05-16 Removed the backplane 5pins connector.
    [backplane.kicad_pcb, backplane.kicad_sch]
2023-05-16 Generated gerber files.
2023-05-16 Added bottom silkscreen to proto board pin header.
    [proto_board.kicad_pcb]
2023-05-16 Generated gerbers for backplane and proto board.
2023-05-16 Increase the clerance from fill areas to outline to 1mm and regenerated gerbers.
    [backplane.kicad_pcb]
2023-05-17 Added a rough script to rename a kicad project.
2023-05-17 Added a skeleton controller kicad project. Need to be renamed.
    [main_board.kicad_pcb, main_board.kicad_sch, pcie_98_socket.step]
2023-05-17 Auto update of the files of controller/kicad to complete the rename from main_board.
    [controller.kicad_pcb, controller.kicad_sch]
2023-05-17 Minor tweak of controller's schematic.
    [controller.kicad_sch]
2023-05-17 Work in progress. Defining SMT32H750 module symbol.
    [controller.kicad_sch]
2023-05-17 Work in progress. Controller schematic.
    [controller.kicad_pcb, controller.kicad_sch]
2023-05-17 Deleting main_board directory. Replaced with controller directory.
    [main_board.kicad_pcb, main_board.kicad_sch, pcie_98_socket.step]
2023-05-19 Controller design in progress. Added ESD diode arrays.
    [controller.kicad_pcb, controller.kicad_sch, esd_diode_x4.step]
2023-05-19 Work in progress. Rouging the MCU signals.
    [controller.kicad_pcb, controller.kicad_sch]
2023-05-19 More progress on routing the controller board.
    [controller.kicad_pcb, controller.kicad_sch]
2023-05-19 First pass of routing all the MCU signals. Needs cleanup.
    [controller.kicad_pcb, controller.kicad_sch]
2023-05-20 Controller board passes ERC and DRC. Needs more cleanup.
    [controller.kicad_pcb, controller.kicad_sch]
2023-05-20 Added to the controller boared 5V power arbitration.
    [controller.kicad_pcb, controller.kicad_sch]
2023-05-20 Added Controller doc and added an optional jumper to short the Schottky diode.
    [controller.kicad_pcb, controller.kicad_sch]
2023-05-20 Fixed the orientation of the 100uf capacitors for JLCPCB.
    [controller.kicad_pcb, controller.kicad_sch]
2023-05-20 Spaced the PCB traks.
    [controller.kicad_pcb, controller.kicad_sch]
2023-05-20 Copied controller directory to power_supply. Before renaming the project.
    [controller.kicad_pcb, controller.kicad_sch, esd_diode_x4.step, pcie_98_socket.step]
2023-05-20 Renamed kicad project to 'power_supply'
    [controller.kicad_pcb, controller.kicad_sch, power_supply.kicad_pcb, power_supply.kicad_sch]
2023-05-20 Set up a skeleton design of the pwoer supply.
    [DC_DC_MODEL.step, pcie_98_socket.step, power_supply.kicad_pcb, power_supply.kicad_sch]
2023-05-20 Added TODO comments.
    [controller.kicad_sch, power_supply.kicad_sch]
2023-05-21 Added LEDs, test points, and LCSC ids.
    [controller.kicad_sch, power_supply.kicad_pcb, power_supply.kicad_sch]
2023-05-21 More cleanup of the power supply's PCB. Not done.
    [power_supply.kicad_pcb, power_supply.kicad_sch]
2023-05-21 Completed the power supply PCB cleanup TODO list. Needs final review.
    [power_supply.kicad_pcb]
2023-05-21 Added to the project's page a link to the power supply board.
2023-05-21 Tweaked the power supply PCB: arranged silkscreen labels, rotated the ESD device.
    [power_supply.kicad_pcb, power_supply.kicad_sch]
2023-05-21 Rendered the 3D view of the power supply board.
2023-05-21 Exposed the LCSC numbers in the Controller's schematic.
    [controller.kicad_sch]
2023-05-21 Simplified the power supply. Removed jumper resistors and output diode. Replaced reverse current leakage resistor with a diode.
    [power_supply.kicad_pcb, power_supply.kicad_sch]
2023-05-21 Simplified the controller board: removed the jumper resistor.
    [controller.kicad_pcb, controller.kicad_sch]
2023-05-21 Added to the power supply board protection fuses.
2023-05-22 Renamed common kicad project to 'commont'. Was 'main_board'.
    [common.kicad_pcb, common.kicad_sch, main_board.kicad_pcb, main_board.kicad_sch]
2023-05-22 More power supply pcb cleanup
    [power_supply.kicad_pcb, power_supply.kicad_sch]
2023-05-22 Deleted schematic and pcb layout of the kicad common project. We need only the symbol and footprint libraries.
    [common.kicad_pcb, common.kicad_sch]
2023-05-22 Changed the power supply board to use common symbol and footprints from 'common'.
    [power_supply.kicad_pcb, power_supply.kicad_sch]
2023-05-22 Refactored libraries to have common symbols, footprints, and 3D models in the common kicad project.
    [controller.kicad_pcb, controller.kicad_sch, esd_diode_x4.step, pcie_98_socket.step]
2023-05-22 Added a TODO to add a serial port to the controller.
    [controller.kicad_sch]
2023-05-22 Updated the doc of the Power Supply module.
    [backplane.kicad_pcb]
2023-05-22 Added to the docs dimensions of the controller board.
2023-05-28 Streamed line the test on the STM32H750.
2023-05-29 Added platformio.ini flag to not archive libs. Eliminates the unhandled interrupt.
2023-05-29 Added to the .ioc definition a LED pin at PE3.
2023-05-30 Added a comment regarding FreeRTOS threads in the debugger.
2023-05-30 Added variable for debugger thread awareness.
2023-05-31 Debugger now works with freertos threads.
2023-05-31 Minor cleanup of the error handler.
    [main.cpp]
2023-05-31 Switched from cmsis 2 to cmsis 1 and added it to the ignored list.
2023-06-01 Cleaned up printf.
2023-06-02 Copied platformio-arduino to a test directory.
2023-06-02 Added a custom board file. No modifications yet.
2023-06-02 Restored the standard platformio board specification. Will revisit custom board later.
2023-06-02 Added printout of task wather mark.
2023-06-03 Serial tx/rx drivers are working.
2023-06-03 Added ADS1261 docs and information.
    [ADS1261-60 Design Calculator.xlsx]
2023-06-03 Added ADC related docs.
2023-06-03 Replaced the cube_ide update shell script with a python script and now patching main.c instead of ignoring it.
    [main.cpp, update_platformio.py]
2023-06-04 Initial step on the ADC schematic.
    [RHB0032E.stp, adc.kicad_pcb, adc.kicad_sch]
2023-06-05 Added a weact .ioc sample file.
2023-06-05 Command round trip is working. Added compile printf verification of logger methods.
2023-06-06 Added a skeleton for the adc driver.
2023-06-06 Added definition for the input switch at pin PC13. Also added a platformio.ini flag to fix a crash in the platformio Check tool.
    [cube_ide.ioc, main.cpp, main.h]
2023-06-06 Assigned pins for ADC SPI and configured the clock to provide 4Mhz. Yet, need to fully configure the SPI channel.
2023-06-06 Configured DMA for adc SPI. Not used yet.
2023-06-06 Changed serial driver to user registered callback handlers for better modularity.
2023-06-07 Assigned a CS pin to the adc SPI signals.
2023-06-07 Had progress with the ADC SPI. Set up DMA and handlers. Need to test basic transaction.
2023-06-07 Added skeleton ADS1261 breakout kicad project. Need to be renamed.
    [RHB0032E.stp, adc.kicad_pcb, adc.kicad_sch]
2023-06-07 Renamed breakout kicad project to 'breakout'.
    [breakout.kicad_pcb, breakout.kicad_sch]
2023-06-08 Add progress on the ADC breakout PCB. Layout is incomplete.
    [breakout.kicad_pcb, breakout.kicad_sch]
2023-06-08 More adc breakout pcb layout cleanup.
    [breakout.kicad_pcb, breakout.kicad_sch]
2023-06-08 Complete the adc breakout board layout.
    [bom.csv, breakout.kicad_pcb, breakout.kicad_sch, positions.csv]
2023-06-08 More progress on the adc SPI dma driver. Incomplete.
2023-06-08 Fixed two component values.
    [bom.csv, breakout.kicad_pcb, breakout.kicad_sch]
2023-06-09 Added skeleton for 5V supply for the ADC.
    [adc.kicad_sch]
2023-06-09 Started to clean up unused controller signals.
    [controller.kicad_pcb, controller.kicad_sch]
2023-06-09 Completed the layout of the power supplies.
    [bom.csv, breakout.kicad_pcb, breakout.kicad_sch, positions.csv]
2023-06-09 Minor tweaks of the silkscreen layer.
    [breakout.kicad_pcb, breakout.kicad_sch, positions.csv]
2023-06-09 Minor schematic reformatting.
    [breakout.kicad_pcb, breakout.kicad_sch]
2023-06-09 Fixed pinout of 3.3V regulator. Final touches.
    [bom.csv, breakout.kicad_pcb, breakout.kicad_sch, positions.csv]
2023-06-09 Removed left over silkscreen reference id.
    [breakout.kicad_pcb]
2023-06-09 Removed another left over silkscreen ref id.
    [breakout.kicad_pcb]
2023-06-09 Generated gerbers with pour fill on (was off).
    [breakout.kicad_pcb]
2023-06-09 Fixed LCSC part number of LED resistor.
    [bom.csv, breakout.kicad_pcb, breakout.kicad_sch]
2023-06-09 Removed yet another reference id from the top silkscreen.
    [breakout.kicad_pcb, breakout.kicad_sch]
2023-06-10 Changed dc/dc/ voltage divider to JLCPCB Basic resistor values.
    [bom.csv, breakout.kicad_pcb, breakout.kicad_sch, positions.csv]
2023-06-10 Fixed warnings regarding mismatches between shematic and layout.
    [breakout.kicad_pcb]
2023-06-10 Migrated from Kicad 7.0.2 to 7.0.5.
    [breakout.kicad_pcb]
2023-06-10 Final touches of the power supply board, before ordering.
    [bom.csv, positions.csv, power_supply.kicad_pcb, power_supply.kicad_sch]
2023-06-11 Fixed the ADS1261 part value to ADS1261B.
    [bom.csv, breakout.kicad_pcb, breakout.kicad_sch]
2023-06-11 Fixed part number of 1.25A fuse.
    [bom.csv, power_supply.kicad_pcb, power_supply.kicad_sch]
2023-06-11 Removed unused TVS's and reassigned controller pins.
    [controller.kicad_pcb, controller.kicad_sch]
2023-06-11 Added to the controller USB/Serial data link.
    [controller.kicad_pcb, controller.kicad_sch]
2023-06-11 Cleaned up a few traces, move the power supply caps.
    [controller.kicad_pcb, controller.kicad_sch]
2023-06-11 Updated part number of a 1uf cap.
    [bom.csv, controller.kicad_pcb, controller.kicad_sch]
2023-06-11 Moved the USB connector closer to the board edge.
    [controller.kicad_pcb, positions.csv]
2023-06-12 Added to the project a local copy of weact_mini_h750vbtx.json board definition.
2023-06-12 Added a generic SMT32H750 board definition.
2023-06-13 Added a sample Unity test.
2023-06-13 Copied the Arduino serial packets unit tests, made the first one (serial_packets_data) to work.
2023-06-14 Deleted the Arduino version. Now fully on freertos.
2023-06-15 Added a TODO to the ADC breakout schematic..
    [breakout.kicad_sch]
2023-06-15 SPI works with ADS1220.
2023-06-15 Minor tweaks of ADS1220 SPI driver.
2023-06-16 Increased the stack size of the idle task, just in case. Was 1KB, now 2KB.
2023-06-16 Added 1Khz ADC timebase using timer 2.
2023-06-16 Converted the adc driver to use task blocking calls (was DMA). Reduced FIFO threshold from 4 to 1 byte to make it to work.
2023-06-16 Moved 1Khz ADC timebase from TIM2 to TIM12. Also had to move UART1 rx/tx to new pins.
2023-06-16 Remove a test pin to resolve a conflict with SD1.
    [cube_ide.ioc, main.h]
2023-06-16 SPI DMA is now synced to 1Khz timebase. Still not a burst of 3 bytes.
2023-06-16 Changed ADC SPI driver to use 32bit words instead of bytes. Continuous reading is now sync'ed to the 1Khz timebase.
2023-06-17 Cleaned up the ADC DMA code. Now using byte size transfer, 3 bytes per sample, CS generated by TIM12, and using single shot mode with a start command on each sample. Seems to be rock solid.
2023-06-17 Simplified the logging of the ADC readings. Now printing only the 10 readings.
2023-06-17 Disabled the ADC SPI CS output pin since we use TIM12 PWM output instead.
2023-06-18 ADC is now read continuously with a circular buffer.
2023-06-18 Added a simple host program to log ADC reports.
2023-06-18 Added timestamp to the ADC reporting packet.
2023-06-18 Moved TEST1 signal to the setup period of the ADC.
2023-06-19 Tweaked the ADC initialization bits.
2023-06-19 Added comment to the ADC breakout schematic.
    [breakout.kicad_sch, test.csv]
2023-06-19 Restored ADC setting.
2023-06-20 Created initial ADC card Kicad project using the breakout project.
    [adc.kicad_pcb, adc.kicad_sch, bom.csv, positions.csv]
2023-06-20 More progress on the ADC schematic.
    [adc.kicad_sch]
2023-06-20 Changed the ADS1220 loadcell ADC to use ratiometric measurement.
2023-06-20 Controller now doesn't send ADC reports unless they are enabled by the host.
2023-06-21 Minor schematic tweaks.
    [adc.kicad_sch]
2023-06-21 ADC now use TIM12 continuos PWM signal also for the individual commands and not just to the cyclic DMA reading. This will allow to add additional ADC channels on the same CS timebase.
2023-06-21 Adapted Serial Packets C++ to the new wire format with independent packet start/end flags.
2023-06-22 ADC now logs data packets to the SD card.
2023-06-22 Basic log dump script is working.
    [test.csv]
2023-06-23 Added simulation of the loadcell input section.
    [sim.kicad_sch]
2023-06-23 Updated the input capacitor values of the ADC schematic (based on SPICE simulation)
    [adc.kicad_sch]
2023-06-23 Minor tweak of the ADC schematic.
    [adc.kicad_sch]
2023-06-24 Log processor now emit a per channel file.
    [output_lc1.csv]
2023-06-24 Changed the log processor to output fixed names files in a given output directory.
    [output_lc1.csv]
2023-06-24 Added net names to ADC breakout board schematic.
    [breakout.kicad_pcb, breakout.kicad_sch]
2023-06-25 Updated proto board to the common card outline.
    [bom.csv, positions.csv, proto_board.kicad_pcb, proto_board.kicad_sch]
2023-06-26 Ported the ADC driver to ADS1261.
2023-06-26 Progressing on the ADC card schematic.
    [adc.kicad_sch]
2023-06-26 Progress with the ADC's schematic.
    [adc.kicad_sch, sim.kicad_sch]
2023-06-26 Added a TODO to the power supply card's schematic.
    [power_supply.kicad_sch]
2023-06-26 Added to the schematic of the power supply a TODO to increase the resistor of the +5V LED.
    [power_supply.kicad_sch]
2023-06-26 Added a comment to the ADC schematic.
    [adc.kicad_sch]
2023-06-27 Updated the Controller's schematic to reflect the new RX/TX pin of the datalink serial link.
    [controller.kicad_sch]
2023-06-27 Added comments to the Backplane schematic.
    [backplane.kicad_sch, controller.kicad_sch]
2023-06-27 Updated RC values in the loadcell simulation.
    [sim.kicad_sch]
2023-06-28 Adapted the ADC driver to the new input assignment.
2023-06-28 Updated the ADC schematic with the new input RC values.
    [adc.kicad_sch]
2023-06-28 Added a comment to the controller's schematic.
    [controller.kicad_sch]
2023-06-28 Added demo python filter.
2023-06-28 Added skeleton hookup board kicad project. Copied from proto board.
    [hookup_board.kicad_pcb, hookup_board.kicad_sch]
2023-06-28 Add more progress on the hookup board's layout.
    [hookup_board.kicad_pcb, hookup_board.kicad_sch]
2023-06-28 Completed the layout of the hookup board.
    [hookup_board.kicad_pcb]
2023-06-29 Deleted redundant kicad rename script.
2023-06-29 Progressing on the ADC layout.
    [adc.kicad_pcb, adc.kicad_sch, controller.kicad_sch]
2023-06-29 More progress with the ADC layout.
    [adc.kicad_pcb, adc.kicad_sch]
2023-06-29 Initial topological routing of the ADC board completed.
    [adc.kicad_pcb, adc.kicad_sch]
2023-06-29 Added a reset button to the controller's schematic.
    [controller.kicad_sch]
2023-06-30 ADC layout is feature complete.
    [adc.kicad_pcb, adc.kicad_sch]
2023-06-30 Tweaked the ADC layout.
    [adc.kicad_pcb, adc.kicad_sch]
2023-06-30 More ADC layout touchups.
    [adc.kicad_pcb, adc.kicad_sch]
2023-06-30 Tweaked ADC layout silkscreen.
    [adc.kicad_pcb]
2023-06-30 Replaced ADC DC/DC inductor with a higher current one.
    [adc.kicad_pcb, adc.kicad_sch]
2023-06-30 Generated ADC production files.
    [bom.csv, positions.csv]
2023-06-30 Updated JLCPCB part info and rotations.
    [adc.kicad_pcb, adc.kicad_sch, bom.csv, positions.csv]
2023-06-30 Fixed library pathes and bus pin number.
    [adc.kicad_pcb, adc.kicad_sch, bom.csv, positions.csv]
2023-06-30 Changed LED to green and used DC/DC footprint with longer pads for manual soldering.
    [adc.kicad_pcb, adc.kicad_sch, bom.csv]
2023-07-01 Changed ADC LEDs values from RED to GRN.
    [adc.kicad_sch]
2023-07-01 Added spreadsheet with thermistor calculations.
    [Thermistors.xlsx]
2023-07-01 Refactored the ADC driver in preparation for adding thermistor channels.
2023-07-02 Change thermistor spreadsheet file format.
    [Thermistors.ods, Thermistors.xlsx]
2023-07-02 Now reporting also thermistor channels to host. Next will convert them to C.
2023-07-04 Now reporting all thermistor points.
2023-07-05 Tweaked the configuration of FATFS and set gcc 'build warnings as errors'.
    [cube_ide.ioc, main.cpp, update_platformio.py]
2023-07-06 Minor SD tweaks: removed the intermediate state before MOUNTED, disable the default logging on start.
2023-07-08 Updated controller serial port schematic. Now powered by bus and has TX/RX leds.
    [controller.kicad_sch]
2023-07-08 Added skeleton toml config for thermistor resistance.
2023-07-08 Added buttons to the monitor GUI. Doesn't work though.
2023-07-09 Added button functionality. Yet to have the status line working.
2023-07-10 Added command to get device status.
2023-07-10 Added display of thermistor series (still in ohms, not grams)
2023-07-10 Increased thermistor display points from 500 to 1000 (2 to 4 minutes)
2023-07-10 Updated sample log file.
2023-07-10 Updated controller and power supply schematics.
    [controller.kicad_sch, power_supply.kicad_sch]
2023-07-11 Cleaning up of the controller's PCB, in progress.
    [controller.kicad_pcb, controller.kicad_sch]
2023-07-11 Made the Controller PCB changes, per the schematic's TODOs.
    [Microswitch - Omron D2F-L-A.stp, controller.kicad_pcb, controller.kicad_sch]
2023-07-11 Verified and updated the microswitch footprint.
    [controller.kicad_pcb, controller.kicad_sch]
2023-07-19 Cleaned up TODOs for next version of backplane.
    [backplane.kicad_pcb, backplane.kicad_sch, screw_terminal.step]
2023-07-20 Cleaned up TODOs of the power supply board.
    [power_supply.kicad_pcb, power_supply.kicad_sch]
2023-07-20 Minor tweak of the schematics.
    [adc.kicad_sch, controller.kicad_sch, power_supply.kicad_pcb, power_supply.kicad_sch]
2023-07-21 Clenaed up ADC TODOs. Changed DC/DC resistors from 0.1% to 1% and merged grounds.
    [adc.kicad_pcb, adc.kicad_sch]
2023-07-22 Cleaned up the monitoring of thermistor 1 (added averaging)
2023-07-23 Updated the thermistor inputs to use 2K voltage divider.
    [adc.kicad_pcb, adc.kicad_sch]
2023-07-23 Forked the Controller's kicad.
    [Microswitch - Omron D2F-L-A.stp, bom.csv, controller.kicad_pcb, controller.kicad_sch, positions.csv]
2023-07-23 Removed the fork of the controller's kicad directory.
    [Microswitch - Omron D2F-L-A.stp, bom.csv, controller.kicad_pcb, controller.kicad_sch, positions.csv]
2023-07-23 Increased the series resistor of the controller's green led from 5k to 10k.
    [controller.kicad_sch]
2023-07-23 Tweaked the ADC to reduce cross talk between the thermistor and load cell channels. Performing double conversion and selecting only the second value, PGA is always enabled. Works but not perfect. Ide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
2023-07-23 Added to the controller board text to remove D10.
    [controller.kicad_pcb]
2023-07-23 Tweaked LEDs values.
    [controller.kicad_sch]
2023-07-24 Added computation of thermistor temperature.
2023-07-24 Generated JLCPCB production files.
    [bom.csv, controller.kicad_pcb, controller.kicad_sch, positions.csv]
2023-07-24 Added support for multiple thermistor graphs.
2023-07-25 Abstracted monitor's load cell and thermistor channels.
2023-07-26 Forked ADC board as IO board. Before renaming.
    [RHB0032E.stp, adc.kicad_pcb, adc.kicad_sch, bom.csv, positions.csv, sim.kicad_sch]
2023-07-26 Removed obsolete production files.
    [bom.csv, positions.csv]
2023-07-26 Renamed the fork of kicad adc to 'io'.
    [io.kicad_pcb, io.kicad_sch, sim.kicad_sch]
2023-07-26 Cleaned out the io kicad from adc leftovers.
    [io.kicad_pcb, io.kicad_sch]
2023-07-26 IO board schematic in progress.
    [io.kicad_sch]
2023-07-26 Fixed the JLC part number of Controller's R9 (was 0402, should be 0603 10K).
    [bom.csv, controller.kicad_sch, positions.csv]
2023-07-26 Left over from previous commit.
    [controller.kicad_pcb]
2023-07-27 IO board schematic is feature complete.
    [io.kicad_pcb, io.kicad_sch]
2023-07-27 Work in progress. Placement of the IO board.
    [io.kicad_pcb, io.kicad_sch]
2023-07-27 Completed the topoligical routing of the IO board.
    [io.kicad_pcb]
2023-07-27 IO layout passes DRC.
    [io.kicad_pcb, io.kicad_sch]
2023-07-27 Tweaked IO board layout.
    [bom.csv, io.kicad_pcb, io.kicad_sch, positions.csv]
2023-07-27 Tweaked the IO board layout.
    [io.kicad_pcb, positions.csv]
2023-07-27 Tweaked the IO card layout
    [io.kicad_pcb]
2023-07-27 Assign MCU pins for the io board. UART2 and gpio I/O.
2023-07-27 Locked UART2 and I/O pins in cube_ide. No semantic changed.
2023-07-27 Fixed the dimensions of the DC/DC footprint and generated production files.
    [B0505MT-1WR4.step]
2023-07-27 Updated JLCPCB part positioning.
    [io.kicad_pcb, io.kicad_sch, positions.csv]
2023-07-27 Fixed the part numbers and footpring of the IO board's 3.3V regulators.
    [bom.csv, io.kicad_pcb, io.kicad_sch, positions.csv]
2023-07-28 Updated LCSC parts numbers of ADC board.
    [adc.kicad_pcb, adc.kicad_sch, bom.csv, positions.csv]
2023-07-28 Tweaked the silkscreen of the IO board.
    [io.kicad_pcb]
2023-07-28 Updated the thermistor modeling.
2023-07-29 added to sys_config thermistor calibration table
2023-07-30 Calibrated the three thermistor channels.
2023-07-30 Simplified the Serial interrupt handlers.
2023-07-30 Added a second serial port. Will be used for printer link.
2023-07-30 Added a skeleton printer link task.
2023-08-01 Implemented the printer link. Not tested yet.
2023-08-01 Fixed the static string unit test.
    [test.cpp]
2023-08-01 Device now report markers to recorder and to monitor.
2023-08-04 Decrease data link rate to 115200. Added an app specific error handler. Added a serial error isr handler.
    [cube_ide.ioc, main.cpp, test.cpp]
2023-08-04 Enabled the STM32 Random Number Generator and use it to select a session id. Next will use it in data link packets.
2023-08-04 Improve the monitor's reset detection by using the device session id.
2023-08-04 Reduced the thermistor graph x span from 200 secs to 70 secs.
2023-08-05 Cleaned up channel names. Refactored a based temperature channel class for future PT1000 expansion.
2023-08-05 Updated sample log.
2023-08-05 Changed the log processor to emit time as ints (millis), was float (secs).
2023-08-05 Test splitter works
    [_tests_ldc1.csv]
2023-08-06 Changed the SD card switch gpio from pull down to pullup.
2023-08-07 Added a TODO (SD LED) to the Controller's schematic.
    [controller.kicad_sch]
2023-08-07 Added to thermistors and RTD configurations an offset setting.
2023-08-08 Extracted the UART chapter from the STM32H750 reference manual.
2023-08-09 Changed the serial ports to use DMA.
2023-08-13 Refactored the ADC slots and cycles. Reduced sampling noise. Verifying static ADC registers values.
    [main.cpp]
2023-08-13 Deleted a temporary file
    [_tests_ldc1.csv]
2023-08-13 Added a TODO to the controller's schematic.
    [controller.kicad_sch]
2023-08-14 Added TODOs to Kicad schematics.
    [io.kicad_sch, power_supply.kicad_sch]
2023-08-15 Added TODOs to kicad schematics (adding a serial number silkscreen)
    [adc.kicad_sch, backplane.kicad_sch, controller.kicad_sch, io.kicad_sch, power_supply.kicad_sch]
2023-08-17 Added to the monitor experimental low pass filter.
2023-08-17 Fixed the RTD temperature interpolation algorithm.
2023-08-17 Added missing clearing for filtered display series on reconnect.
2023-08-17 Added a unit test for the thermistor r to c function.
2023-08-17 Moved sample log file to data directory.
2023-08-17 Removed the display filter functionality. Not useful due to phase shift.
2023-08-18 Created skeleton ui board.
    [B0505MT-1WR4.step, RHB0032E.stp, sim.kicad_sch, ui.kicad_pcb, ui.kicad_sch]
2023-08-18 Created a skeleton display board (based on adc)
    [B0505MT-1WR4.step, RHB0032E.stp, display.kicad_pcb, display.kicad_sch, sim.kicad_sch, ui.kicad_pcb, ui.kicad_sch]
2023-08-18 Work in progress on the display card.
    [display.kicad_sch]
2023-08-19 More progress on the Display board.
    [display.kicad_sch]
2023-08-19 Fixed unity issues regarding test_port and automatic dependency detection.
    [extra_script.py]
2023-08-19 Fixed unit test timing and refactored libraries.
    [extra_script.py]
2023-08-21 Calibrated the new load cell (#01)
2023-08-21 Simplified the in/out gpio pin classes.
2023-08-21 Assigned display pins in the kicad schematic.
    [display.kicad_sch]
2023-08-21 Enabled i2c4 in cube_ide
2023-08-21 Added LED signaling in the error handler.
2023-08-21 Disabled the i2c peripheral. Not going to use it for display.
2023-08-21 Added error handler unit test and renamed App_Error_Handler() to error_handler::Panic()
    [app_main.cpp, test.cpp]
2023-08-21 Removed the directory of the Display board. Not needed anymore.
    [RHB0032E.stp, display.kicad_pcb, display.kicad_sch, sim.kicad_sch]
2023-08-21 Assigned codes to invocations of error_handler::Panic
    [app_main.cpp, test.cpp]
2023-08-22 Created a jupyter notebook with sample dataframe interpolation of missing values.
2023-08-23 Cleaned up channel and files names. Channel names are now all lower case.
2023-08-23 Added a notbook with a low pass filter example.
2023-10-03 Calibrated ADC.
2023-10-03 Added stm32loader to requirements.txt.
2023-10-06 Added more experimental PWM sampling analysis.
2023-10-06 Cloned io into heater card. Before renaming.
    [B0505MT-1WR4.step, RHB0032E.stp, io.kicad_pcb, io.kicad_sch]
2023-10-06 Renamed clone of io into heater
    [B0505MT-1WR4.step, RHB0032E.stp, heater.kicad_pcb, heater.kicad_sch]
2023-10-06 Deleted cloned heater files. Will start a kicad project from scratch.
    [B0505MT-1WR4.step, RHB0032E.stp, heater.kicad_pcb, heater.kicad_sch]
2023-10-07 Created a skeleton Heater board from ADC.
    [RHB0032E.stp, heater.kicad_pcb, heater.kicad_sch]
2023-10-08 Heater board work in progress.
    [heater.kicad_sch]
2023-10-08 Calibrated LC1 adc offset.
2023-10-10 Added peak detector simulator
    [sim.kicad_pcb, sim.kicad_sch]
2023-10-11 Work in spice sim.
    [sim.kicad_sch]
2023-10-12 Working on the heater's schematic.
    [heater.kicad_sch]
2023-10-12 Regenerated flasher.exe. Using a new stm32loader and added -f H7 flag.
2023-10-12 Tweaked the RMS circuit.
    [heater.kicad_sch]
2023-10-13 More progress on the heater design.
    [heater.kicad_sch]
2023-10-14 Heater schematic. Work in progress.
    [heater.kicad_sch]
2023-10-14 Tweaked the heater's schematic.
    [heater.kicad_sch]
2023-10-21 Updated heater schematic.
    [heater.kicad_sch]
2023-10-21 Updated OPA333 pinout
    [heater.kicad_sch]
2023-10-22 Updated the heater schematic.
    [heater.kicad_sch]
2023-10-24 Updated heater schematic
    [heater.kicad_sch]
2023-10-28 Renamed custom board file. No semantic changhe.
2023-10-28 Added I2C1 definitions. Not used yet.
2023-10-29 Updated I2C pins on bus connector.
    [heater.kicad_sch]
2023-10-29 Added a skeleton of i2c process.
2023-10-29 Updated heater's datasheet docs.
2023-10-31 Reformatted file path print.
2023-11-03 Updated heater shchematic (fixed +v rail labels)
    [heater.kicad_sch]
2023-11-03 Tweaked I2c rise and fall time settings in cube IDE.
2023-11-04 I2c channel multiplexing works.
2023-11-04 Split the i2c read_reg into two I2c transactions.
2023-11-04 Updated ADC header comments. No semantic change.
2023-11-04 Added definition of I2C DMA. Not using it yet.
2023-11-04 Refactored i2c handler to seperate setup from timer tick.
2023-11-05 Converted I2C to use DMA.
2023-11-05 I2C now runs on an rtos timer.
2023-11-05 Added serialization of I2C log packets.
2023-11-05 Added host parsing of power channel. Swapped ADC channels 0, 1.
    [heater.kicad_sch]
2023-11-06 Updated heater schematic. No semantic change.
    [heater.kicad_sch]
2023-11-07 Updated heater schematic. Added a note about isolator substitute ic.
    [heater.kicad_sch]
2023-11-07 Changed the i2c timestamps to be samples at the beginning of each timer event for extra consistency.
2023-11-07 Replaced the log example with one that has i2c data.
2023-11-07 Added an automatic detection of the I2C card.
2023-11-07 Switched platformio from my_genericSTM32H750VB to genericSTM32H750VB board.
2023-11-07 Reduced i2C clock to 300Khz
2023-11-08 Renamed adc to adc_card.
2023-11-08 Renamed lib directory to pw_card, printer_link_card.
2023-11-08 Now handling gracefully if the ADC card is not inserted.
2023-11-09 Updated controller's schematic.
    [heater.kicad_sch]
2023-11-10 Changed the static timer to accept the period value in start() instead of in the constructor(). Also exposed the user provided value pvTimerID.
2023-11-10 First installment of the i2c scheduler. Functional but needs cleanup.
2023-11-11 Added TimerCallback to allow timer dispatch to instances.
2023-11-11 More cleanup of the pw_card device class.
2023-11-12 Added states as a preparation for scheduler based I2C hardware detection.
2023-11-12 Added i2c slot rate divider.
2023-11-12 Simplified the ADC code and added log prints of the channels data points intervals.
2023-11-13 Heater PCB layout in progress.
    [heater.kicad_pcb, heater.kicad_sch]
2023-11-13 Heater layout work in progress.
    [JST-VH-2.stp, RHB0032E.stp, SOT23.STEP, dc_dc.step, heater.kicad_pcb, heater.kicad_sch]
2023-11-13 More progress with the heater layout.
    [heater.kicad_pcb, heater.kicad_sch]
2023-11-13 More progress with the heatrer layout
    [heater.kicad_pcb]
2023-11-13 Heater layout work in progress. Passing all DRCs.
    [heater.kicad_pcb, heater.kicad_sch]
2023-11-13 Work in progress. Tweaked the heater layout.
    [heater.kicad_pcb, heater.kicad_sch]
2023-11-13 Work in progress. Added silkscreen labels to the heater layout.
    [heater.kicad_pcb, heater.kicad_sch]
2023-11-13 Updated heater layout. Silk screeen labels are done.
    [heater.kicad_pcb, heater.kicad_sch]
2023-11-14 Adjusted for JLCPCB upload.
    [heater.kicad_pcb, heater.kicad_sch]
2023-11-14 Changed the monitor to display pw1 watts instead of volts.
2023-11-14 Increased the hole of the test point footprint.
    [heater.kicad_pcb]
2023-11-15 Created a snapshot of the single rail heater before moving to a split rail design.
    [JST-VH-2.stp, SOT23.STEP, dc_dc.step, heater.kicad_pcb, heater.kicad_sch, sim.kicad_pcb, sim.kicad_sch]
2023-11-16 Routed V2 of the heater board.
    [B0505MT-1WR4.step, biode_bridge_MBS10.step, heater.kicad_pcb, heater.kicad_sch, io.kicad_sch]
2023-11-16 Updated the heater schematic. Using +/-5V dc/dc instead of a charge pump.
    [D050505T-1WR4.step, heater.kicad_pcb, heater.kicad_sch]
2023-11-16 Cleaned up the heater layout.
    [heater.kicad_pcb, heater.kicad_sch]
2023-11-17 Added series 0R resistors to the power supply rails.
    [heater.kicad_pcb, heater.kicad_sch]
2023-11-18 Cleaned up the sensing network.
    [heater.kicad_pcb, heater.kicad_sch]
2023-11-19 Minor heater layout tweak.
    [heater.kicad_pcb]
2023-11-25 Adapted the ADS1115 configuration and offsets to the dual rail design.
2023-11-26 Updated heater shecmatic and sys config.
    [heater.kicad_sch]
2023-11-26 Changed value of isense op amp serial resistor.
    [heater.kicad_sch]
2023-11-26 Fixed the heater schematic title.
    [heater.kicad_sch]
2023-11-26 Changed the I sense op amp to a low bias current one.
    [heater.kicad_pcb, heater.kicad_sch]
2023-11-28 Verified the footprints.
    [heater.kicad_pcb, heater.kicad_sch]
2023-11-28 Revert "Verified the footprints."
    This reverts commit 7ea96aa900b501c805e2681720e13a392d9a879a.
    [heater.kicad_pcb, heater.kicad_sch]
2023-11-28 Added comments to the heater schematic.
    [heater.kicad_sch]
2023-11-28 Verified footprints and pinouts. (Recovered from a bad merge)
    [heater.kicad_pcb, heater.kicad_sch]
2023-11-28 Added an indicator led for reversed VIN.
    [heater.kicad_pcb, heater.kicad_sch]
2023-11-28 Tweaked the vin indicator.
    [heater.kicad_pcb, heater.kicad_sch]
2023-11-28 Fixed footprint of diode bridge.
2023-11-28 Deleted an old version of the heater.
    [JST-VH-2.stp, SOT23.STEP, dc_dc.step, heater.kicad_pcb, heater.kicad_sch, sim.kicad_pcb, sim.kicad_sch]
2023-11-28 Generated gerbers for heater
    [bom.csv, designators.csv, positions.csv]
2023-11-29 Minor silkscreen tweak.
    [designators.csv, heater.kicad_pcb]
2023-12-14 First step in adapting to the new markers format.
    [heater.kicad_pcb, heater.kicad_sch]
2023-12-18 Tweaked the blue led blinking.
2023-12-19 Increased the speed of the blue LED during recording..
